LineChef/G2bittlex/bittle_pi_addon/doc/06_open.png

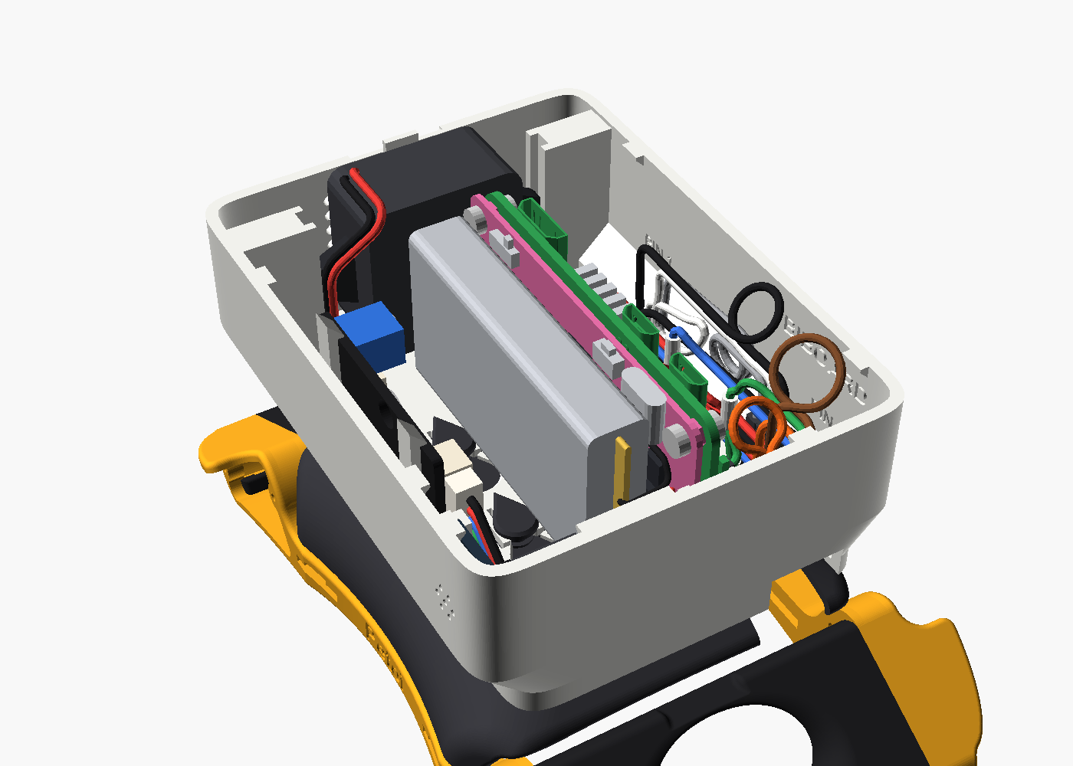
bittle_pi_addon/doc/06_open.png
