LineChef/G2bittlex/bittle_pi_addon/doc/08_section.png

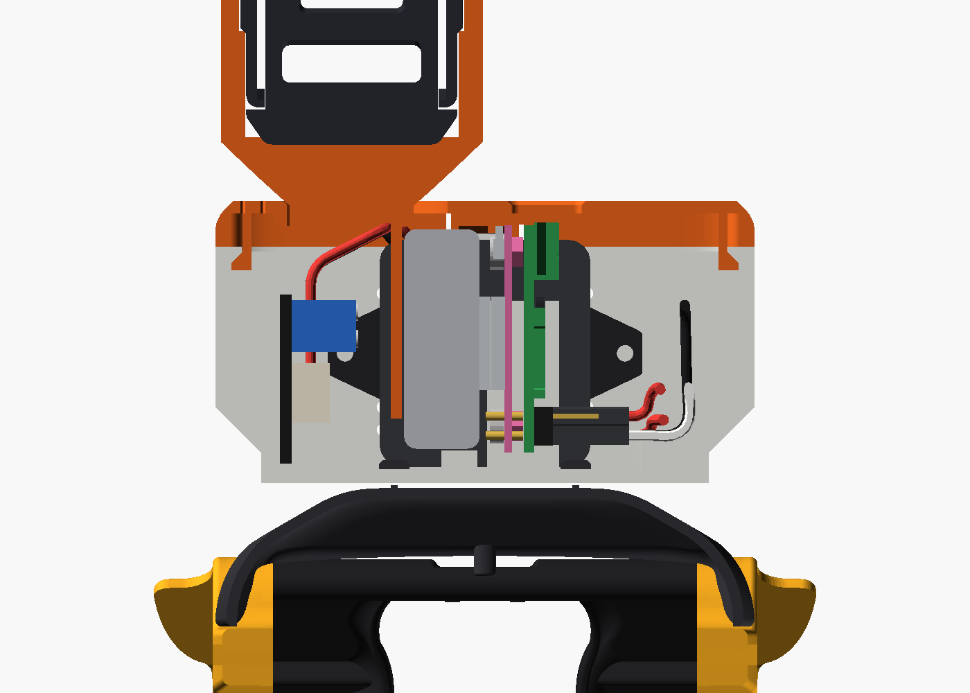
bittle_pi_addon/doc/08_section.png
