LineChef/G2bittlex/bittle_pi_addon/doc/09_wires.png

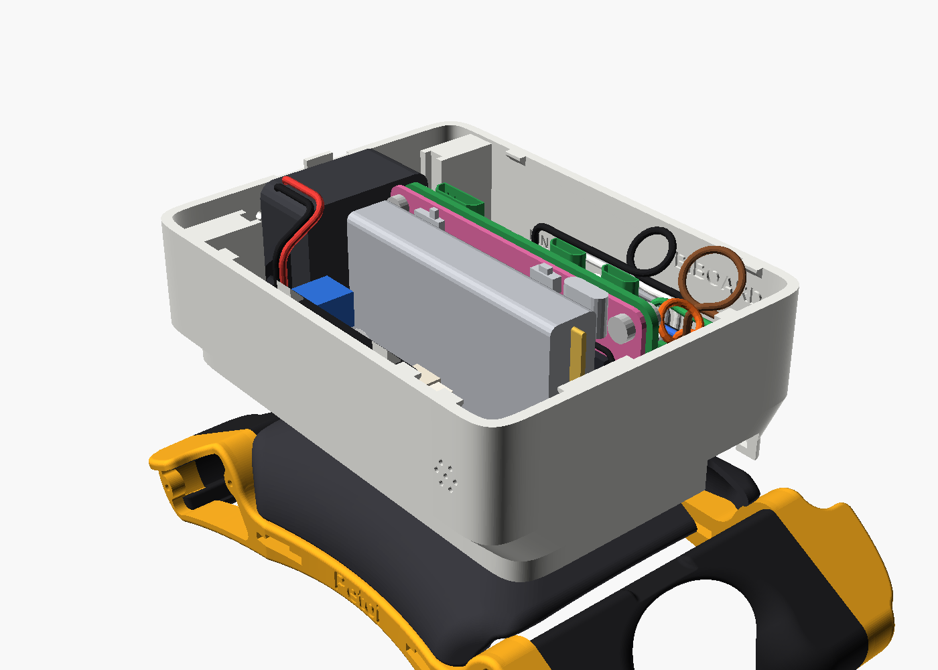
bittle_pi_addon/doc/09_wires.png
