LineChef/G2bittlex/bittle_pi_addon/doc/10_exploded.png

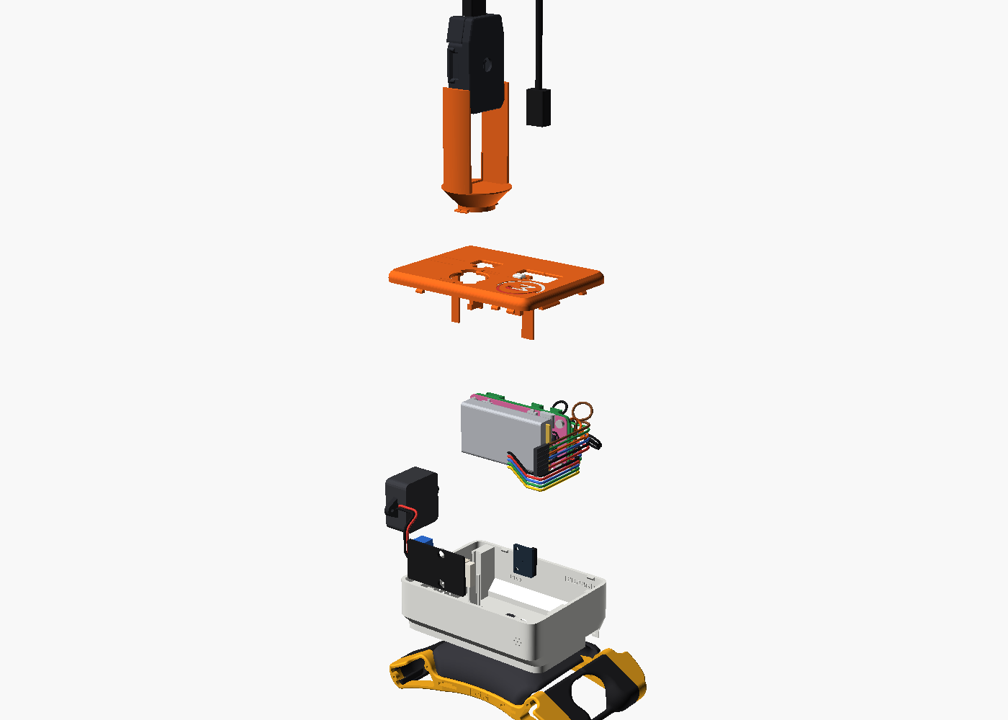
bittle_pi_addon/doc/10_exploded.png
