LineChef/G2bittlex/bittle_pi_addon/doc/11_wires_top.png

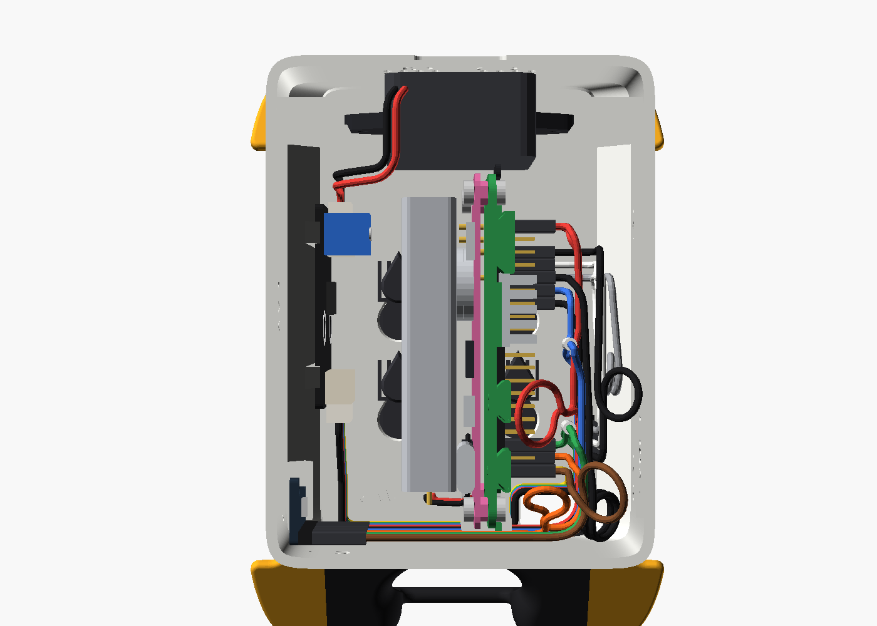
bittle_pi_addon/doc/11_wires_top.png
