LineChef/G2bittlex/bittle_pi_addon/doc/13_routing_top.png

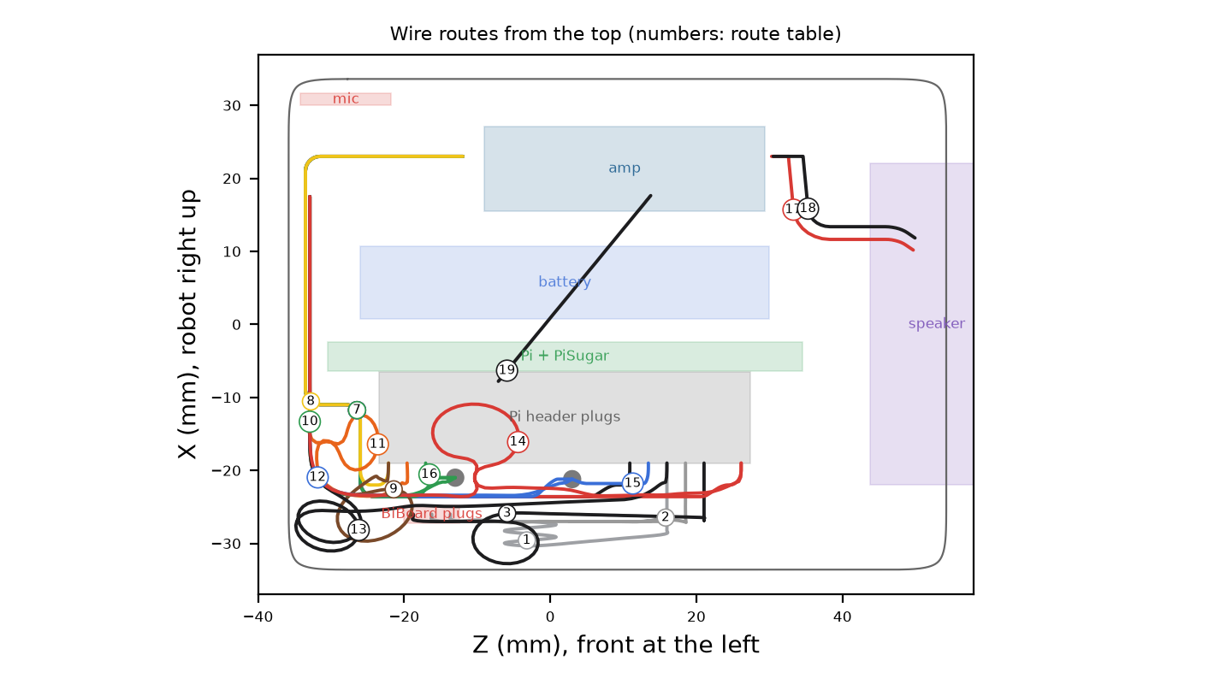
bittle_pi_addon/doc/13_routing_top.png
