LineChef/G2bittlex/bittle_pi_addon/doc/14_routing_side.png

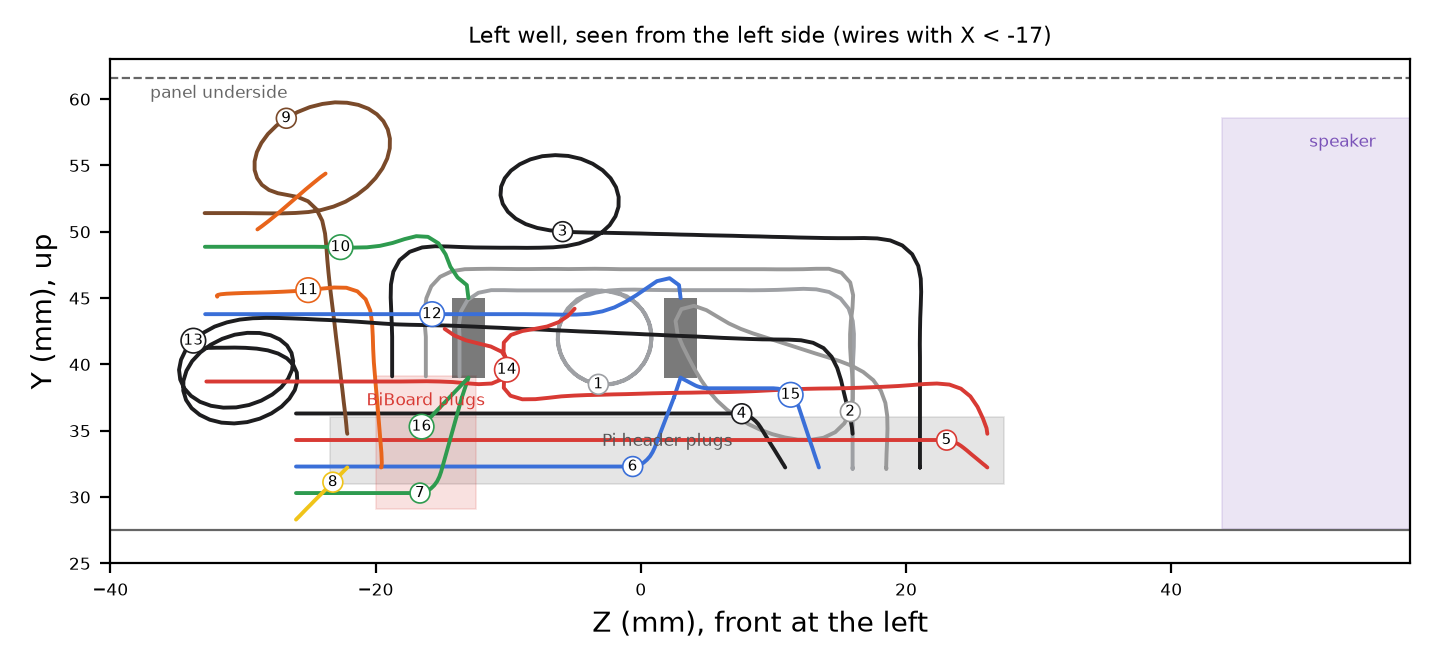
bittle_pi_addon/doc/14_routing_side.png
