LineChef/G2bittlex/bittle_pi_addon/doc/16_camera_cable.png

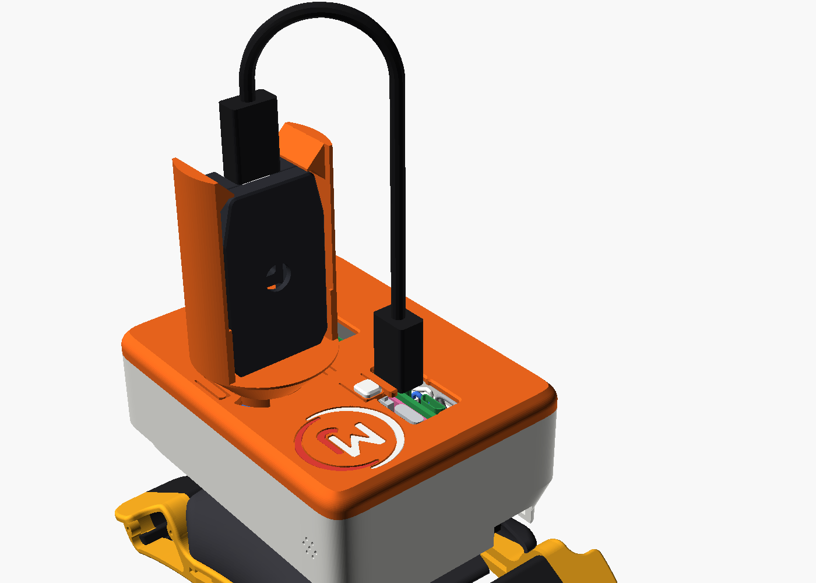
bittle_pi_addon/doc/16_camera_cable.png
