LineChef/G2bittlex/bittle_pi_addon/doc/17_camera_low.png

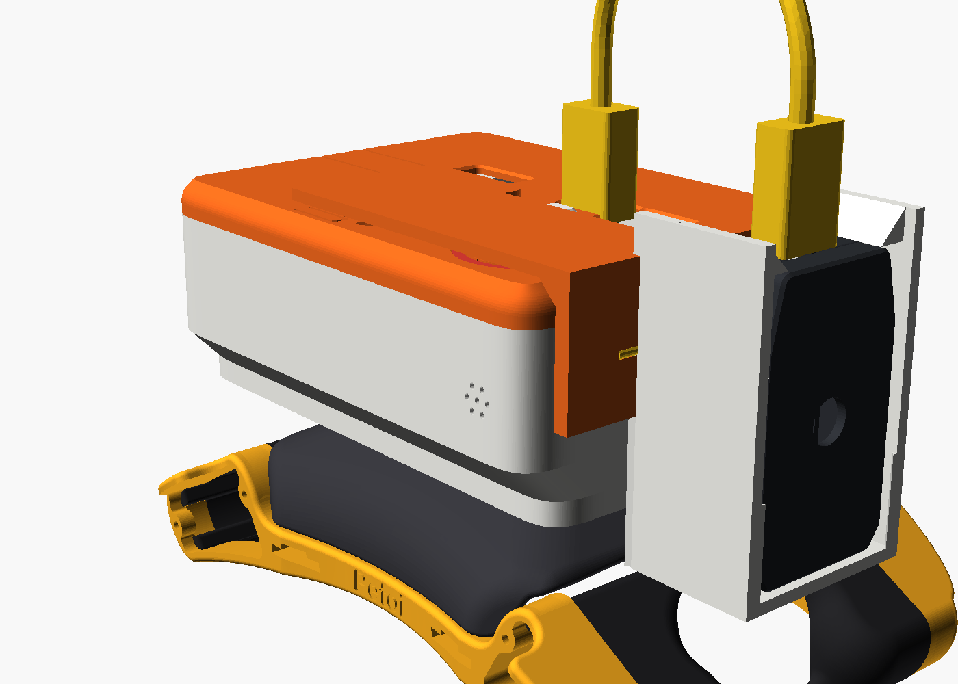
bittle_pi_addon/doc/17_camera_low.png
