LineChef/G2bittlex/bittle_pi_addon/doc/iso/camera_low-dark.png

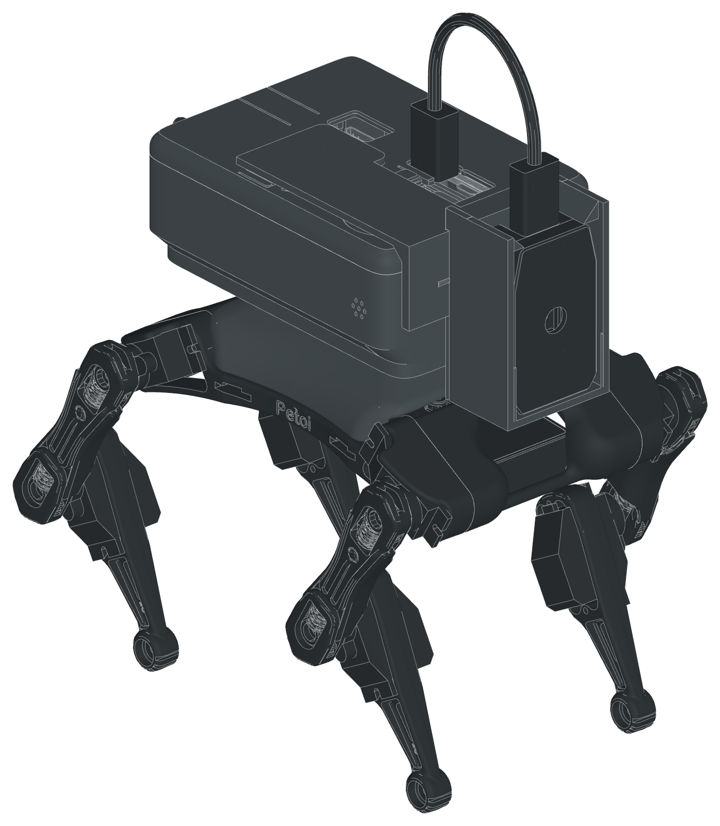
bittle_pi_addon/doc/iso/camera_low-dark.png
