LineChef/G2bittlex/bittle_pi_addon/doc/iso/hero-dark.png

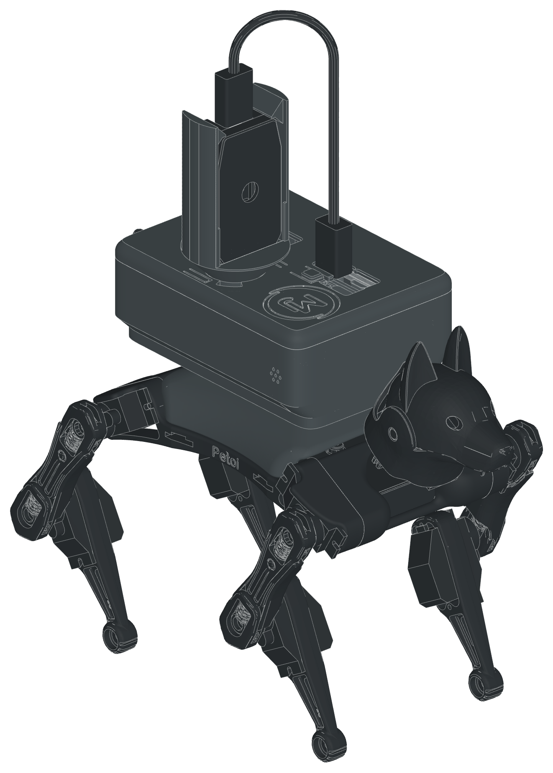
bittle_pi_addon/doc/iso/hero-dark.png
