LineChef/G2bittlex/bittle_pi_addon/doc/iso/open-dark.png

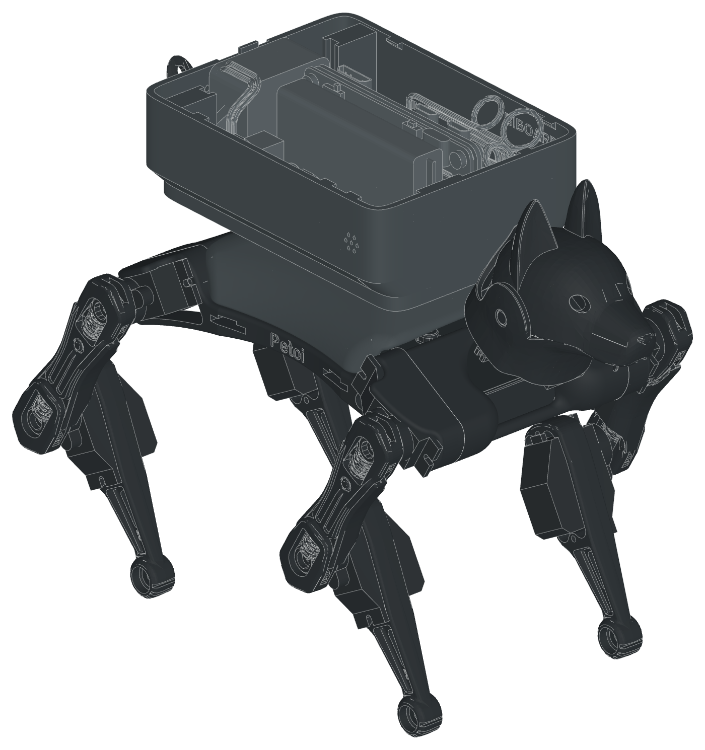
bittle_pi_addon/doc/iso/open-dark.png
