LineChef/G2bittlex/bittle_pi_addon/doc/iso/top-dark.png

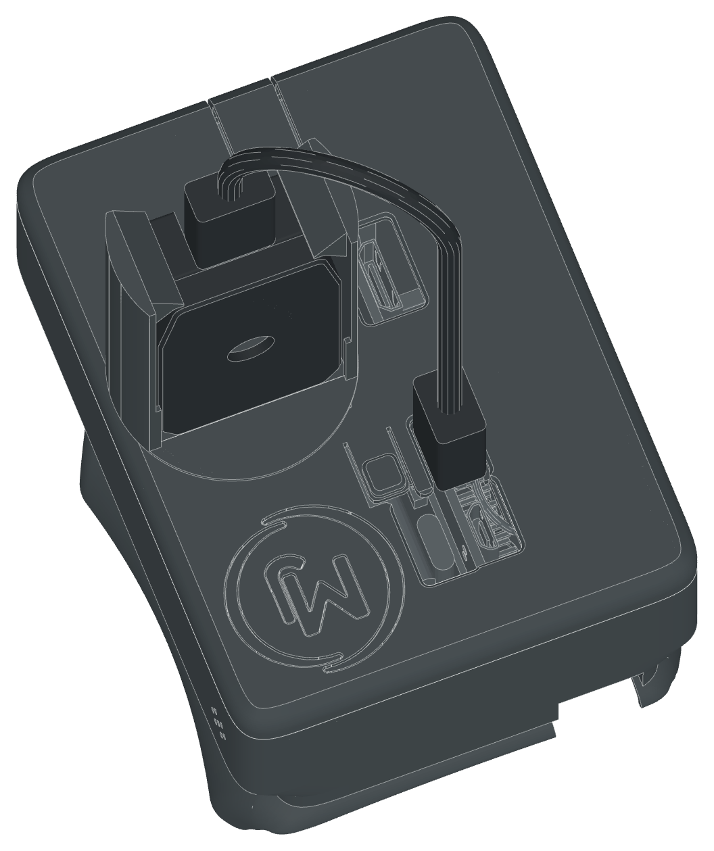
bittle_pi_addon/doc/iso/top-dark.png
