LineChef/G2bittlex/bittle_platform/doc/iso/platform-dark.png

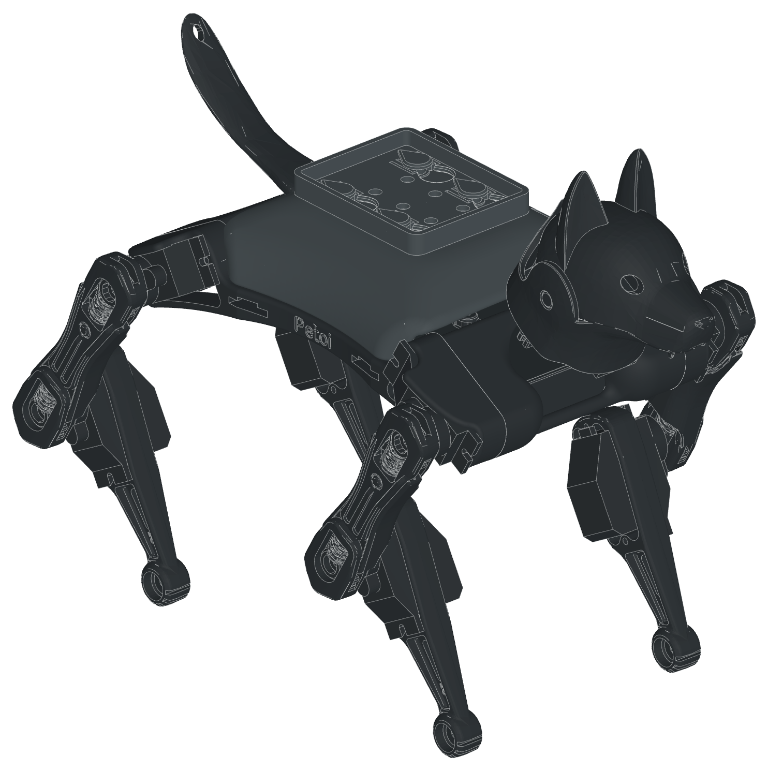
bittle_platform/doc/iso/platform-dark.png
