LineChef/G2bittlex/bittle_pi_addon/cad/pod_panel.step

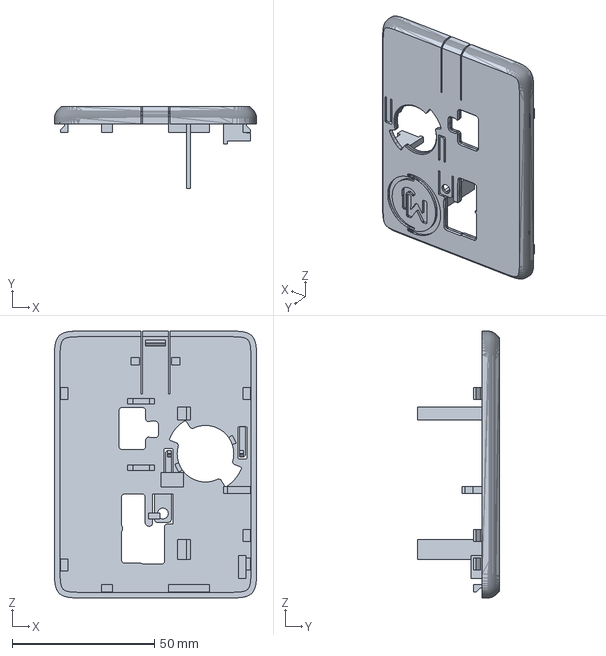
[picture p55: CAD file, 2026-10-18]
bittle_pi_addon/cad/pod_panel.step
71.2 x 28.7 x 94.0 mm
