LineChef/G2bittlex/bittle_pi_addon/reference/RaspberryPiZeroW-1.STL

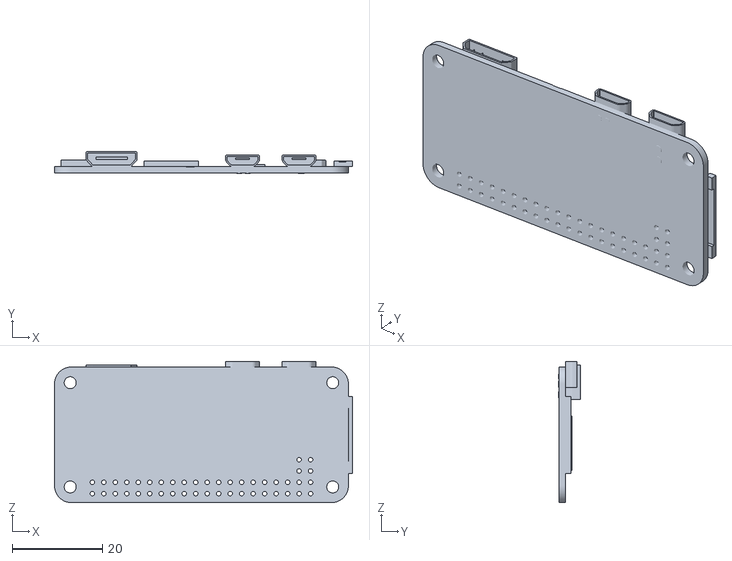
[picture p56: CAD file, 2026-10-14]
bittle_pi_addon/reference/RaspberryPiZeroW-1.STL
65.9 x 4.80 x 31.2
