LineChef/G2bittlex/bittle_pi_addon/stl/models/battery.stl

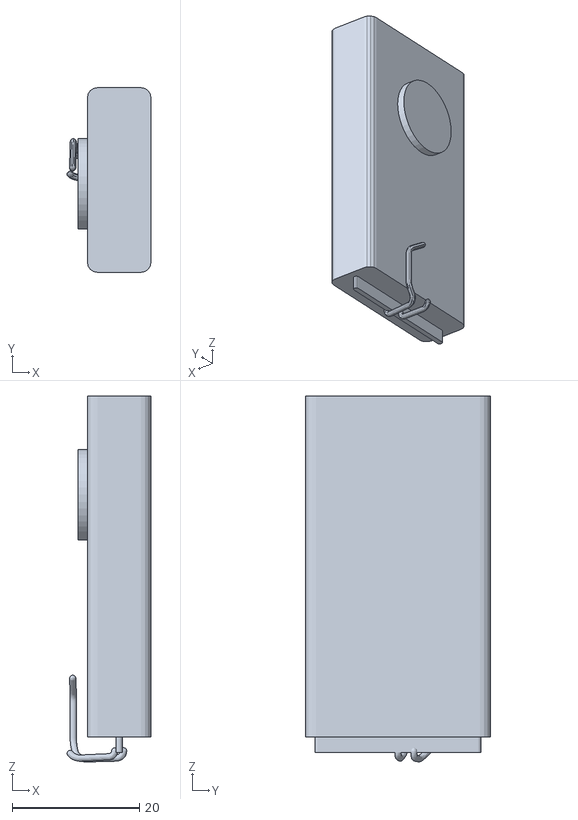
[picture p57: CAD file, 2026-10-18]
bittle_pi_addon/stl/models/battery.stl
13.2 x 29.0 x 57.5
