LineChef/G2bittlex/bittle_pi_addon/stl/models/parts/pisugar_s__button.stl

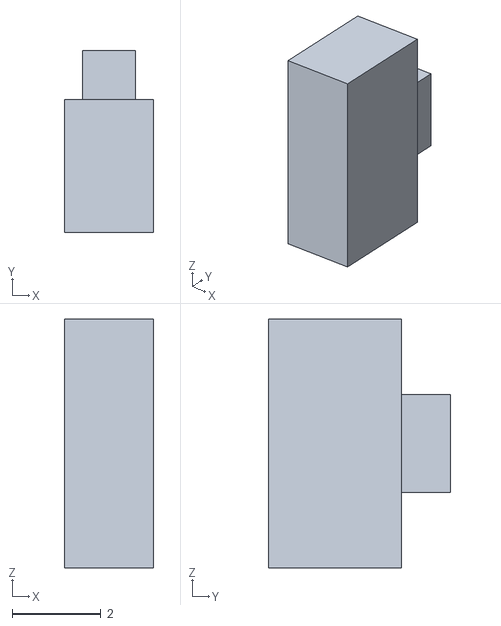
[picture p58: CAD file, 2026-10-18]
bittle_pi_addon/stl/models/parts/pisugar_s__button.stl
2.00 x 4.10 x 5.60
