LineChef/G2bittlex/bittle_pi_addon/stl/print/pod_logo_red.stl

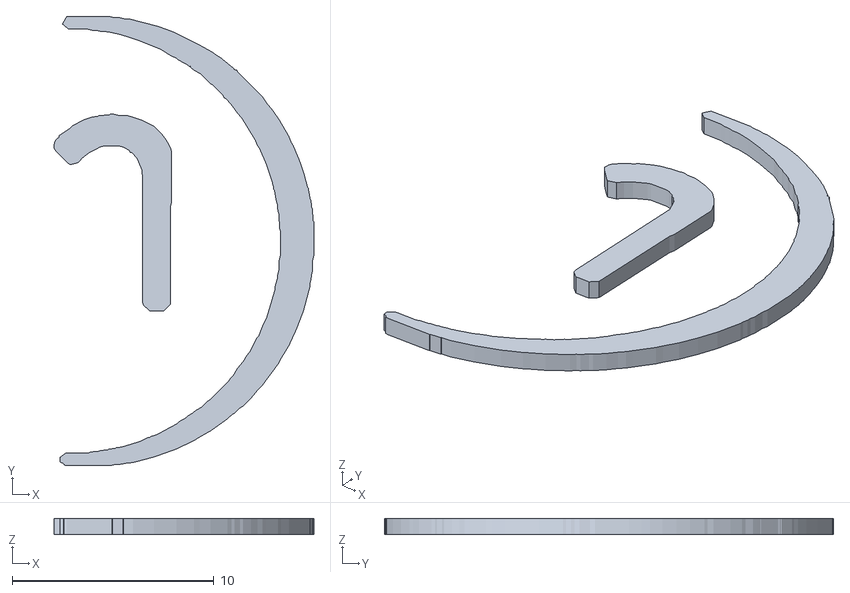
[picture p59: CAD file, 2026-10-16]
bittle_pi_addon/stl/print/pod_logo_red.stl
12.9 x 22.3 x 0.8
