LineChef/G2bittlex/bittle_platform/reference/Bittle_tail.stl

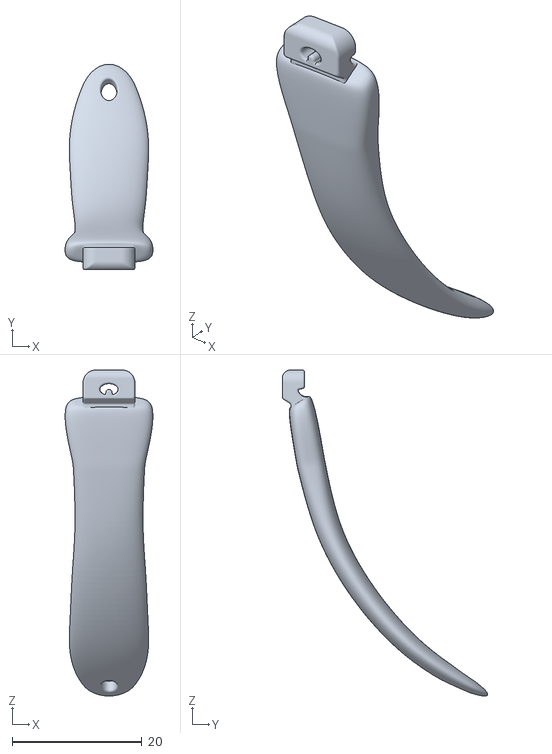
[picture p61: CAD file, 2026-10-14]
bittle_platform/reference/Bittle_tail.stl
13.5 x 31.7 x 50.2
