LineChef/G2bittlex/bittle_platform/reference/petoi_ros/tube_lf_1.stl

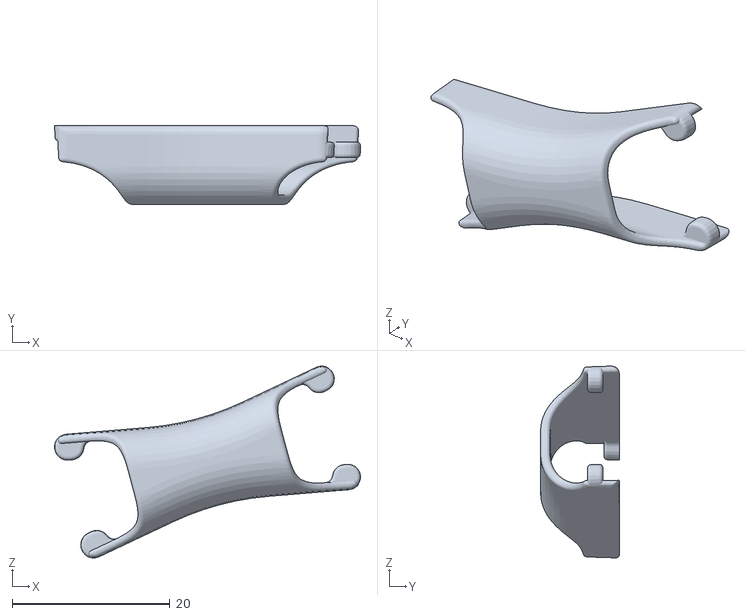
[picture p62: CAD file, 2026-10-14]
bittle_platform/reference/petoi_ros/tube_lf_1.stl
38.8 x 10.0 x 24.4
