LineChef/G2bittlex/bittle_platform/stl/installed/cover_pegs.stl

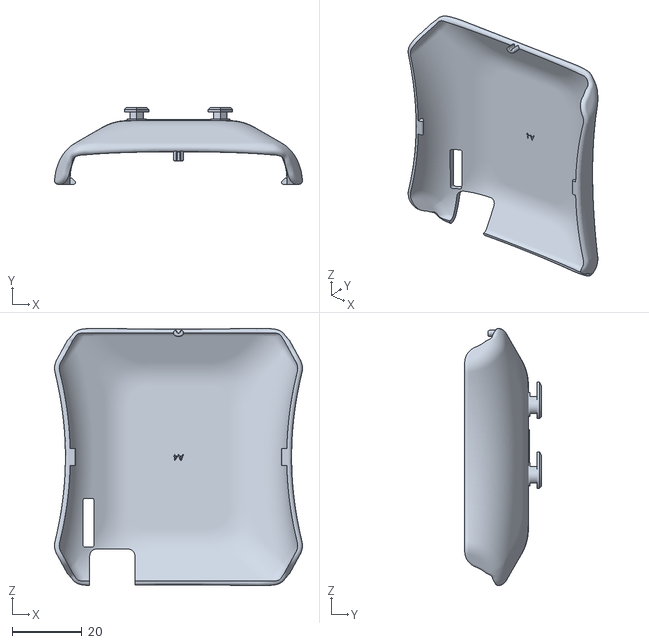
[picture p63: CAD file, 2026-10-16]
bittle_platform/stl/installed/cover_pegs.stl
71.2 x 22.0 x 73.9
