LineChef/G2bittlex/bittle_platform/stl/robot/head.stl

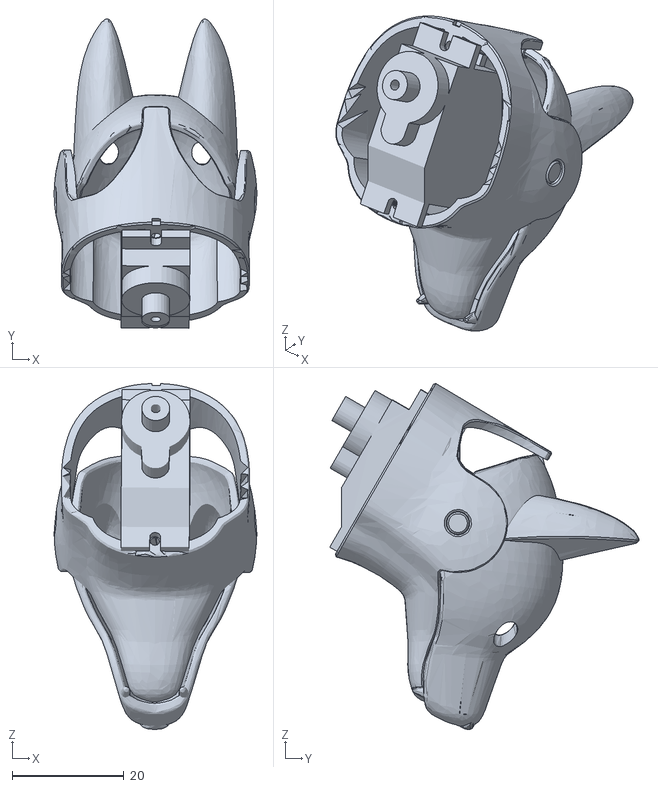
[picture p64: CAD file, 2026-10-14]
bittle_platform/stl/robot/head.stl
36.2 x 55.3 x 61.8
