LineChef/G2bittlex/bittle_pi_addon/cad/pod_camera_cradle_low.step

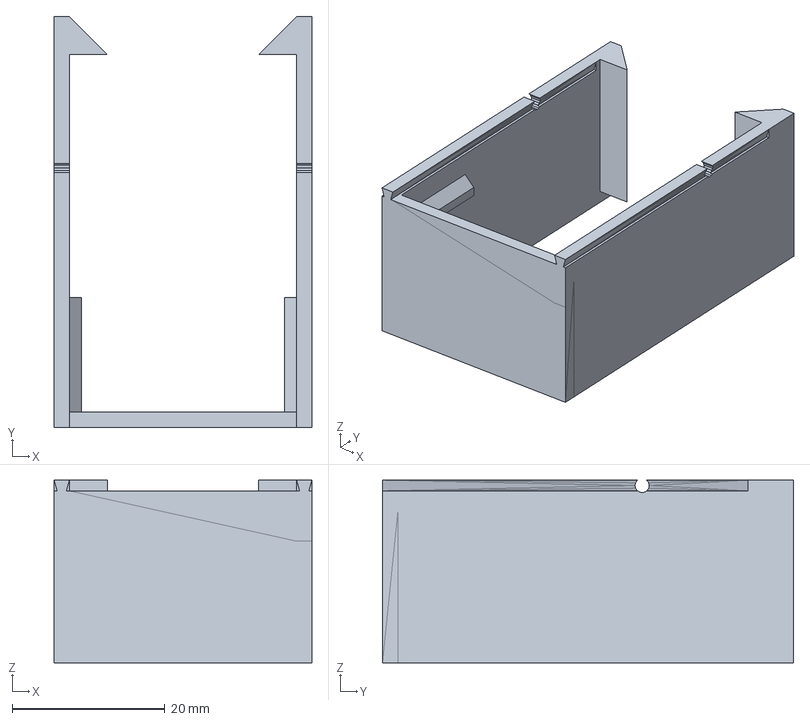
[picture p65: CAD file, 2026-10-17]
bittle_pi_addon/cad/pod_camera_cradle_low.step
33.8 x 53.9 x 24.0 mm
