LineChef/G2bittlex/bittle_pi_addon/stl/models/parts/pisugar_s__pins.stl

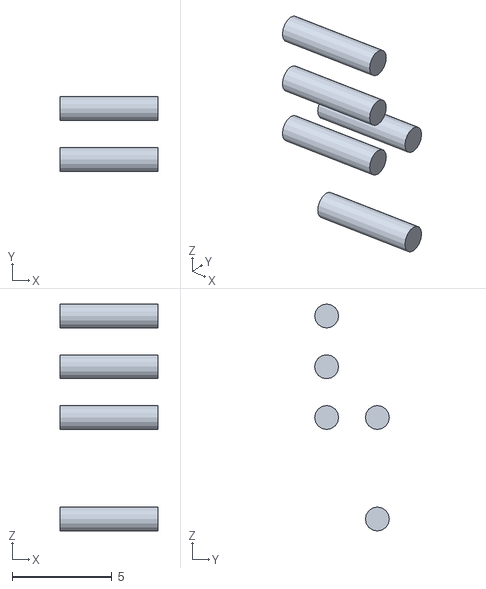
[picture p66: CAD file, 2026-10-18]
bittle_pi_addon/stl/models/parts/pisugar_s__pins.stl
4.90 x 3.74 x 11.4
