LineChef/G2bittlex/bittle_pi_addon/stl/models/pisugar_s.stl

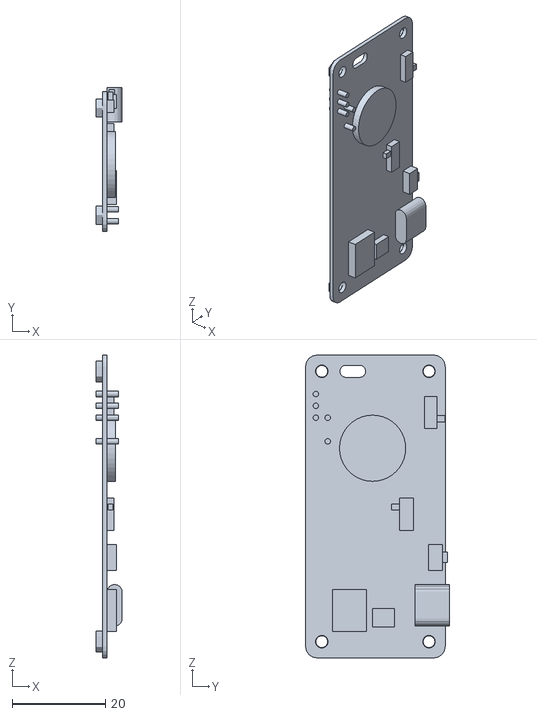
[picture p67: CAD file, 2026-10-18]
bittle_pi_addon/stl/models/pisugar_s.stl
5.66 x 30.9 x 65.0
