LineChef/G2bittlex/bittle_pi_addon/stl/print/pod_logo_white.stl

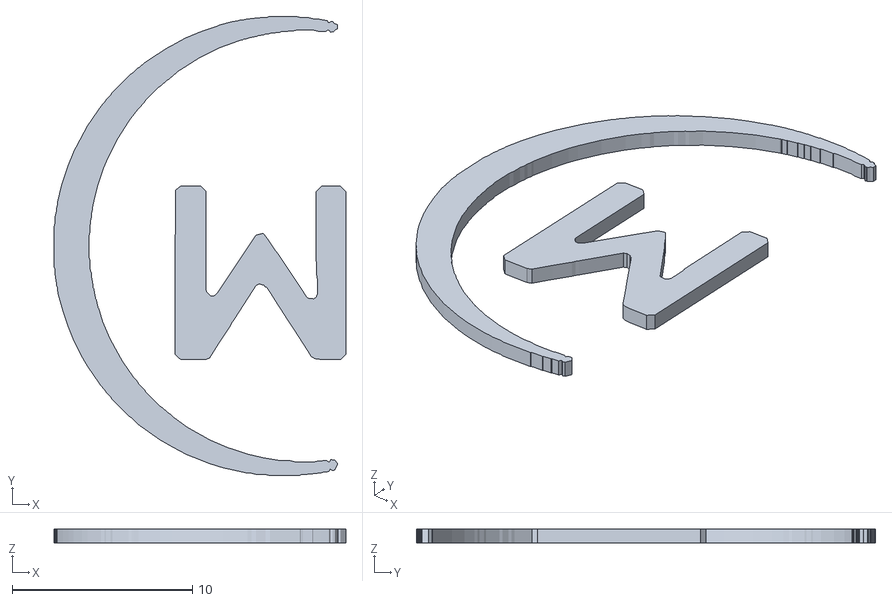
[picture p68: CAD file, 2026-10-16]
bittle_pi_addon/stl/print/pod_logo_white.stl
16.2 x 25.4 x 0.8
