LineChef/G2bittlex/bittle_platform/cad/pegs.step

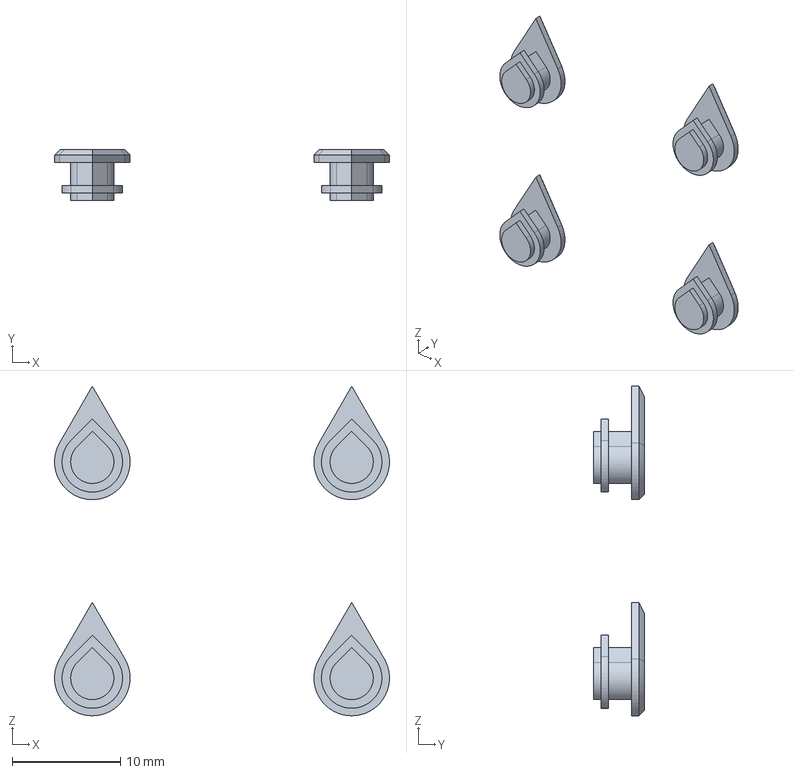
[picture p69: CAD file, 2026-10-16]
bittle_platform/cad/pegs.step
31.0 x 4.70 x 30.5 mm
