LineChef/G2bittlex/bittle_platform/reference/Bittle_Cover.stl

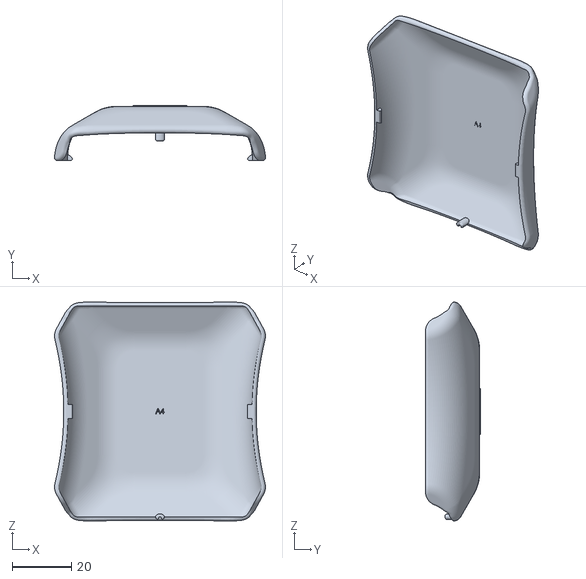
[picture p70: CAD file, 2026-10-14]
bittle_platform/reference/Bittle_Cover.stl
71.2 x 18.6 x 73.9
