LineChef/G2bittlex/bittle_platform/reference/petoi_ros/servo_lfs_1.stl

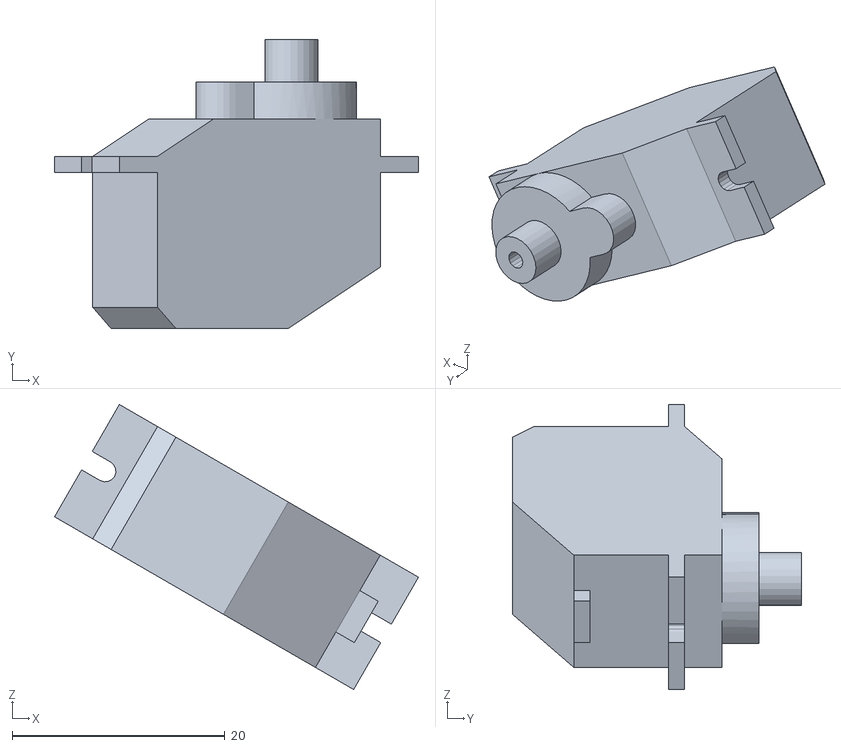
[picture p71: CAD file, 2026-10-14]
bittle_platform/reference/petoi_ros/servo_lfs_1.stl
34.2 x 27.2 x 26.8
