LineChef/G2bittlex/bittle_platform/stl/installed/keepout.stl

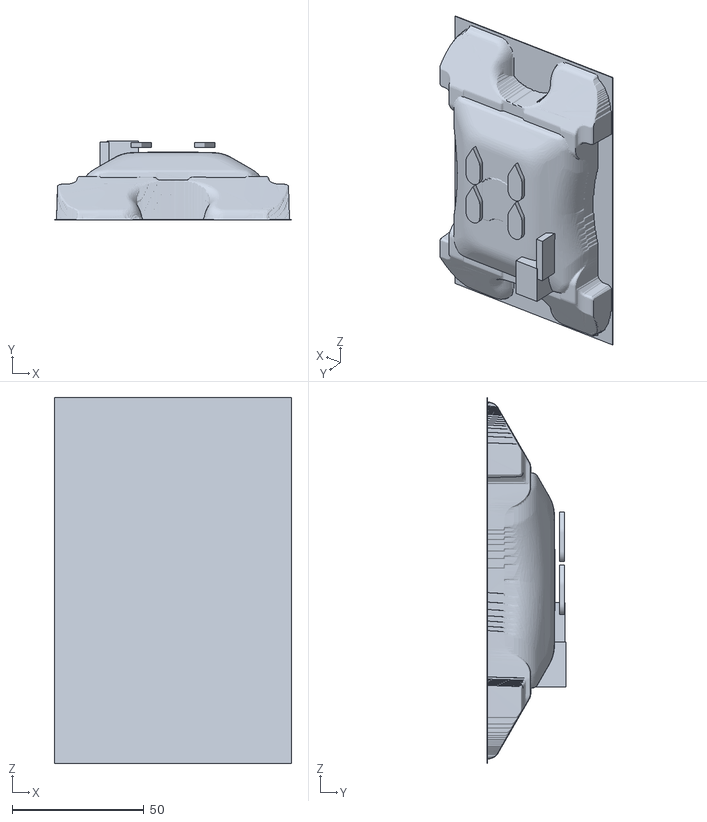
[picture p72: CAD file, 2026-10-16]
bittle_platform/stl/installed/keepout.stl
90.0 x 30.0 x 138.8
