LineChef/G2bittlex/bittle_platform/stl/robot/hip_servos.stl

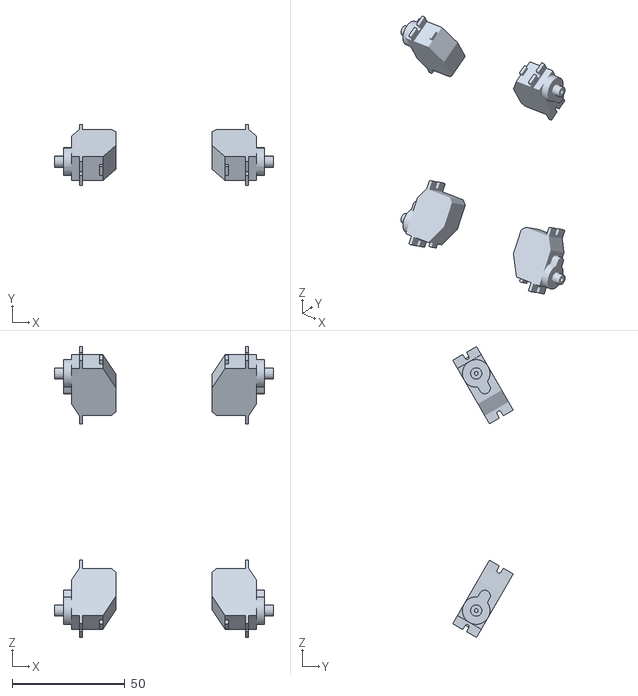
[picture p74: CAD file, 2026-10-14]
bittle_platform/stl/robot/hip_servos.stl
97.0 x 26.8 x 128.9
