LineChef/G2bittlex/bittle_pi_addon/cad/pod_button.step

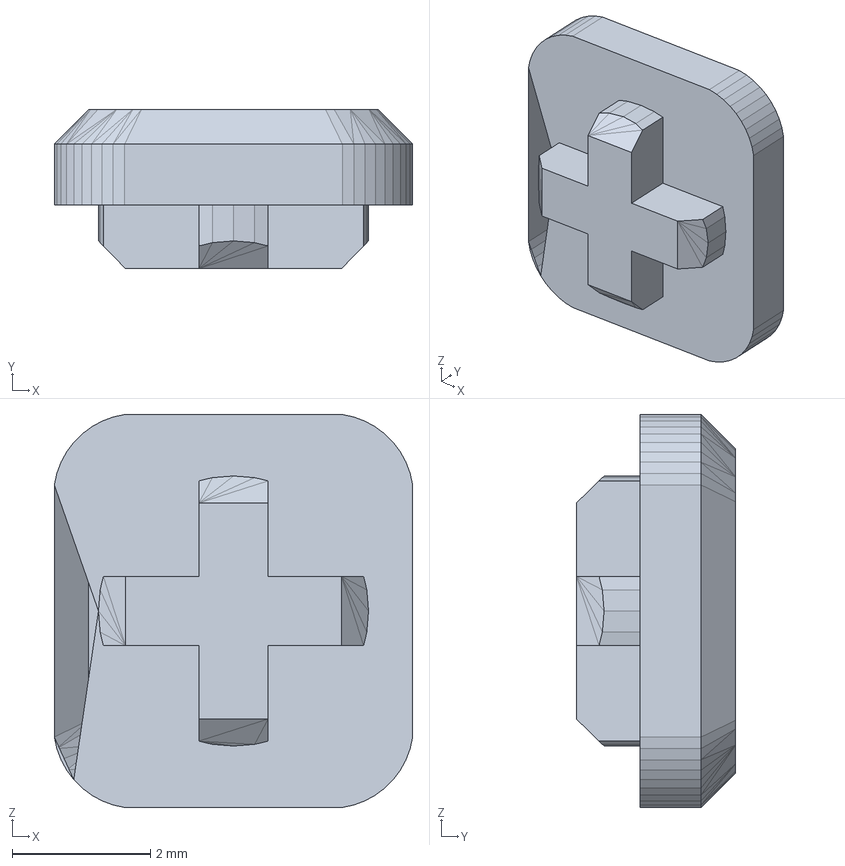
[picture p75: CAD file, 2026-10-17]
bittle_pi_addon/cad/pod_button.step
5.18 x 2.30 x 5.68 mm
