LineChef/G2bittlex/bittle_pi_addon/stl/models/camera.stl

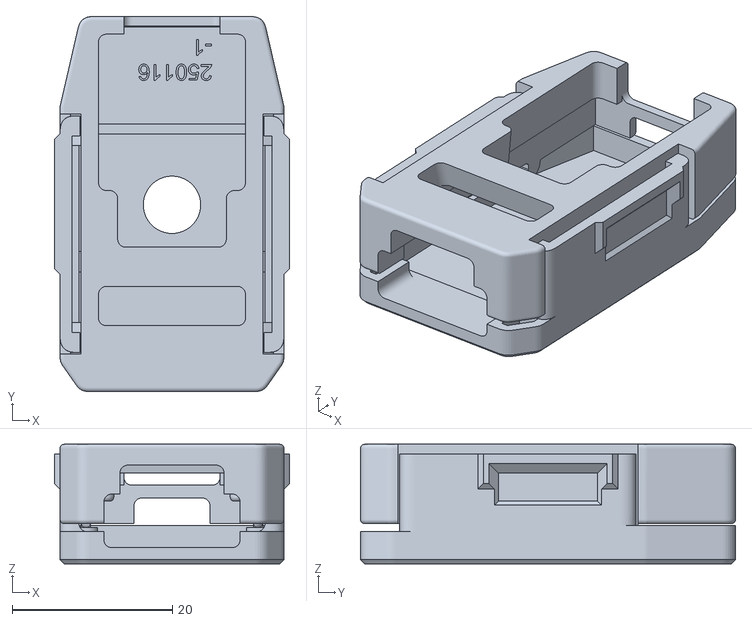
[picture p76: CAD file, 2026-10-17]
bittle_pi_addon/stl/models/camera.stl
29.3 x 46.8 x 14.9
