LineChef/G2bittlex/bittle_pi_addon/stl/models/parts/pisugar_s__usb_c.stl

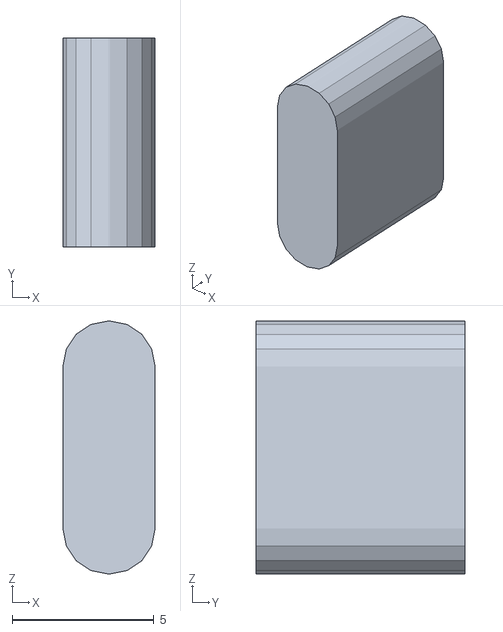
[picture p77: CAD file, 2026-10-18]
bittle_pi_addon/stl/models/parts/pisugar_s__usb_c.stl
3.26 x 7.40 x 8.94
