LineChef/G2bittlex/bittle_platform/cad/starter_plate.step

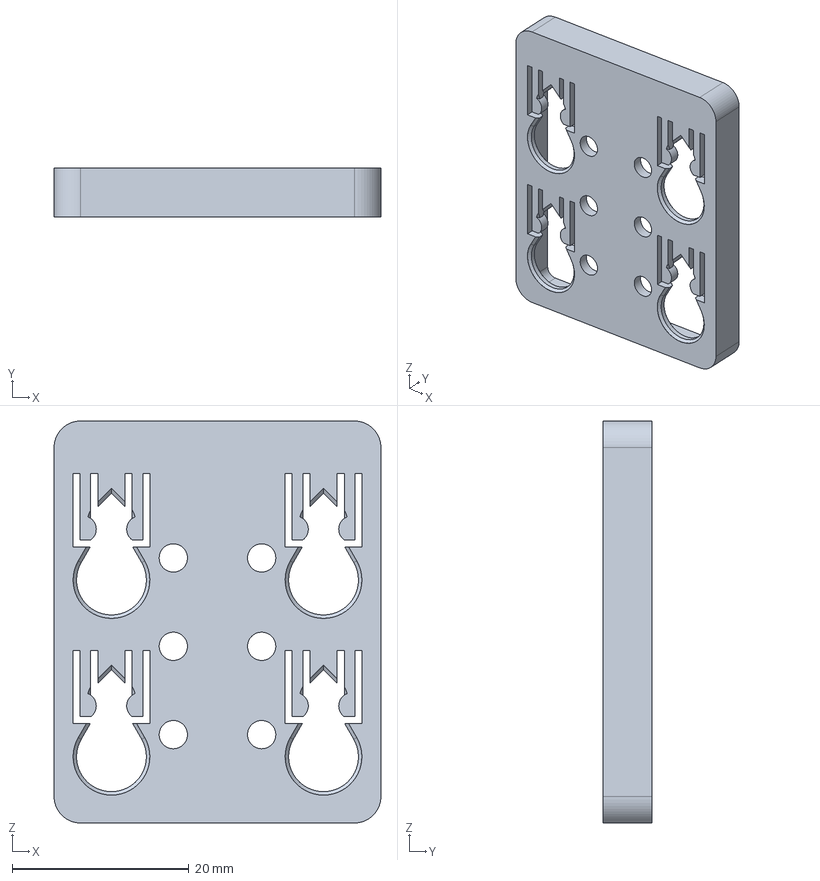
[picture p78: CAD file, 2026-10-16]
bittle_platform/cad/starter_plate.step
37.0 x 5.50 x 45.5 mm
