LineChef/G2bittlex/bittle_platform/reference/Bittle_FrontPlate.stl

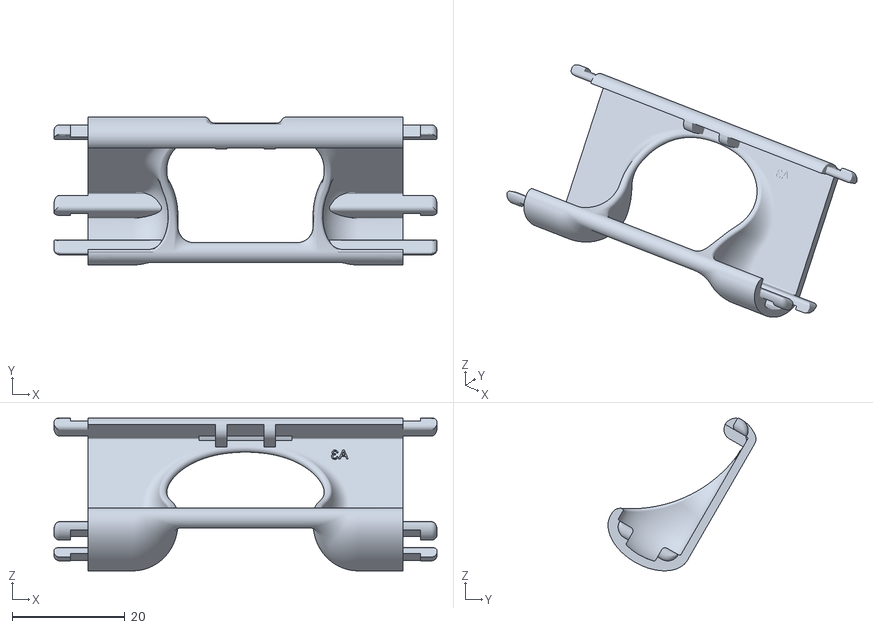
[picture p79: CAD file, 2026-10-14]
bittle_platform/reference/Bittle_FrontPlate.stl
68.0 x 26.3 x 27.1
