LineChef/G2bittlex/bittle_platform/reference/petoi_ros/c_thlf_1.stl

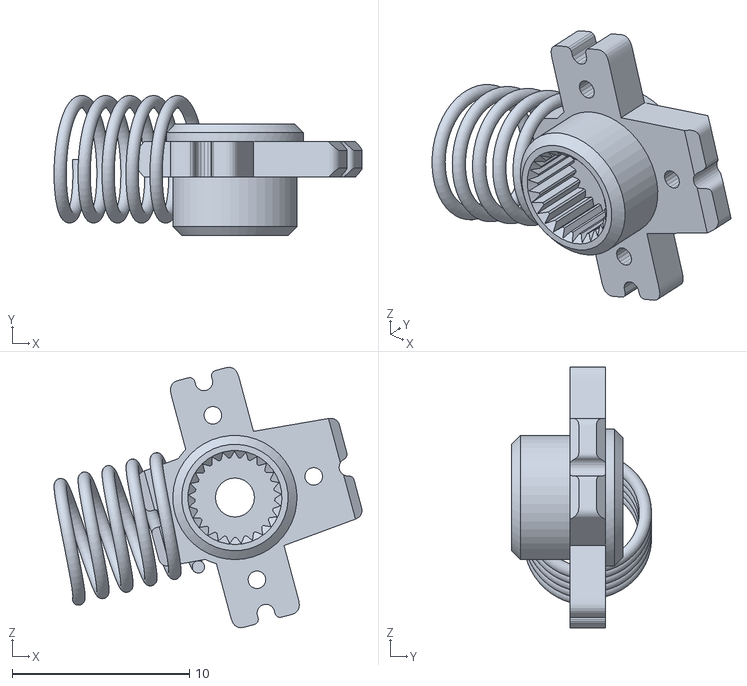
[picture p80: CAD file, 2026-10-14]
bittle_platform/reference/petoi_ros/c_thlf_1.stl
17.4 x 7.91 x 14.7
