LineChef/G2bittlex/bittle_platform/stl/robot/thigh_rf.stl

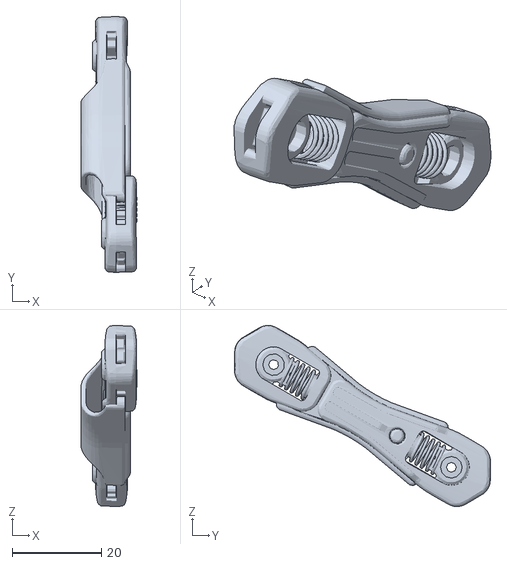
[picture p81: CAD file, 2026-10-14]
bittle_platform/stl/robot/thigh_rf.stl
12.6 x 57.4 x 40.6
