LineChef/G2bittlex/bittle_pi_addon/cad/pod_body.step

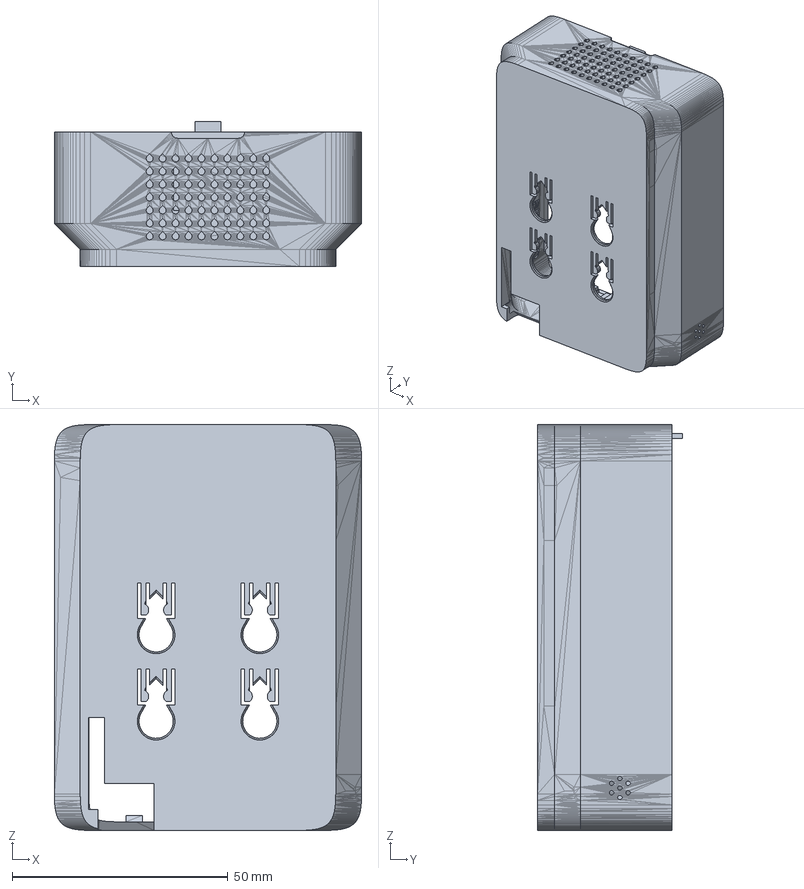
[picture p82: CAD file, 2026-10-17]
bittle_pi_addon/cad/pod_body.step
71.2 x 33.6 x 94.0 mm
