LineChef/G2bittlex/bittle_pi_addon/stl/installed/pod_camera_base_low.stl

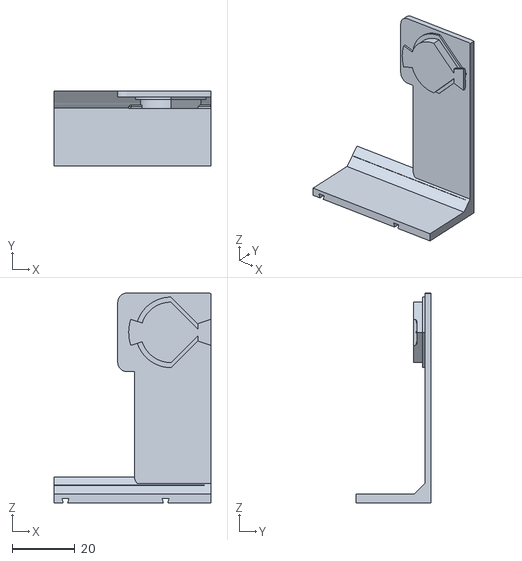
[picture p83: CAD file, 2026-10-17]
bittle_pi_addon/stl/installed/pod_camera_base_low.stl
49.8 x 23.9 x 66.7
