LineChef/G2bittlex/bittle_pi_addon/stl/models/parts/battery__disc.stl

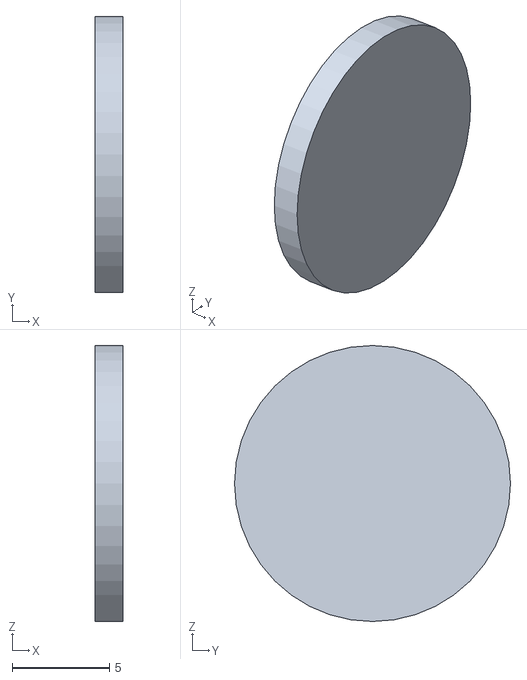
[picture p84: CAD file, 2026-10-18]
bittle_pi_addon/stl/models/parts/battery__disc.stl
1.46 x 14.2 x 14.2
