LineChef/G2bittlex/bittle_pi_addon/stl/models/wires_camera.stl

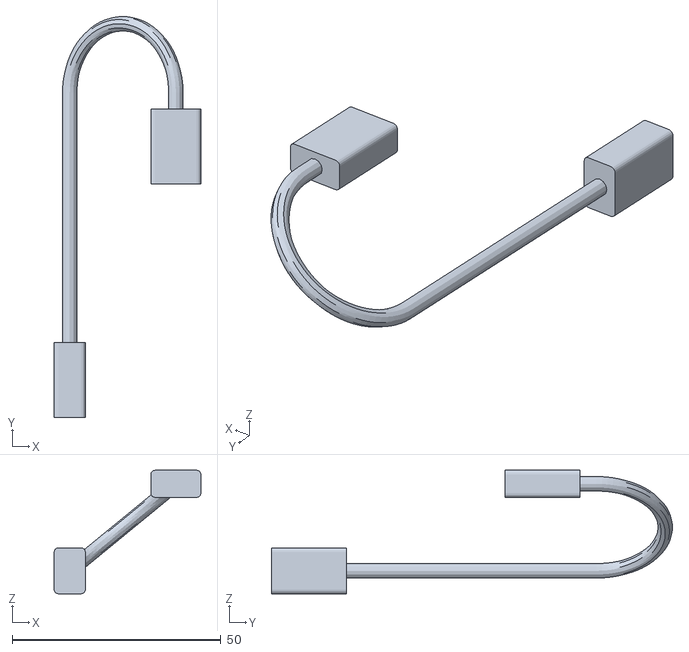
[picture p85: CAD file, 2026-10-17]
bittle_pi_addon/stl/models/wires_camera.stl
35.2 x 96.1 x 29.6
