LineChef/G2bittlex/bittle_platform/cad/keyhole_cutter.step

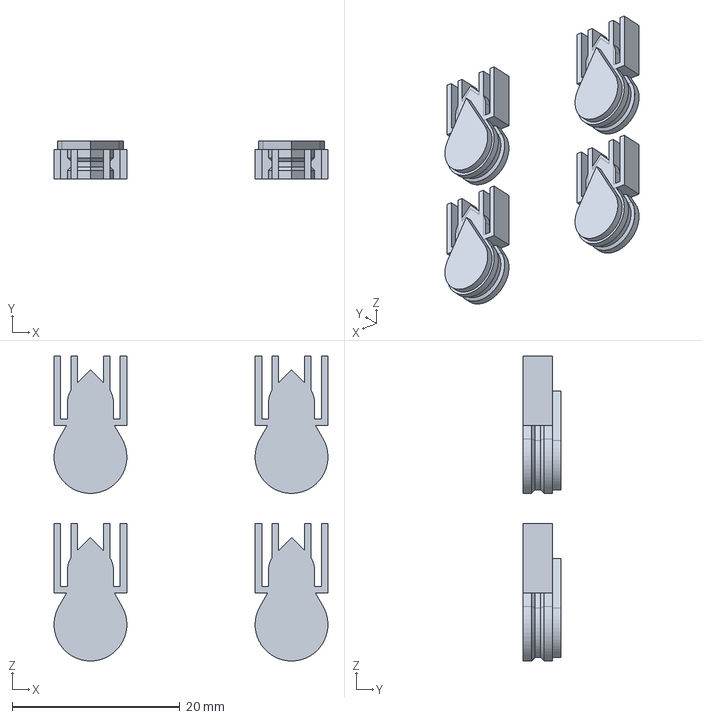
[picture p86: CAD file, 2026-10-16]
bittle_platform/cad/keyhole_cutter.step
32.7 x 4.50 x 36.4 mm
