LineChef/G2bittlex/bittle_platform/reference/Bittle_SideShoulder.stl

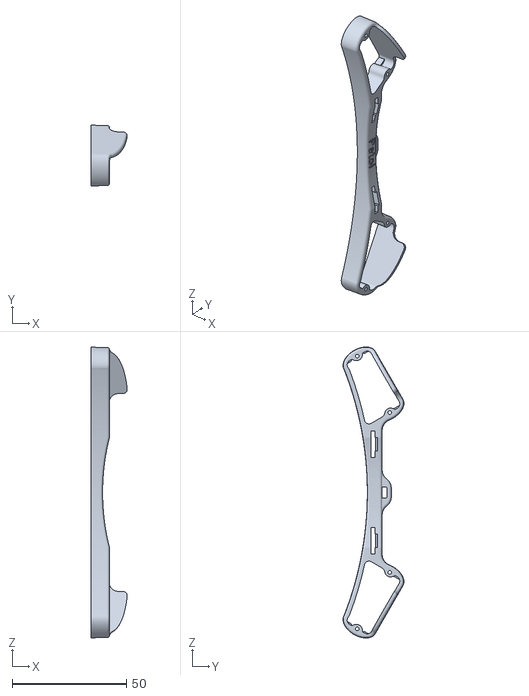
[picture p87: CAD file, 2026-10-14]
bittle_platform/reference/Bittle_SideShoulder.stl
15.9 x 26.7 x 127.3
