LineChef/G2bittlex/bittle_platform/reference/petoi_ros/servos_lf_1.stl

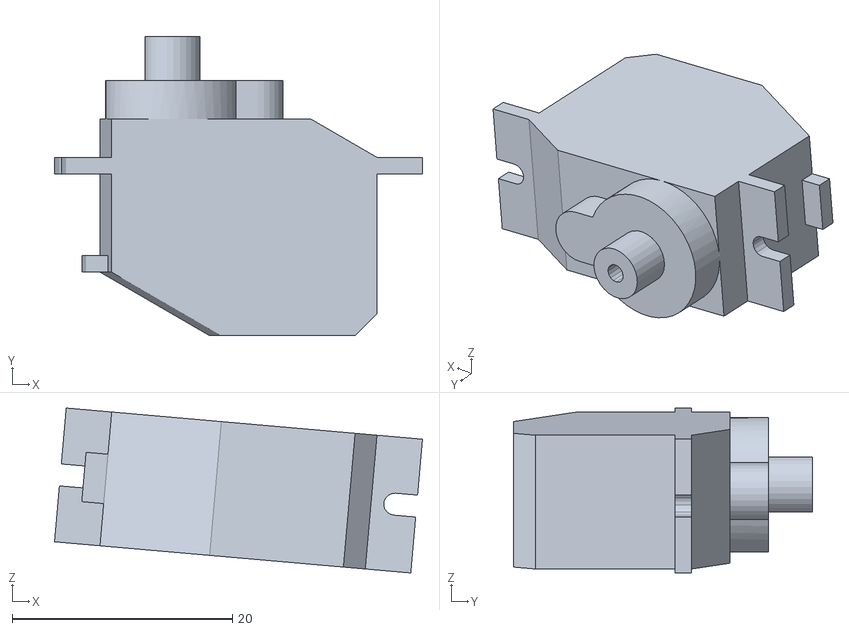
[picture p88: CAD file, 2026-10-14]
bittle_platform/reference/petoi_ros/servos_lf_1.stl
33.4 x 27.2 x 15.0
