LineChef/G2bittlex/bittle_pi_addon/cad/pod_camera_mount.step

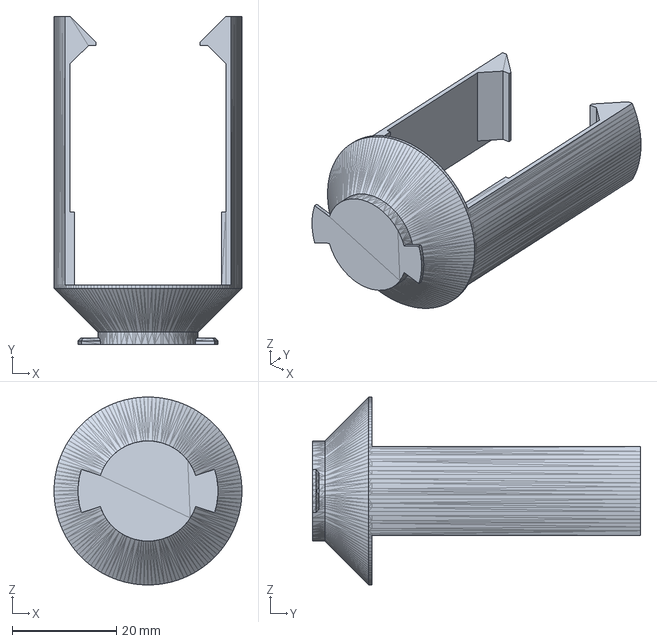
[picture p89: CAD file, 2026-10-17]
bittle_pi_addon/cad/pod_camera_mount.step
36.0 x 62.8 x 36.0 mm
