LineChef/G2bittlex/bittle_pi_addon/stl/models/parts/battery__flap.stl

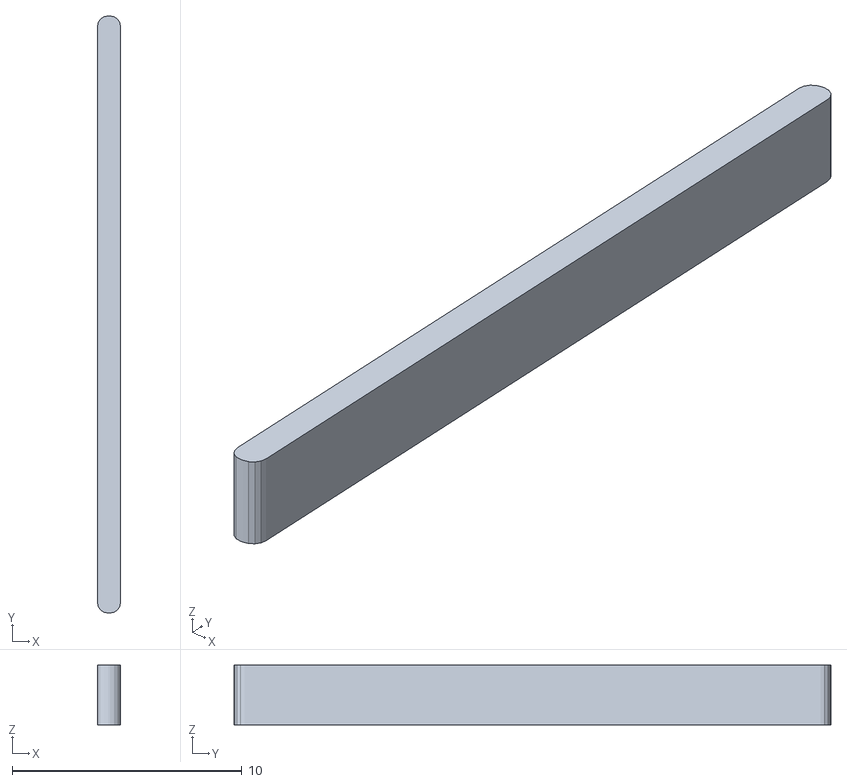
[picture p90: CAD file, 2026-10-18]
bittle_pi_addon/stl/models/parts/battery__flap.stl
1.00 x 26.0 x 2.60
