LineChef/G2bittlex/bittle_pi_addon/stl/models/wires_mic.stl

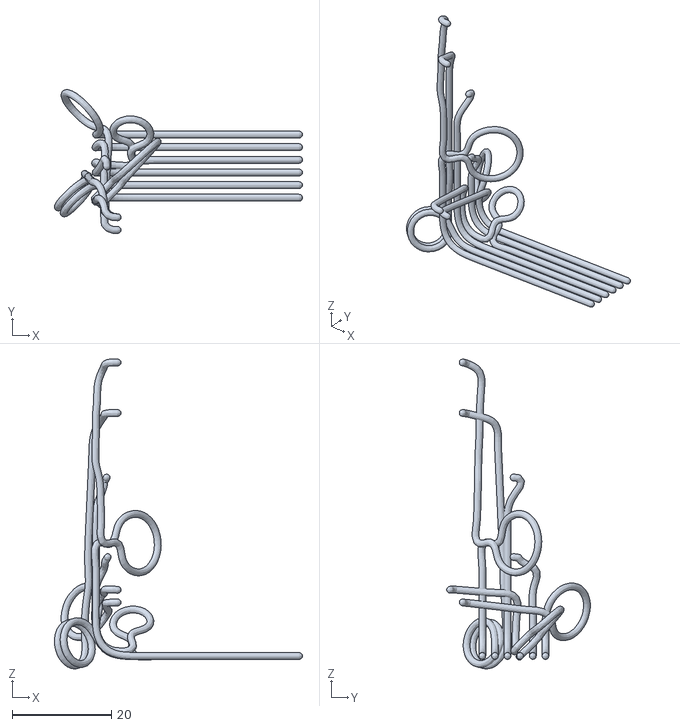
[picture p91: CAD file, 2026-10-17]
bittle_pi_addon/stl/models/wires_mic.stl
49.9 x 28.9 x 62.3
