LineChef/G2bittlex/bittle_platform/reference/petoi_ros/head__1.stl

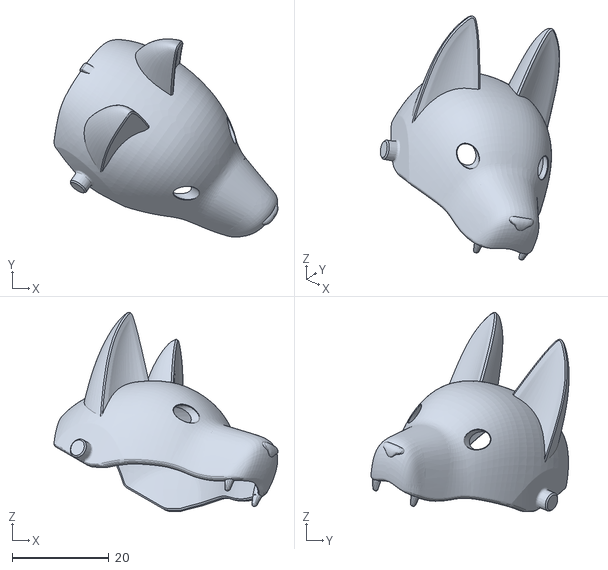
[picture p92: CAD file, 2026-10-14]
bittle_platform/reference/petoi_ros/head__1.stl
46.2 x 40.9 x 41.1
