LineChef/G2bittlex/bittle_pi_addon/stl/models/parts/battery__cell.stl

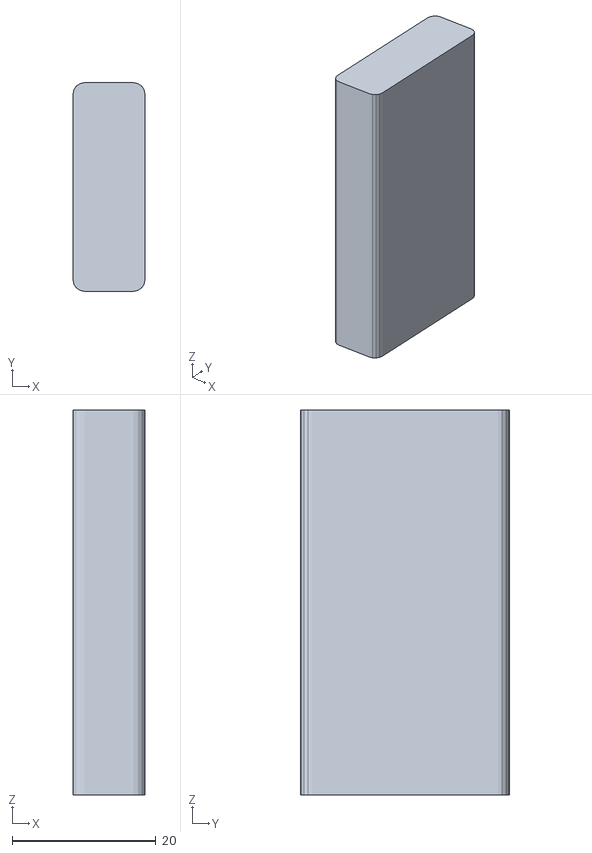
[picture p93: CAD file, 2026-10-18]
bittle_pi_addon/stl/models/parts/battery__cell.stl
10.00 x 29.0 x 53.5
