LineChef/G2bittlex/bittle_pi_addon/stl/models/wire_paths.stl

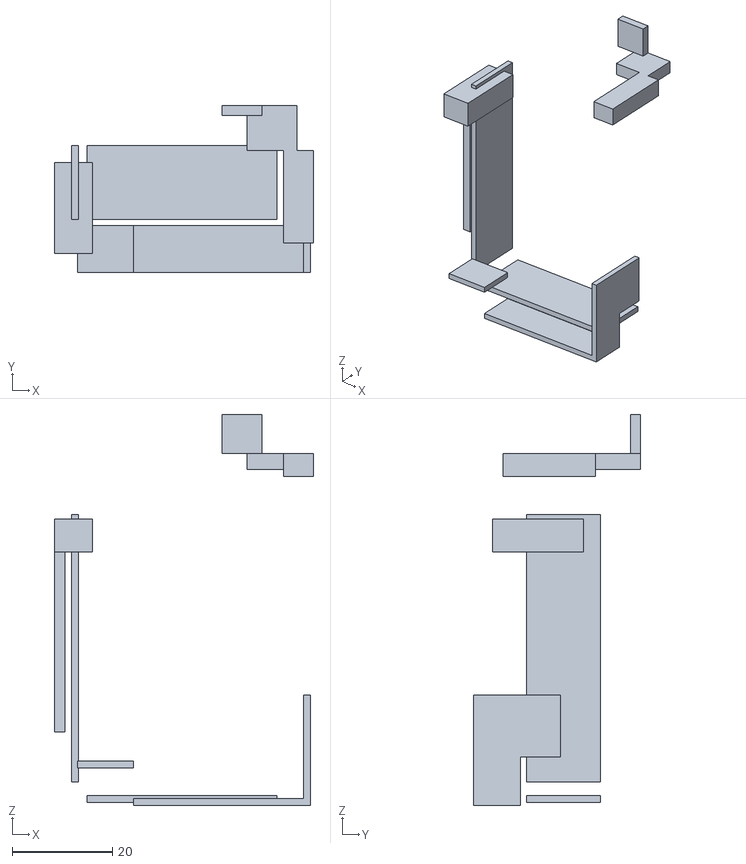
[picture p94: CAD file, 2026-10-17]
bittle_pi_addon/stl/models/wire_paths.stl
51.8 x 33.4 x 78.2
