LineChef/G2bittlex/bittle_platform/reference/petoi_ros/shank_lf_1.stl

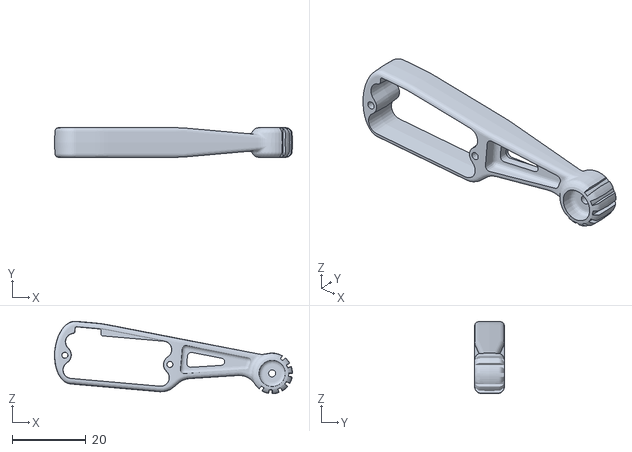
[picture p95: CAD file, 2026-10-14]
bittle_platform/reference/petoi_ros/shank_lf_1.stl
64.3 x 8.00 x 19.6
