LineChef/G2bittlex/bittle_platform/stl/robot/shank_rr.stl

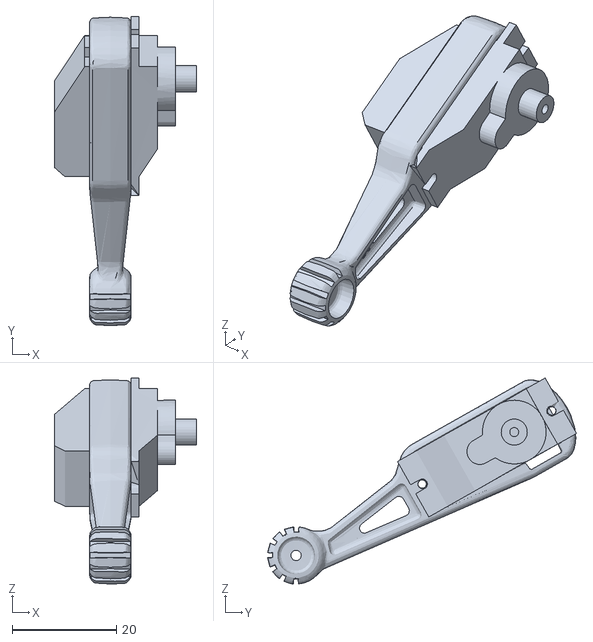
[picture p96: CAD file, 2026-10-14]
bittle_platform/stl/robot/shank_rr.stl
27.2 x 59.2 x 39.5
