LineChef/G2bittlex/bittle_pi_addon/stl/models/parts/pisugar_s__switch.stl

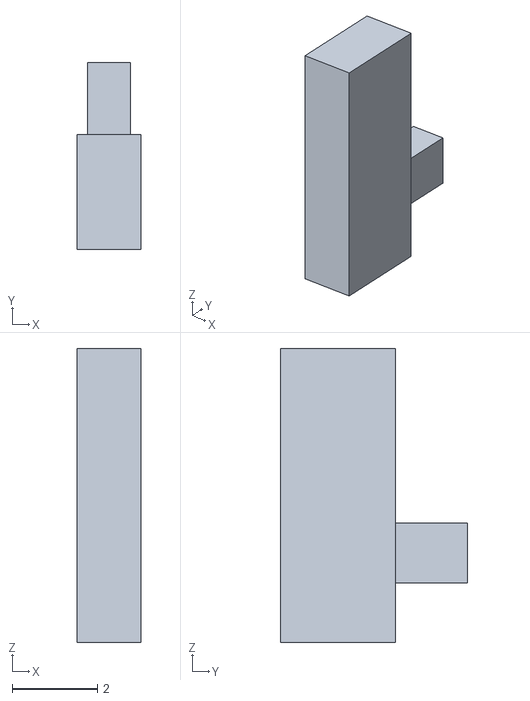
[picture p97: CAD file, 2026-10-18]
bittle_pi_addon/stl/models/parts/pisugar_s__switch.stl
1.50 x 4.40 x 6.90
