LineChef/G2bittlex/bittle_pi_addon/stl/models/wires_amp.stl

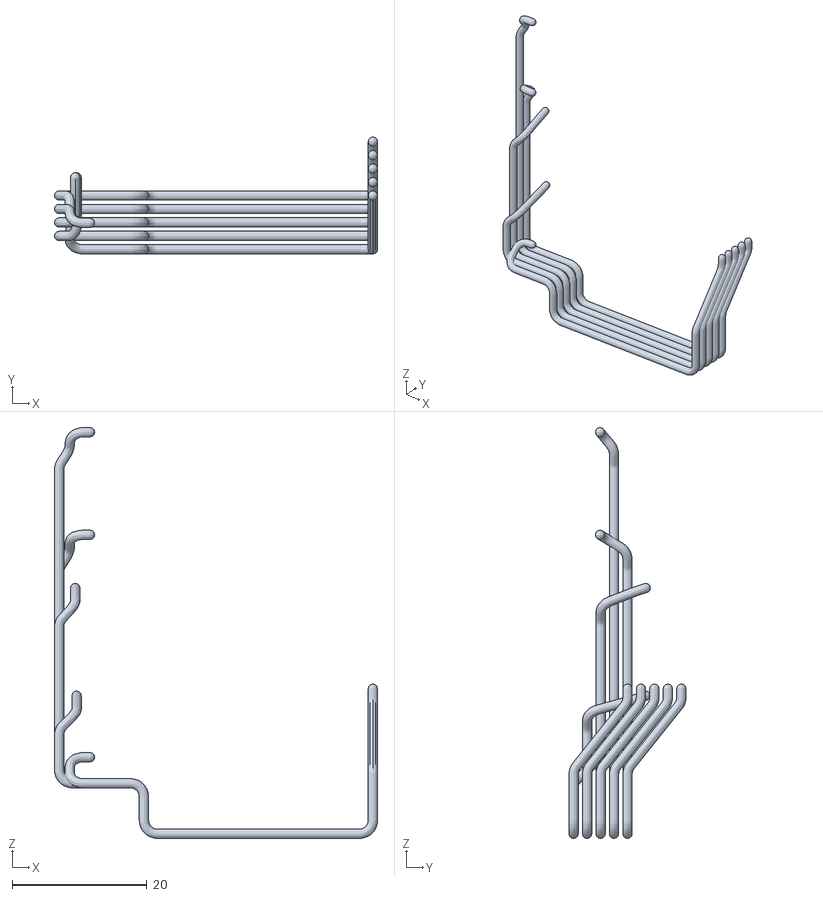
[picture p98: CAD file, 2026-10-17]
bittle_pi_addon/stl/models/wires_amp.stl
48.0 x 17.4 x 61.0
