LineChef/G2bittlex/bittle_pi_addon/stl/installed/pod_button.stl

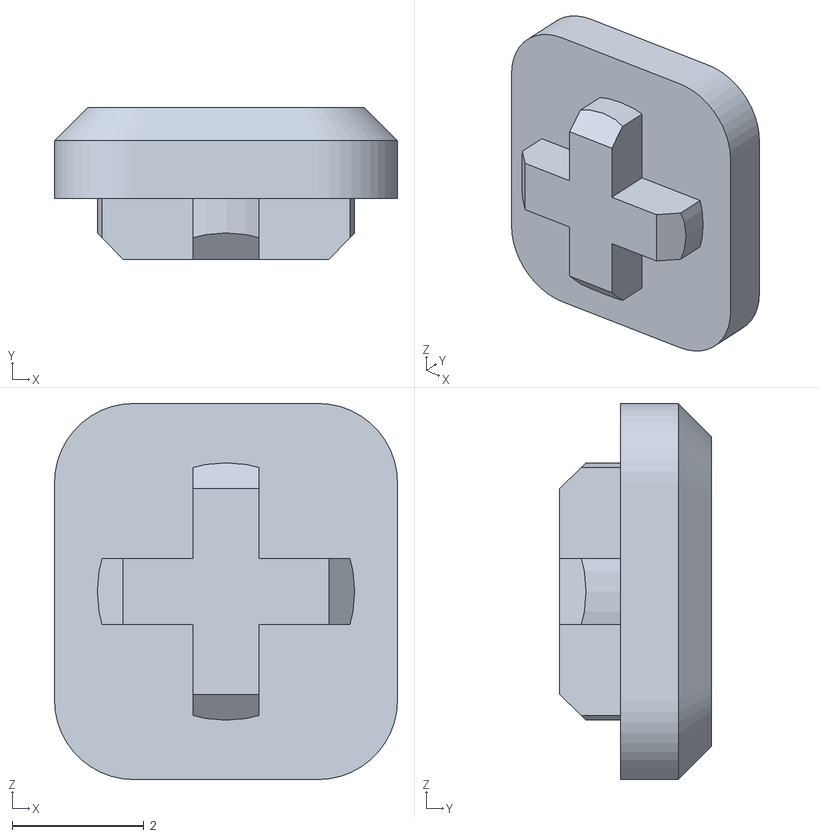
[picture p99: CAD file, 2026-10-16]
bittle_pi_addon/stl/installed/pod_button.stl
5.20 x 2.30 x 5.70
