LineChef/G2bittlex/bittle_pi_addon/stl/models/parts/pisugar_s__parts.stl

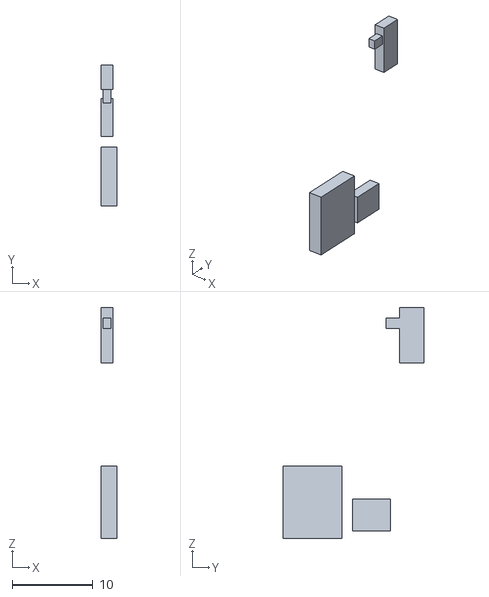
[picture p100: CAD file, 2026-10-18]
bittle_pi_addon/stl/models/parts/pisugar_s__parts.stl
2.00 x 17.4 x 28.6
