LineChef/G2bittlex/bittle_pi_addon/stl/models/wires_splice.stl

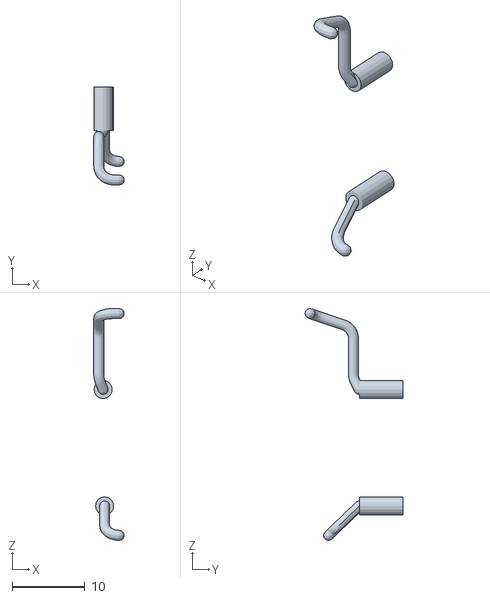
[picture p101: CAD file, 2026-10-17]
bittle_pi_addon/stl/models/wires_splice.stl
4.20 x 13.5 x 31.9
