LineChef/G2bittlex/bittle_pi_addon/stl/models/biboard_plug.stl

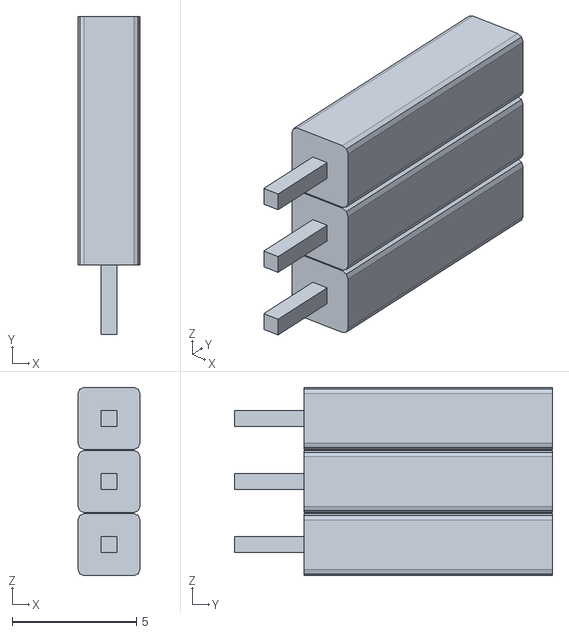
[picture p102: CAD file, 2026-10-17]
bittle_pi_addon/stl/models/biboard_plug.stl
2.50 x 12.8 x 7.58
