LineChef/G2bittlex/bittle_pi_addon/stl/models/parts/battery__lead1.stl

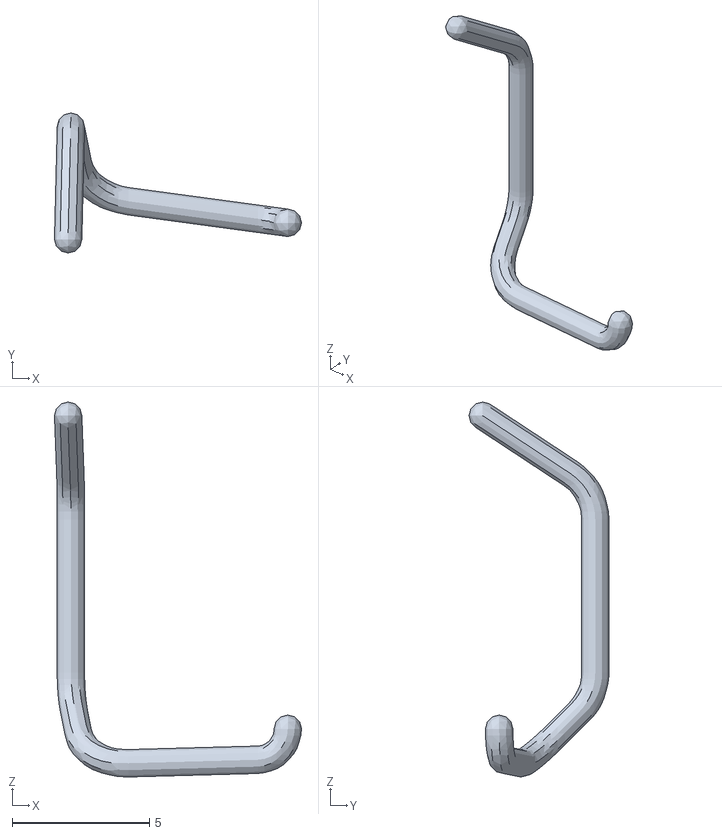
[picture p103: CAD file, 2026-10-18]
bittle_pi_addon/stl/models/parts/battery__lead1.stl
9.00 x 5.10 x 13.7
