LineChef/G2bittlex/bittle_platform/reference/petoi_ros/battery_1.stl

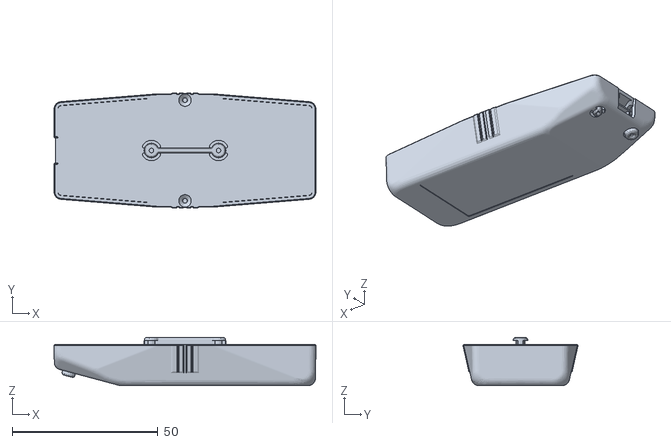
[picture p104: CAD file, 2026-10-14]
bittle_platform/reference/petoi_ros/battery_1.stl
89.8 x 39.5 x 16.5
