LineChef/G2bittlex/bittle_pi_addon/stl/models/parts/pisugar_s__disc.stl

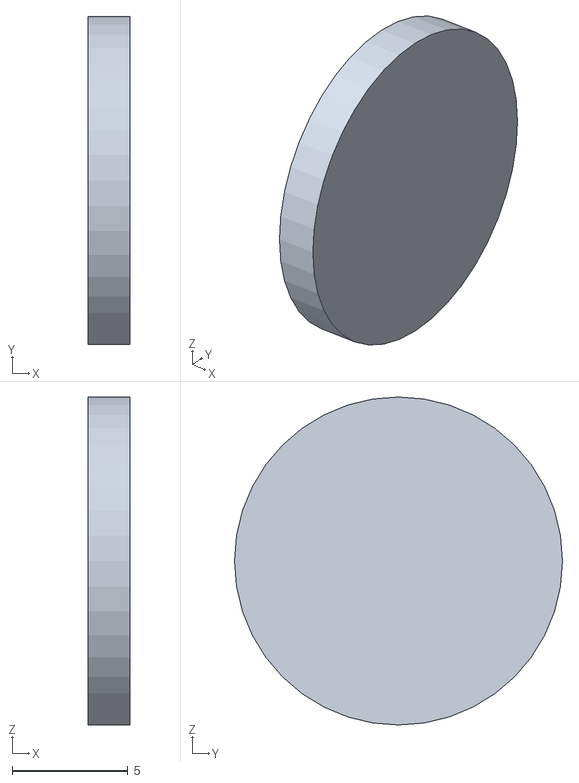
[picture p105: CAD file, 2026-10-18]
bittle_pi_addon/stl/models/parts/pisugar_s__disc.stl
1.81 x 14.2 x 14.2
