LineChef/G2bittlex/bittle_pi_addon/stl/models/wires_speaker.stl

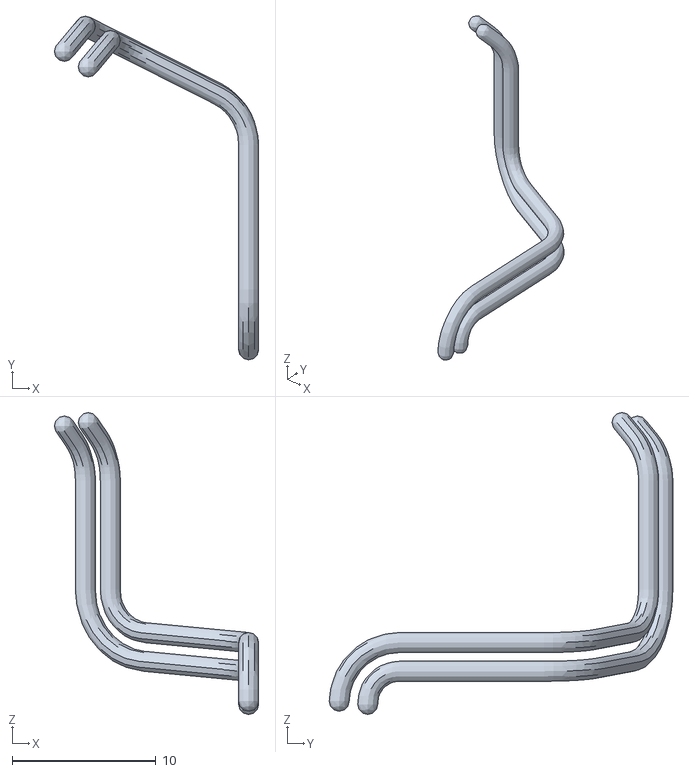
[picture p106: CAD file, 2026-10-17]
bittle_pi_addon/stl/models/wires_speaker.stl
14.2 x 23.9 x 21.0
