LineChef/G2bittlex/bittle_platform/stl/robot/neck_mount.stl

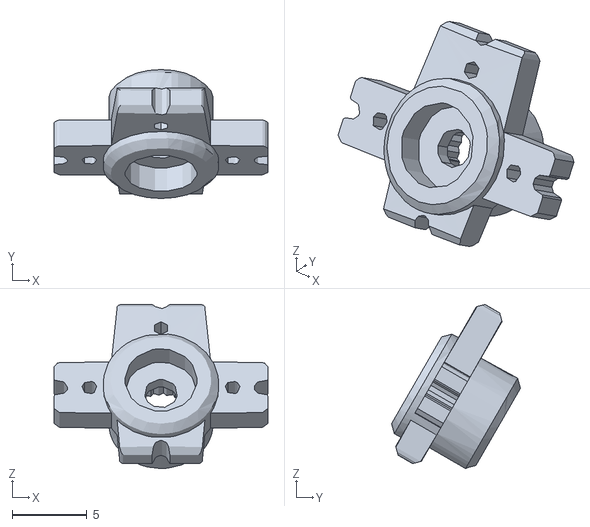
[picture p107: CAD file, 2026-10-14]
bittle_platform/stl/robot/neck_mount.stl
14.3 x 8.64 x 11.0
