LineChef/G2bittlex/bittle_pi_addon/stl/models/amp_ns4168.stl

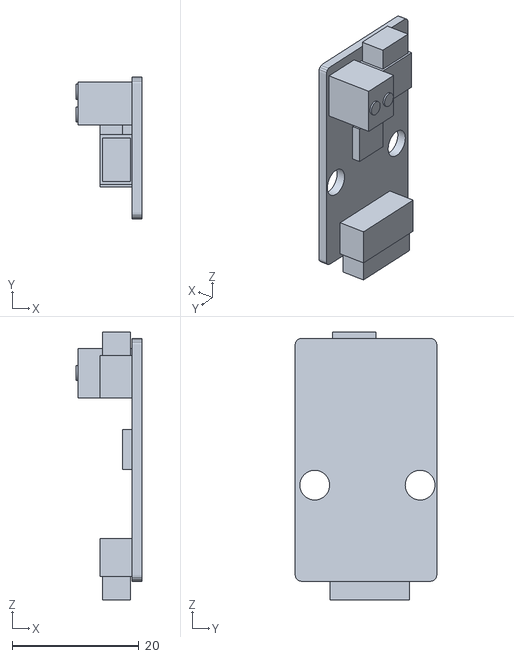
[picture p108: CAD file, 2026-10-17]
bittle_pi_addon/stl/models/amp_ns4168.stl
10.4 x 22.4 x 42.3
