LineChef/G2bittlex/bittle_pi_addon/stl/models/parts/battery__lead0.stl

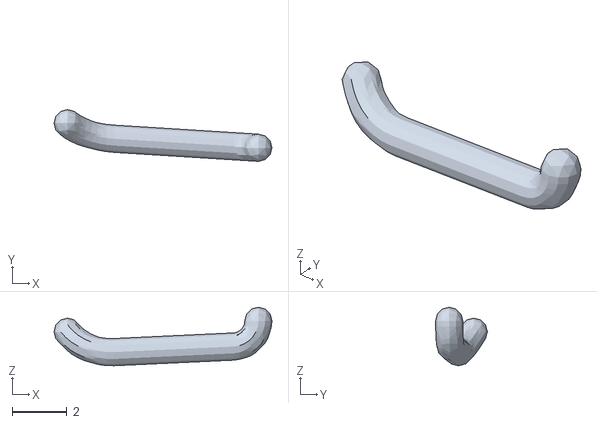
[picture p109: CAD file, 2026-10-18]
bittle_pi_addon/stl/models/parts/battery__lead0.stl
8.00 x 1.90 x 2.15
