LineChef/G2bittlex/bittle_pi_addon/stl/models/mic_sph0645.stl

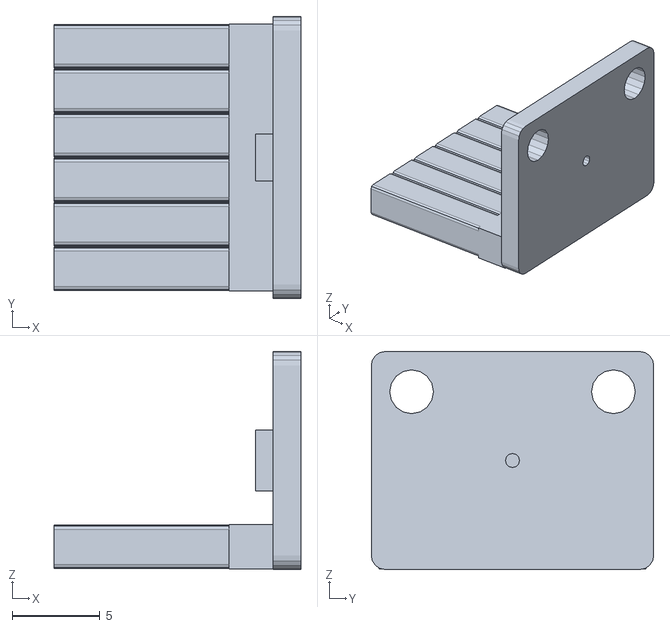
[picture p110: CAD file, 2026-10-16]
bittle_pi_addon/stl/models/mic_sph0645.stl
14.1 x 16.1 x 12.5
