LineChef/G2bittlex/bittle_pi_addon/stl/models/parts/pisugar_s__board.stl

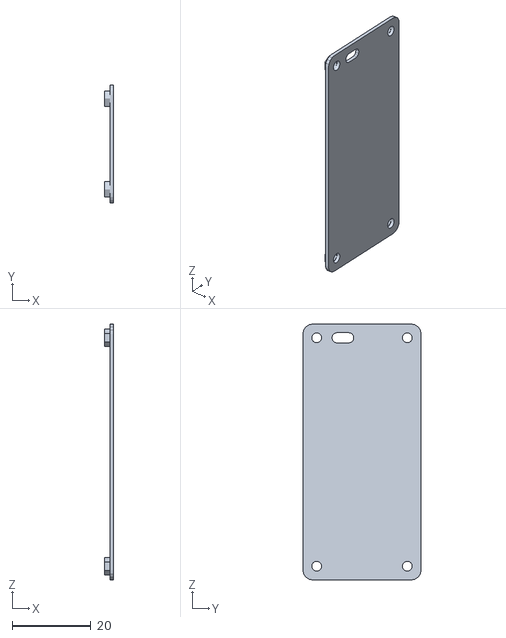
[picture p111: CAD file, 2026-10-18]
bittle_pi_addon/stl/models/parts/pisugar_s__board.stl
2.40 x 30.0 x 65.0
