LineChef/G2bittlex/bittle_pi_addon/stl/models/wires_uart.stl

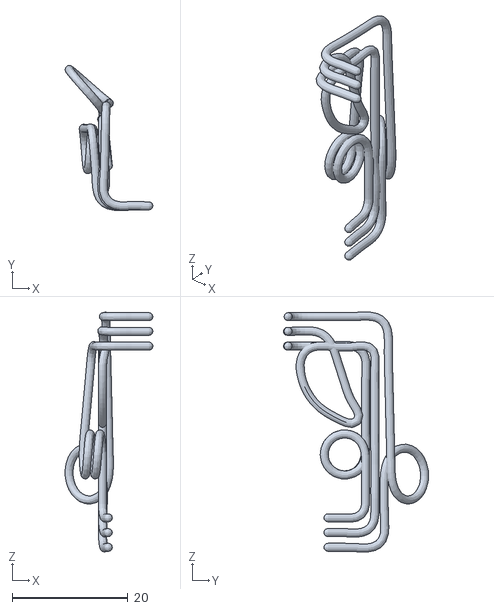
[picture p112: CAD file, 2026-10-16]
bittle_pi_addon/stl/models/wires_uart.stl
15.2 x 25.1 x 41.4
