LineChef/G2bittlex/bittle_platform/reference/petoi_ros/servo_neck__1.stl

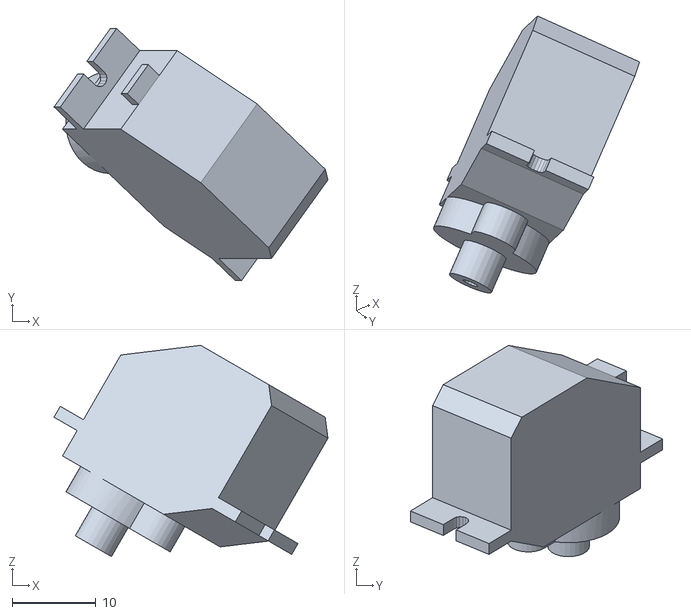
[picture p113: CAD file, 2026-10-14]
bittle_platform/reference/petoi_ros/servo_neck__1.stl
32.7 x 30.1 x 25.2
