LineChef/G2bittlex/bittle_pi_addon/stl/models/parts/wires_camera__usb.stl

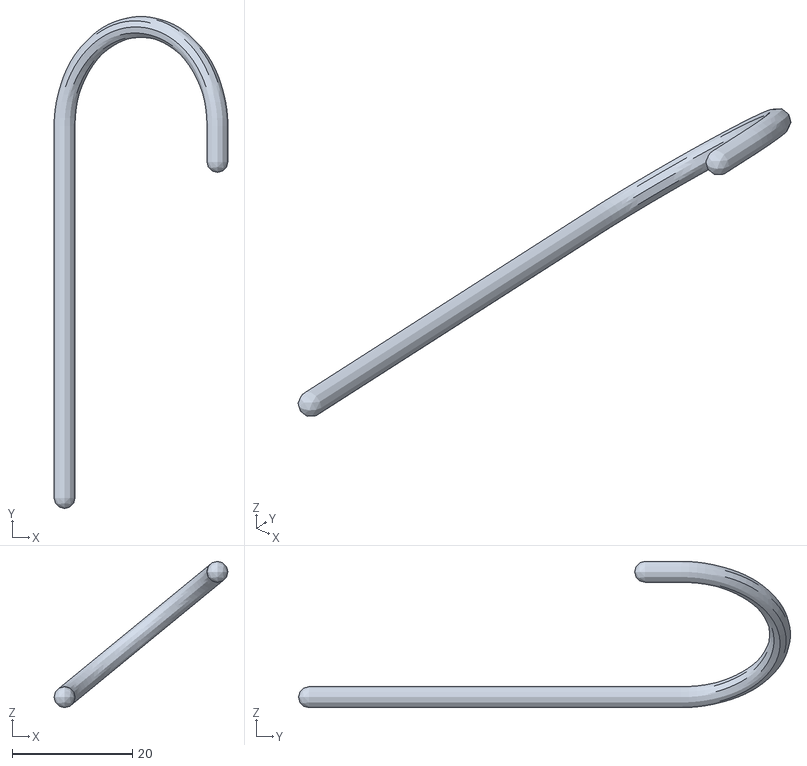
[picture p114: CAD file, 2026-10-17]
bittle_pi_addon/stl/models/parts/wires_camera__usb.stl
28.9 x 81.8 x 24.4
