LineChef/G2bittlex/bittle_pi_addon/stl/models/speaker.stl

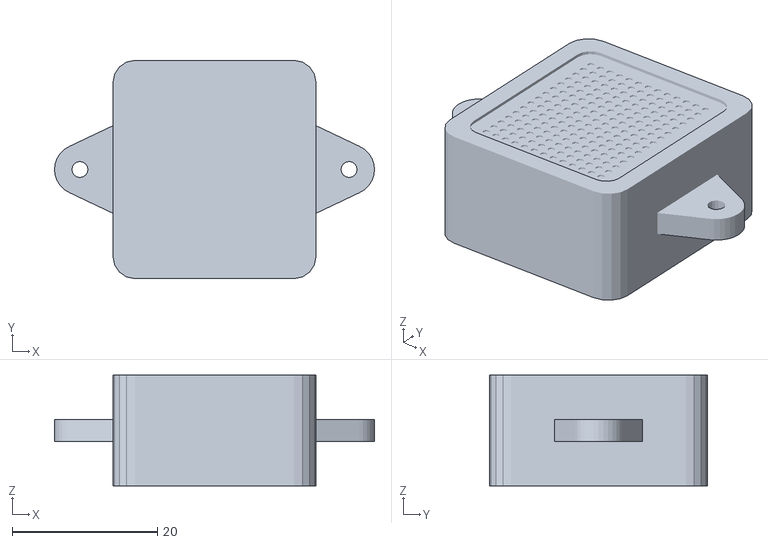
[picture p115: CAD file, 2026-10-16]
bittle_pi_addon/stl/models/speaker.stl
44.0 x 30.0 x 15.2
