LineChef/G2bittlex/bittle_platform/reference/petoi_ros/tho_lf_1.stl

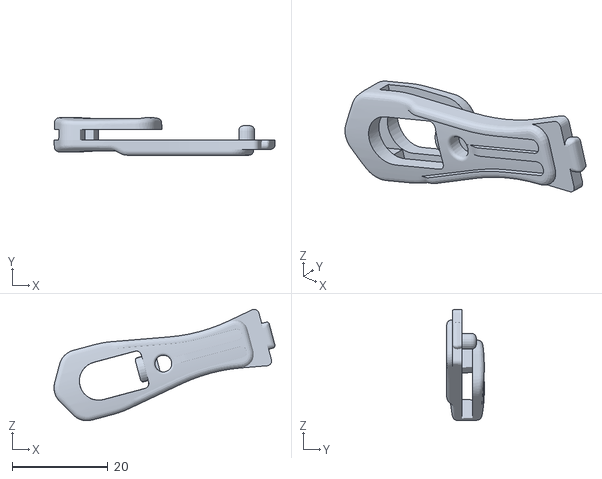
[picture p116: CAD file, 2026-10-14]
bittle_platform/reference/petoi_ros/tho_lf_1.stl
46.1 x 7.85 x 23.3
