LineChef/G2bittlex/bittle_pi_addon/stl/models/parts/wires_camera__plug_cam.stl

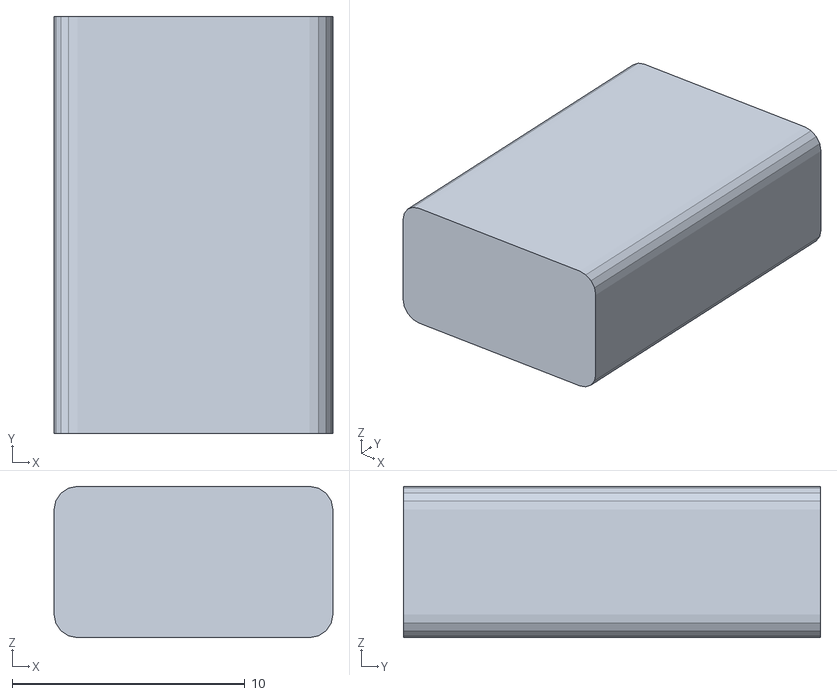
[picture p117: CAD file, 2026-10-17]
bittle_pi_addon/stl/models/parts/wires_camera__plug_cam.stl
12.0 x 17.9 x 6.50
