LineChef/G2bittlex/bittle_pi_addon/stl/models/parts/wires_amp__v.stl

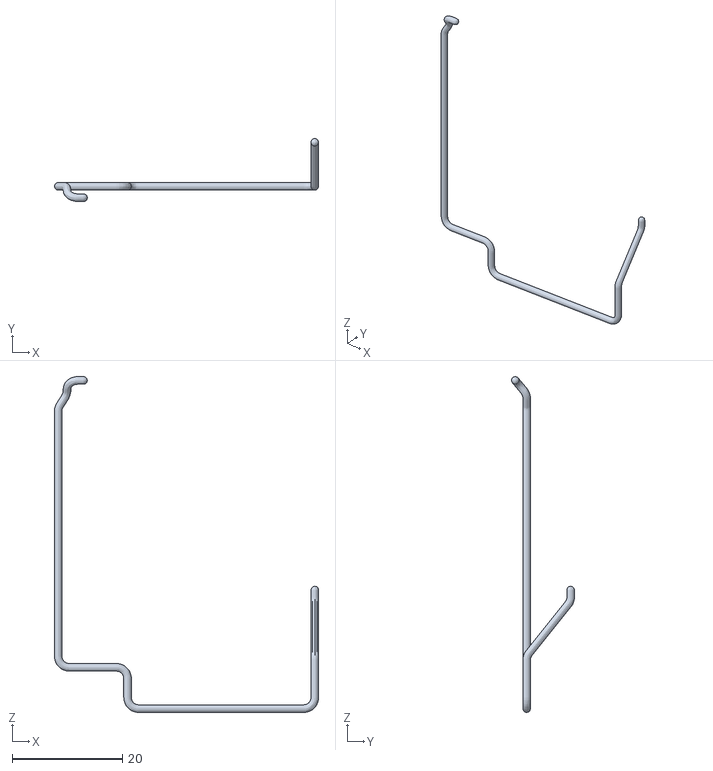
[picture p118: CAD file, 2026-10-17]
bittle_pi_addon/stl/models/parts/wires_amp__v.stl
48.0 x 11.5 x 61.0
