LineChef/G2bittlex/bittle_pi_addon/stl/models/wires_camera_low.stl

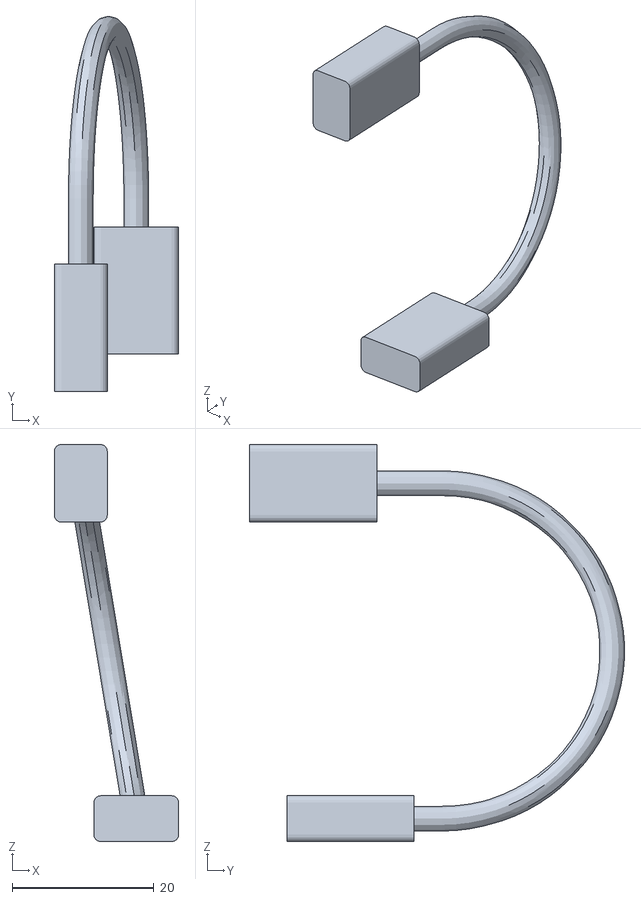
[picture p119: CAD file, 2026-10-16]
bittle_pi_addon/stl/models/wires_camera_low.stl
17.6 x 53.0 x 56.1
