LineChef/G2bittlex/bittle_pi_addon/stl/models/parts/wires_amp__din.stl

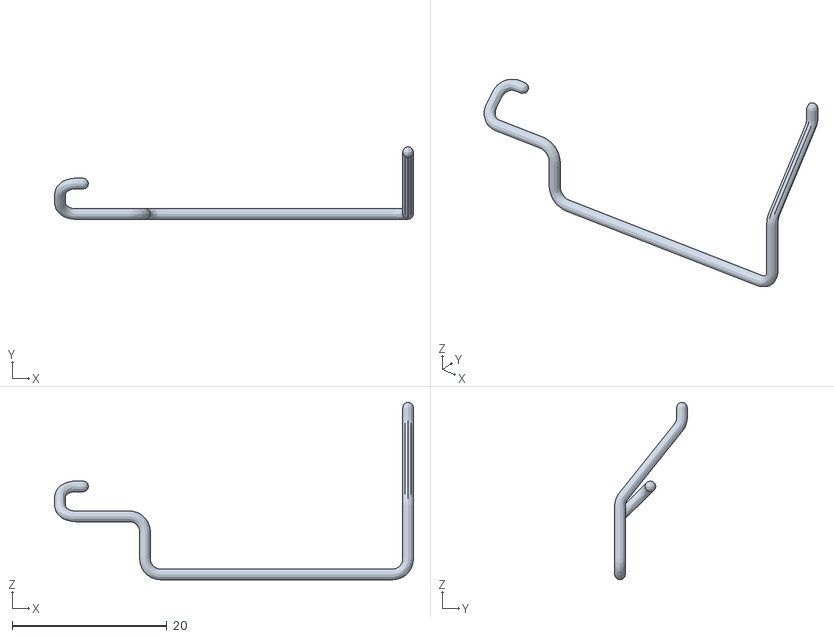
[picture p120: CAD file, 2026-10-17]
bittle_pi_addon/stl/models/parts/wires_amp__din.stl
46.4 x 9.40 x 23.0
