LineChef/G2bittlex/bittle_pi_addon/stl/models/parts/wires_amp__g.stl

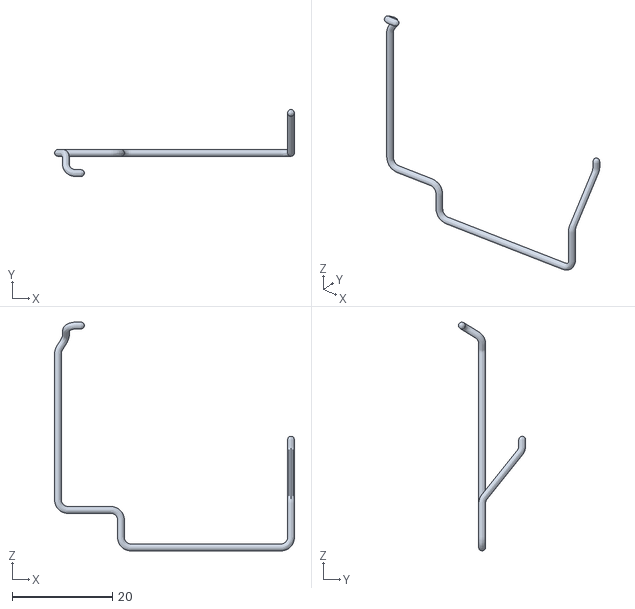
[picture p121: CAD file, 2026-10-17]
bittle_pi_addon/stl/models/parts/wires_amp__g.stl
48.0 x 13.5 x 45.8
