LineChef/G2bittlex/bittle_pi_addon/stl/models/sd_card.stl

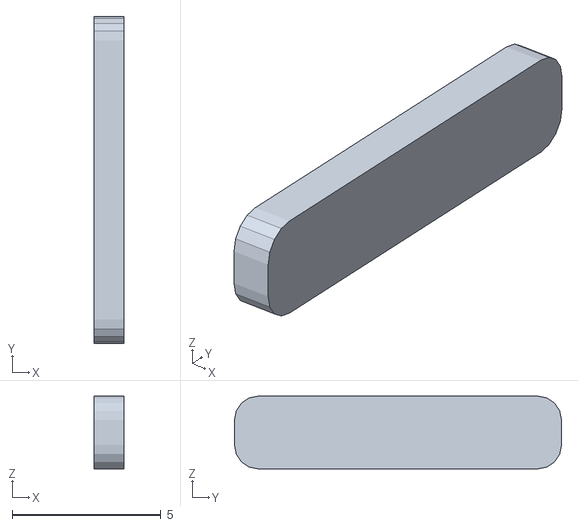
[picture p122: CAD file, 2026-10-16]
bittle_pi_addon/stl/models/sd_card.stl
1.00 x 11.0 x 2.45
