LineChef/G2bittlex/bittle_pi_addon/stl/models/camera_low_pins.stl

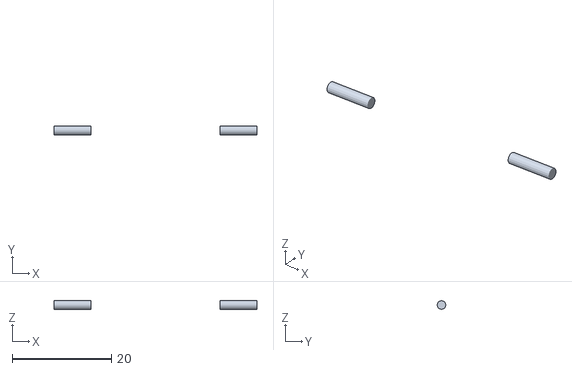
[picture p123: CAD file, 2026-10-16]
bittle_pi_addon/stl/models/camera_low_pins.stl
41.0 x 1.75 x 1.75
