LineChef/G2bittlex/bittle_pi_addon/stl/models/parts/wires_mic__gnd.stl

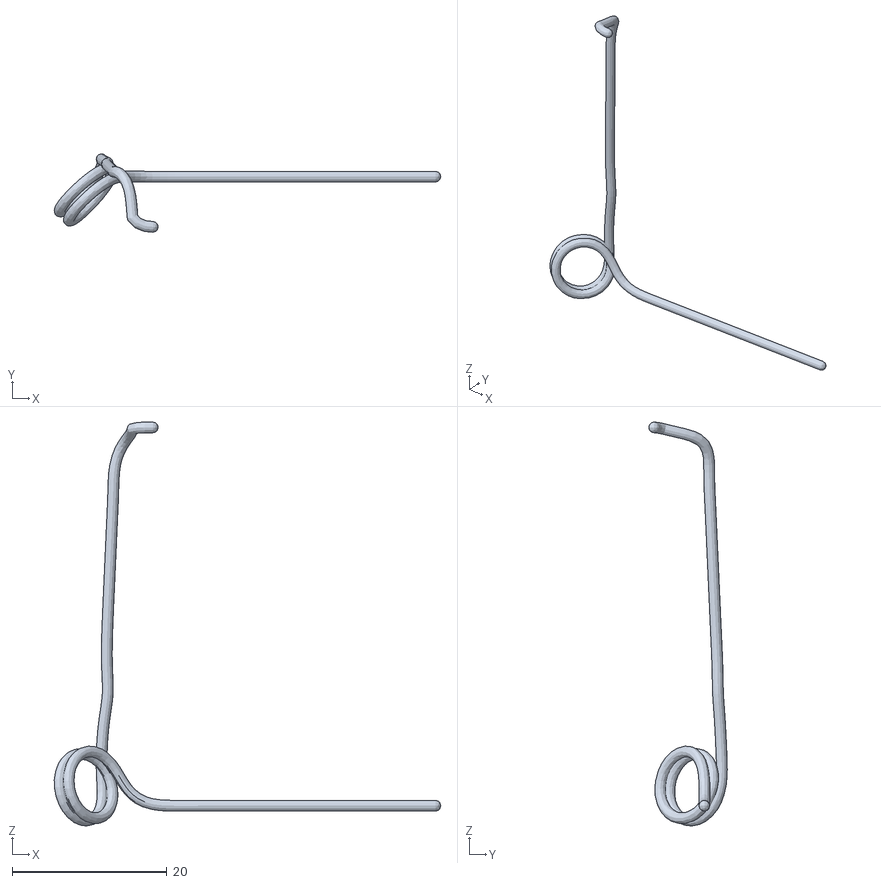
[picture p124: CAD file, 2026-10-17]
bittle_pi_addon/stl/models/parts/wires_mic__gnd.stl
49.9 x 10.1 x 52.2
