LineChef/G2bittlex/bittle_pi_addon/stl/models/biboard_header.stl

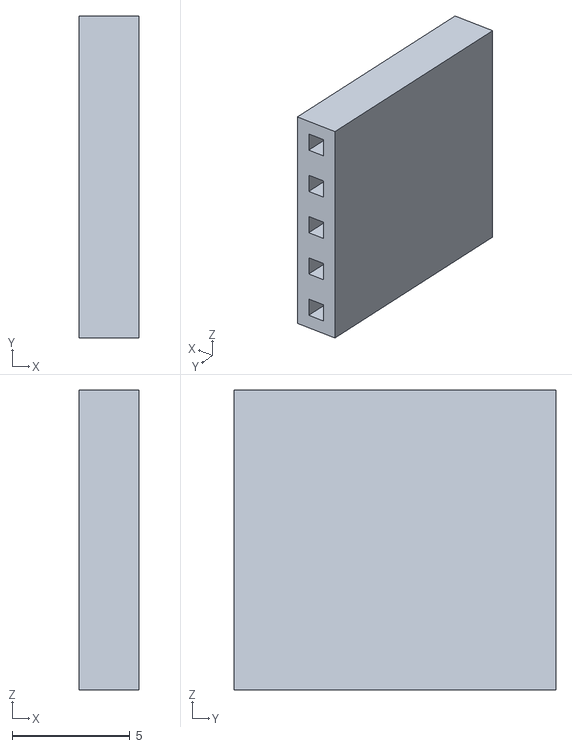
[picture p126: CAD file, 2026-10-16]
bittle_pi_addon/stl/models/biboard_header.stl
2.54 x 13.6 x 12.7
