LineChef/G2bittlex/bittle_pi_addon/stl/models/parts/wires_amp__lrc.stl

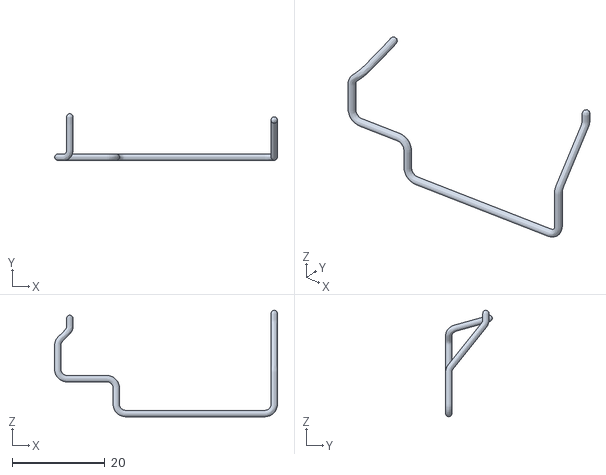
[picture p127: CAD file, 2026-10-17]
bittle_pi_addon/stl/models/parts/wires_amp__lrc.stl
48.0 x 10.1 x 23.0
