LineChef/G2bittlex/bittle_pi_addon/stl/models/parts/wires_amp__bclk.stl

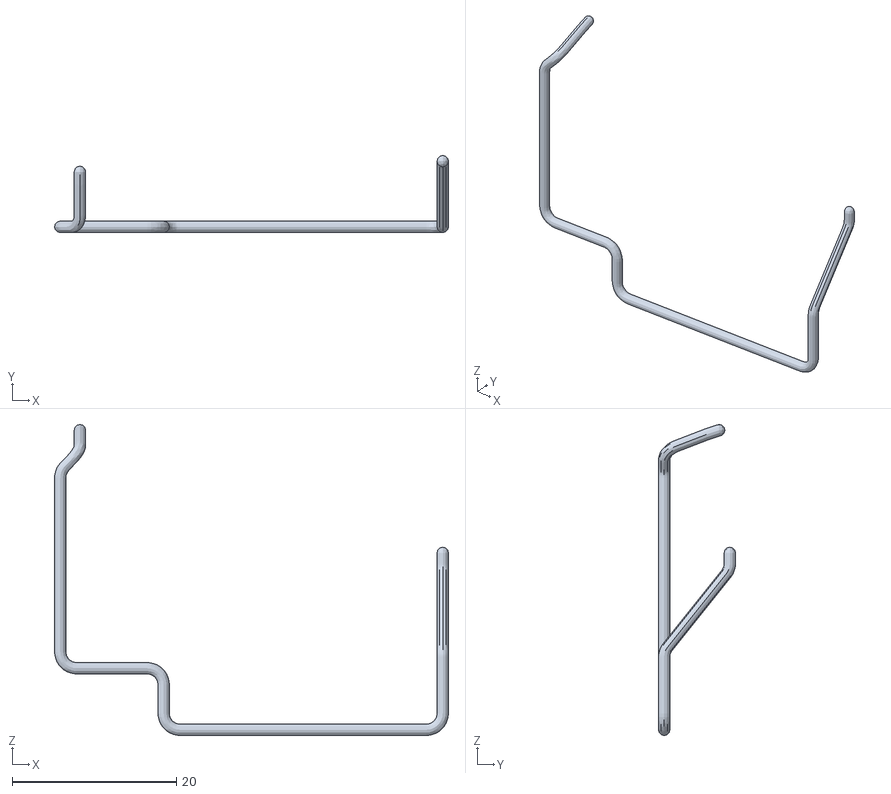
[picture p128: CAD file, 2026-10-17]
bittle_pi_addon/stl/models/parts/wires_amp__bclk.stl
48.0 x 9.40 x 37.9
