LineChef/G2bittlex/bittle_pi_addon/stl/models/pizero.stl

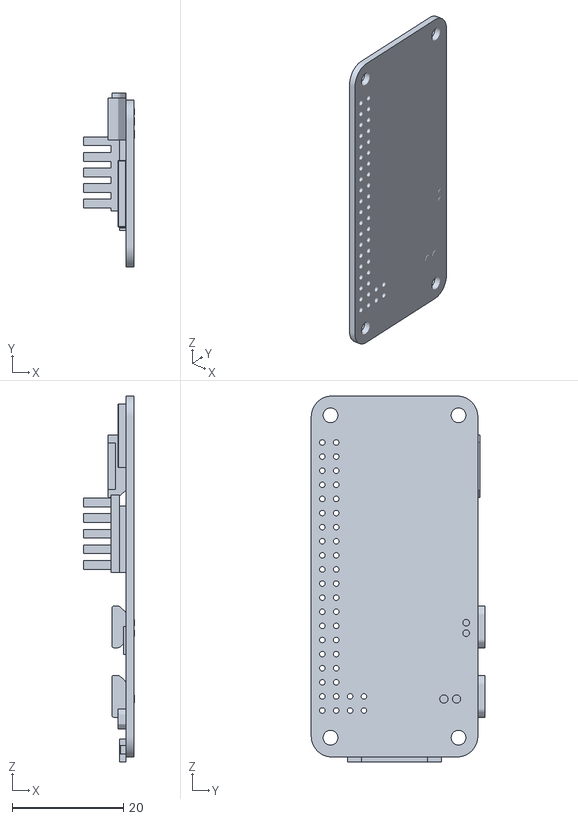
[picture p129: CAD file, 2026-10-16]
bittle_pi_addon/stl/models/pizero.stl
9.20 x 31.2 x 65.9
