LineChef/G2bittlex/bittle_pi_addon/stl/models/parts/wires_mic__3v.stl

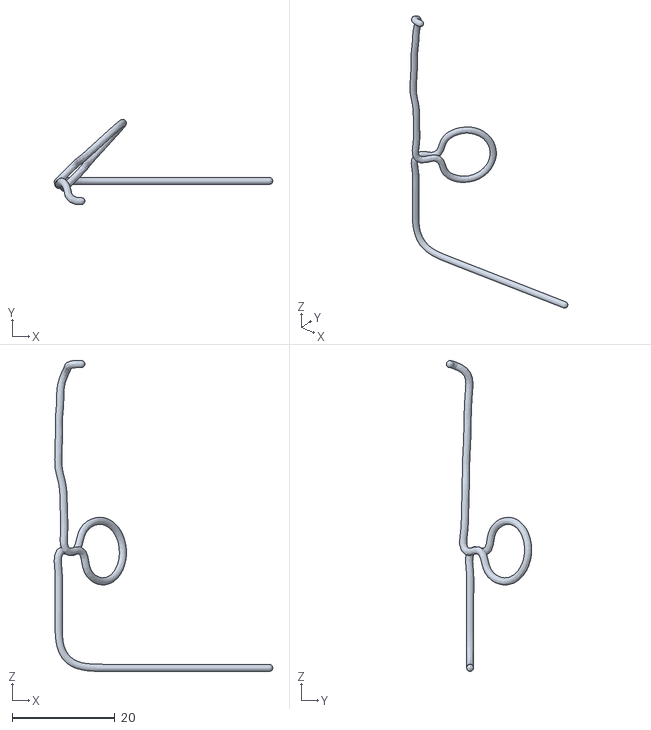
[picture p130: CAD file, 2026-10-17]
bittle_pi_addon/stl/models/parts/wires_mic__3v.stl
42.5 x 16.6 x 60.4
