LineChef/G2bittlex/bittle_pi_addon/stl/models/pi_plugs.stl

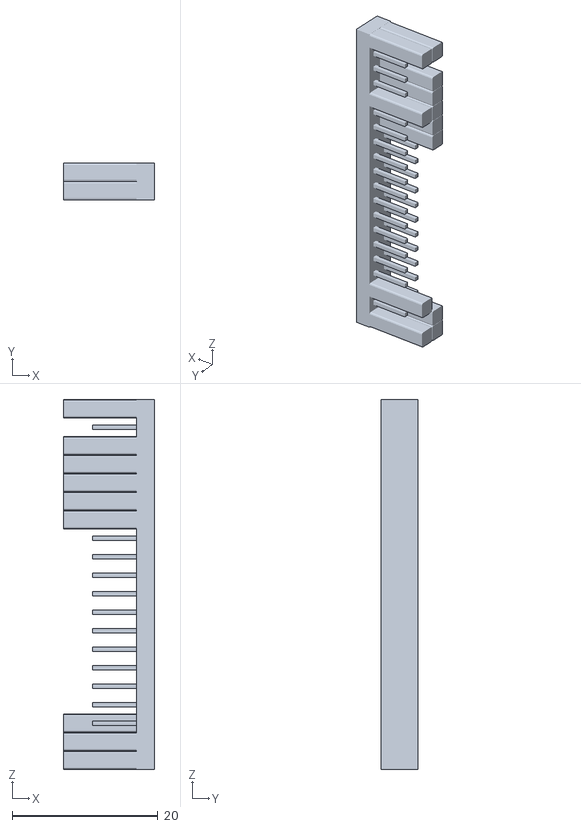
[picture p131: CAD file, 2026-10-16]
bittle_pi_addon/stl/models/pi_plugs.stl
12.5 x 5.08 x 50.8
