LineChef/G2bittlex/bittle_pi_addon/stl/models/parts/wires_uart__tx2_dev.stl

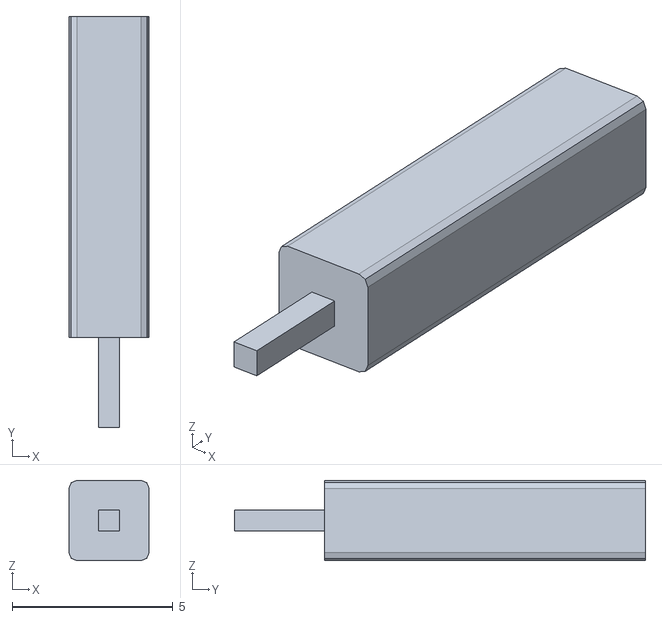
[picture p132: CAD file, 2026-10-17]
bittle_pi_addon/stl/models/parts/wires_uart__tx2_dev.stl
2.50 x 12.8 x 2.50
