LineChef/G2bittlex/bittle_pi_addon/stl/models/parts/wires_splice__bclk.stl

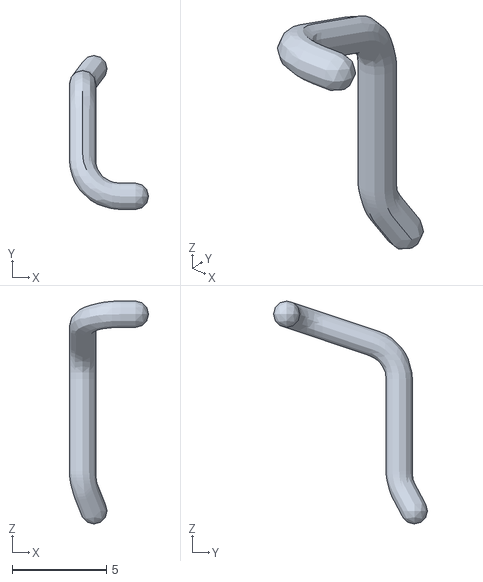
[picture p133: CAD file, 2026-10-17]
bittle_pi_addon/stl/models/parts/wires_splice__bclk.stl
4.20 x 8.17 x 11.8
