LineChef/G2bittlex/bittle_pi_addon/stl/models/parts/amp_ns4168__headers.stl

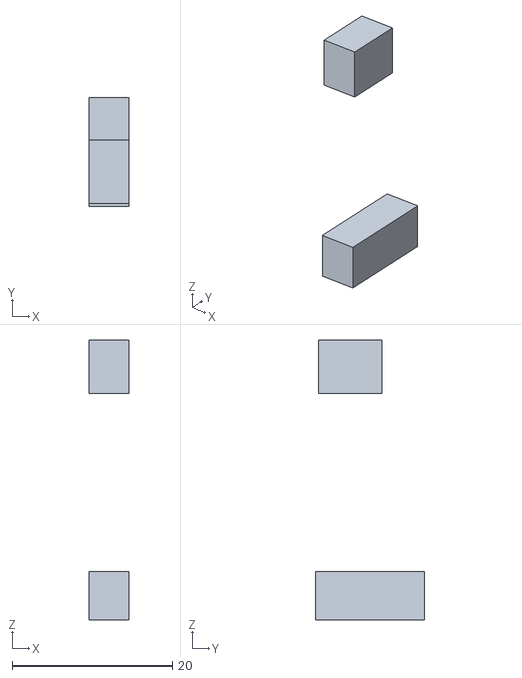
[picture p134: CAD file, 2026-10-17]
bittle_pi_addon/stl/models/parts/amp_ns4168__headers.stl
5.00 x 13.6 x 35.0
