LineChef/G2bittlex/bittle_pi_addon/stl/models/parts/wires_mic__lrcl.stl

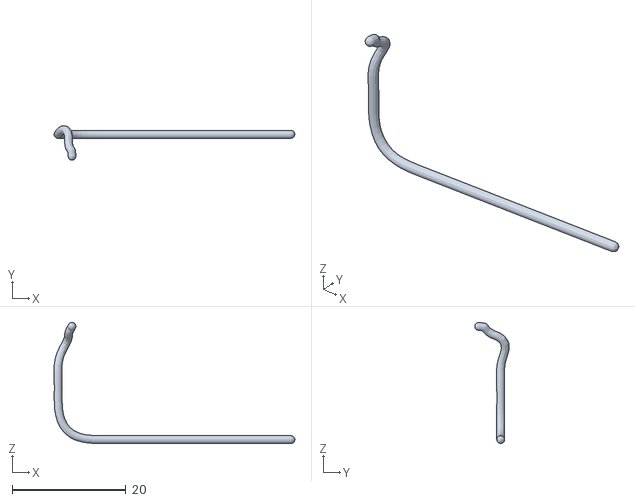
[picture p135: CAD file, 2026-10-17]
bittle_pi_addon/stl/models/parts/wires_mic__lrcl.stl
42.4 x 6.07 x 21.3
