LineChef/G2bittlex/bittle_platform/reference/petoi_ros/c_tholf_1.stl

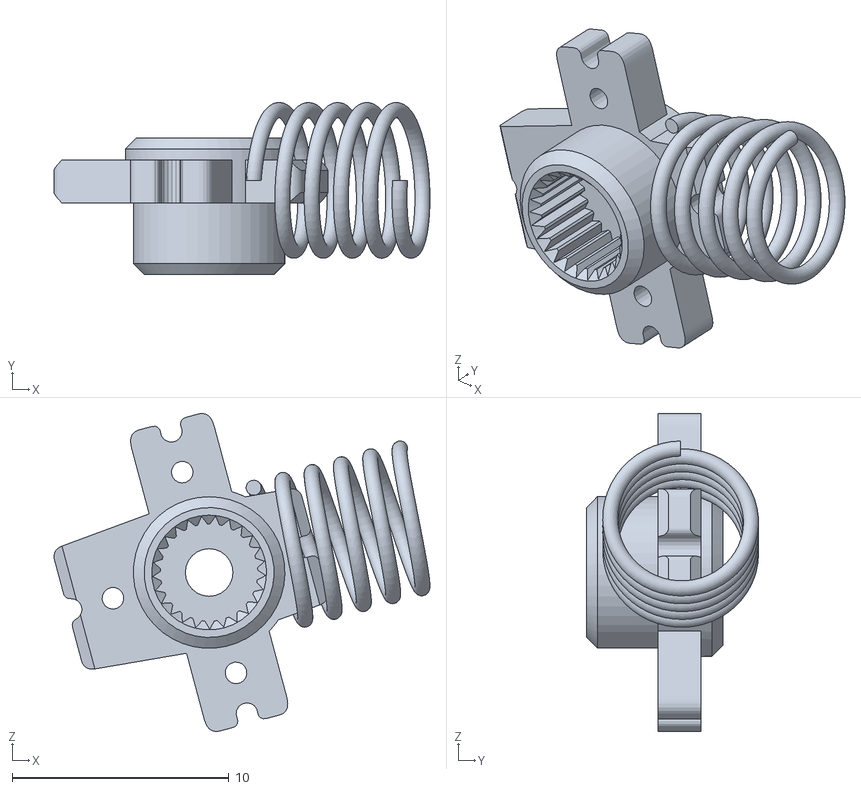
[picture p136: CAD file, 2026-10-14]
bittle_platform/reference/petoi_ros/c_tholf_1.stl
17.4 x 7.95 x 14.7
