LineChef/G2bittlex/bittle_pi_addon/stl/models/parts/amp_ns4168__terminal.stl

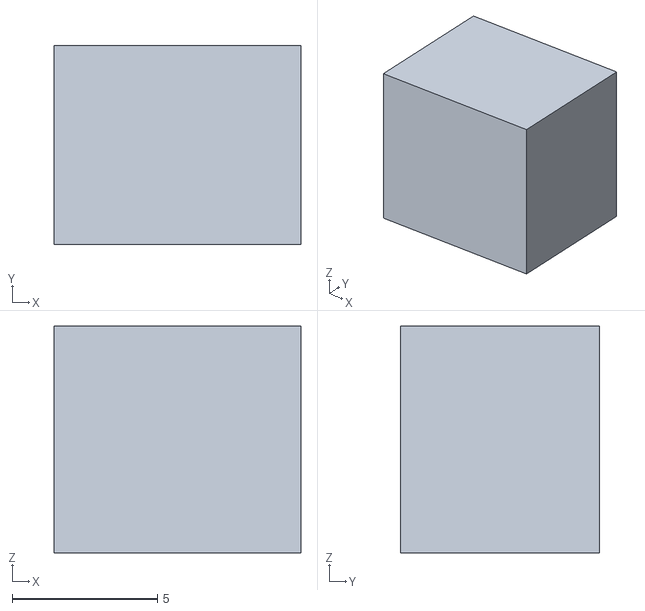
[picture p137: CAD file, 2026-10-17]
bittle_pi_addon/stl/models/parts/amp_ns4168__terminal.stl
8.50 x 6.85 x 7.80
