LineChef/G2bittlex/bittle_pi_addon/stl/models/parts/amp_ns4168__pcb.stl

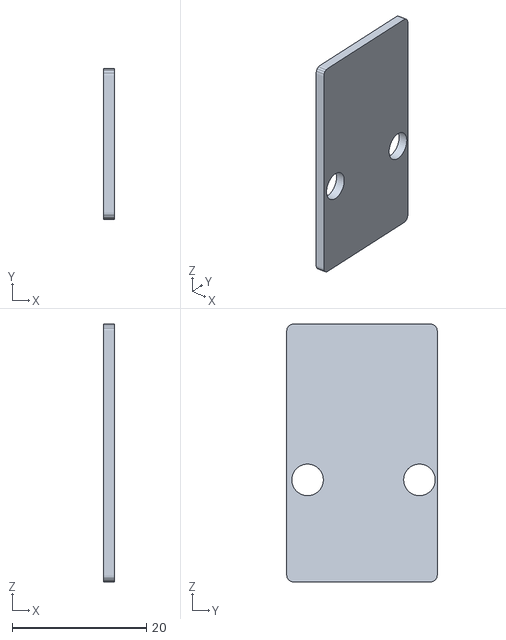
[picture p138: CAD file, 2026-10-17]
bittle_pi_addon/stl/models/parts/amp_ns4168__pcb.stl
1.60 x 22.4 x 38.4
