LineChef/G2bittlex/bittle_pi_addon/stl/models/parts/wires_speaker__neg.stl

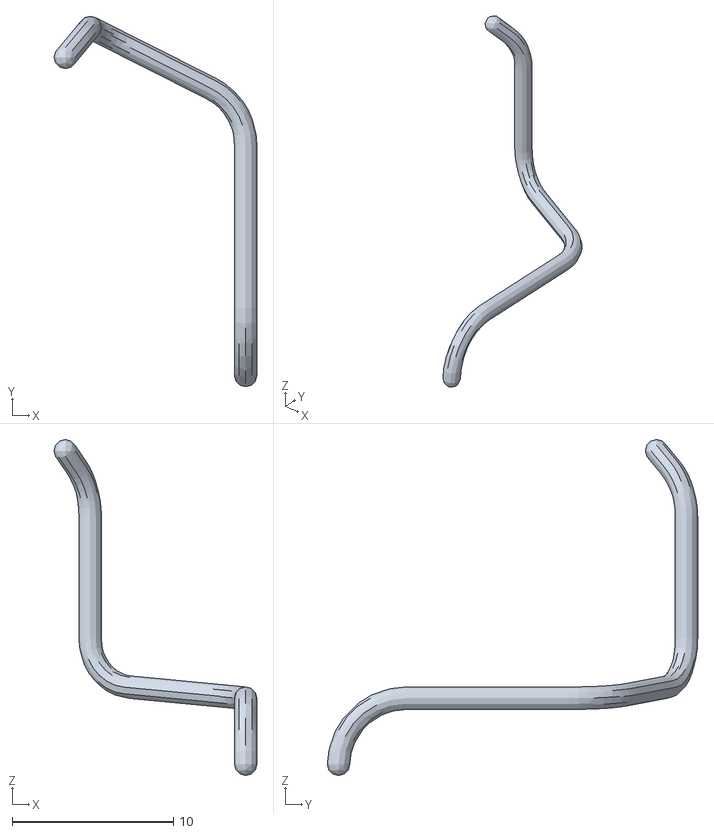
[picture p139: CAD file, 2026-10-17]
bittle_pi_addon/stl/models/parts/wires_speaker__neg.stl
12.6 x 22.9 x 20.8
