LineChef/G2bittlex/bittle_pi_addon/stl/models/parts/wires_speaker__pos.stl

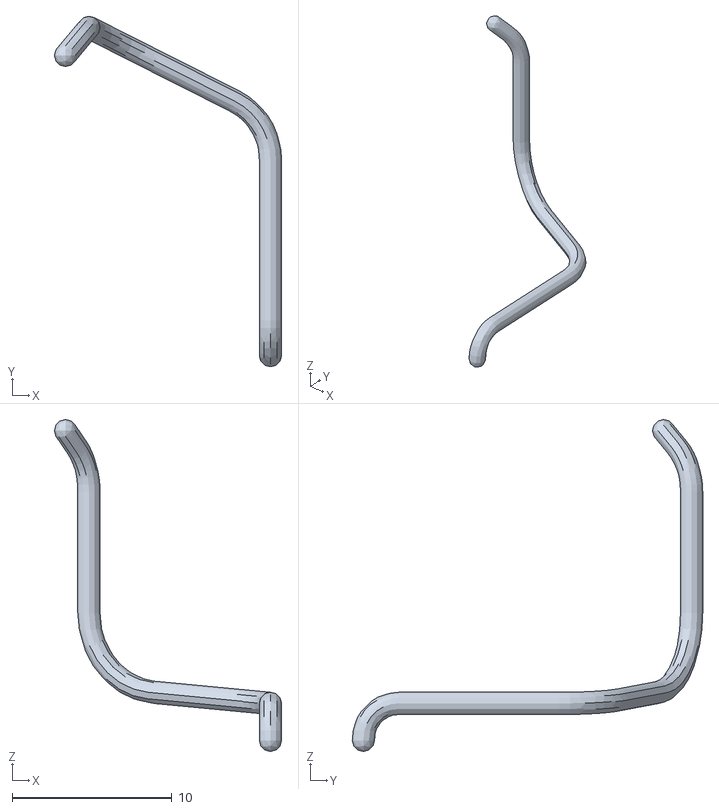
[picture p140: CAD file, 2026-10-17]
bittle_pi_addon/stl/models/parts/wires_speaker__pos.stl
14.2 x 22.0 x 20.8
