LineChef/G2bittlex/bittle_pi_addon/stl/models/parts/amp_ns4168__plugs.stl

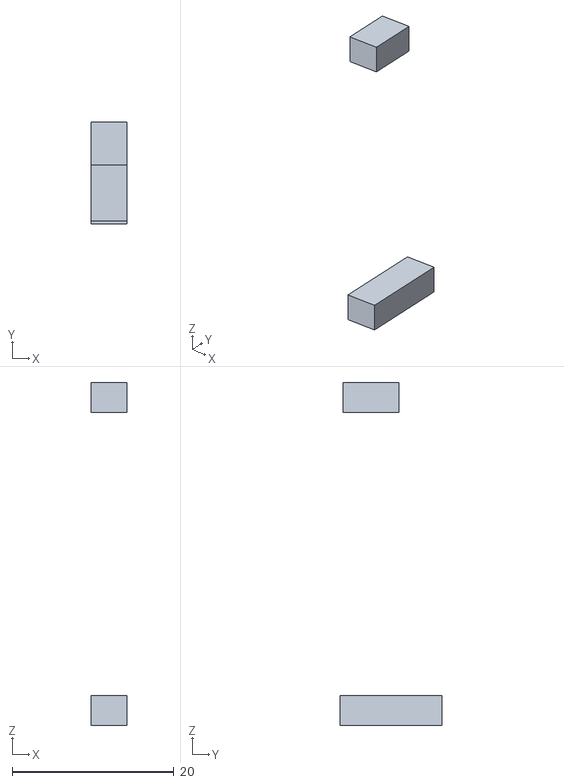
[picture p141: CAD file, 2026-10-17]
bittle_pi_addon/stl/models/parts/amp_ns4168__plugs.stl
4.40 x 12.6 x 42.3
