LineChef/G2bittlex/bittle_platform/reference/petoi_ros/jaw_1.stl

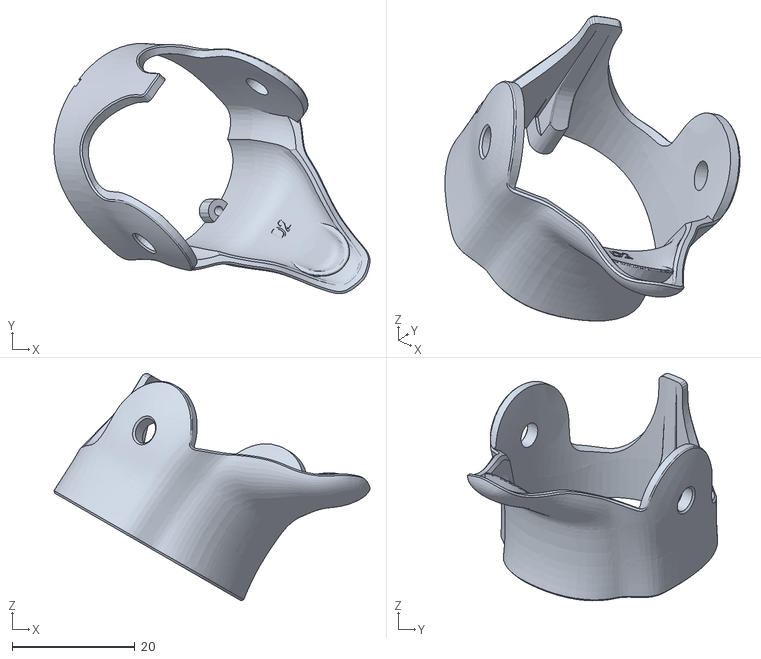
[picture p142: CAD file, 2026-10-14]
bittle_platform/reference/petoi_ros/jaw_1.stl
51.5 x 40.8 x 37.1
