LineChef/G2bittlex/bittle_pi_addon/stl/models/parts/wires_mic__dout.stl

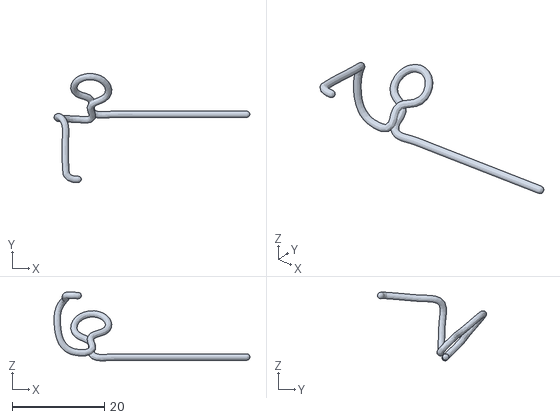
[picture p143: CAD file, 2026-10-17]
bittle_pi_addon/stl/models/parts/wires_mic__dout.stl
42.4 x 23.6 x 14.9
