LineChef/G2bittlex/bittle_pi_addon/stl/models/parts/amp_ns4168__ic.stl

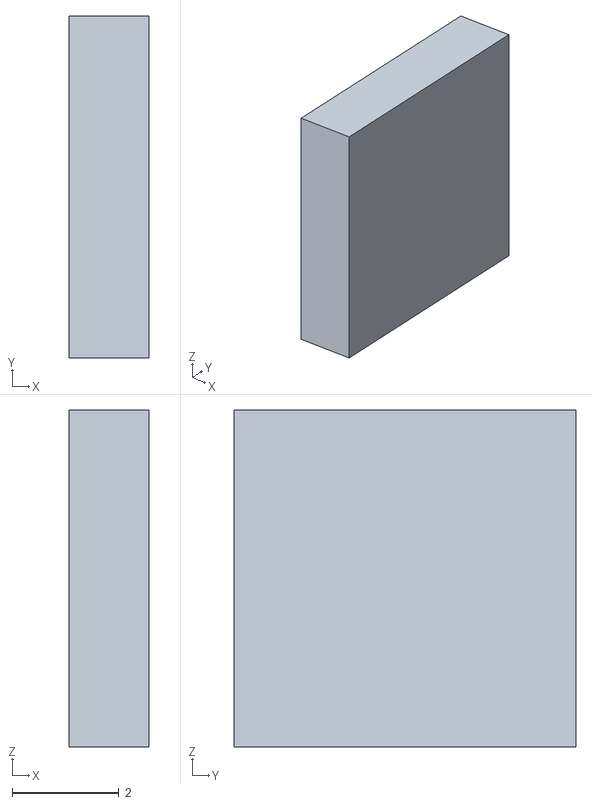
[picture p144: CAD file, 2026-10-17]
bittle_pi_addon/stl/models/parts/amp_ns4168__ic.stl
1.50 x 6.40 x 6.30
