LineChef/G2bittlex/bittle_pi_addon/stl/models/parts/amp_ns4168__rings.stl

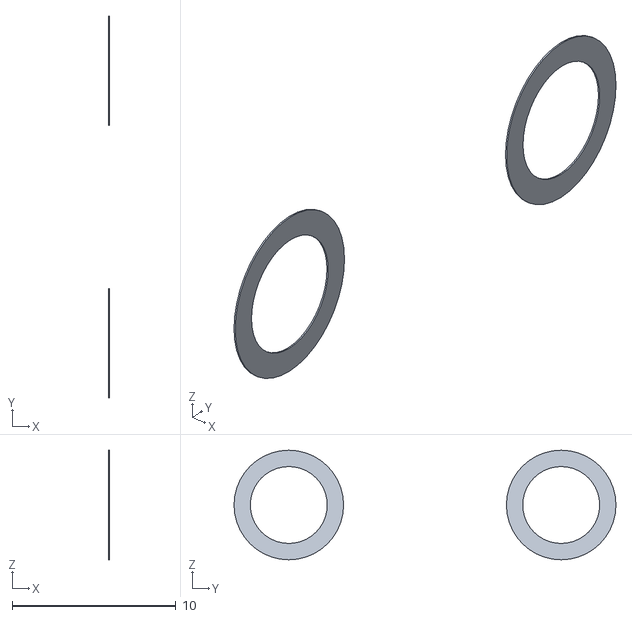
[picture p145: CAD file, 2026-10-17]
bittle_pi_addon/stl/models/parts/amp_ns4168__rings.stl
0.06 x 23.3 x 6.70
