LineChef/G2bittlex/bittle_pi_addon/stl/models/parts/wires_mic__bclk.stl

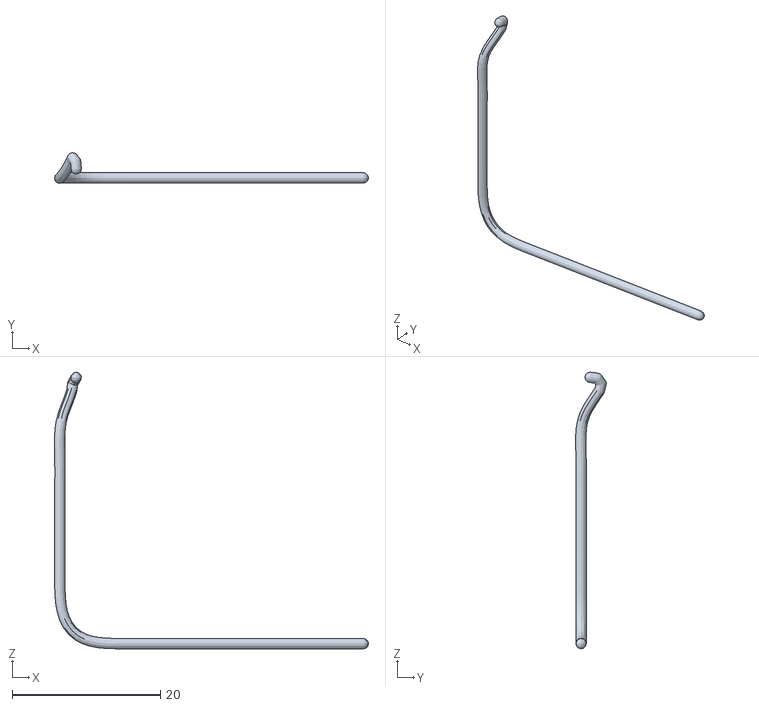
[picture p146: CAD file, 2026-10-17]
bittle_pi_addon/stl/models/parts/wires_mic__bclk.stl
42.3 x 4.15 x 37.3
