LineChef/G2bittlex/bittle_platform/reference/petoi_ros/c_neck__1.stl

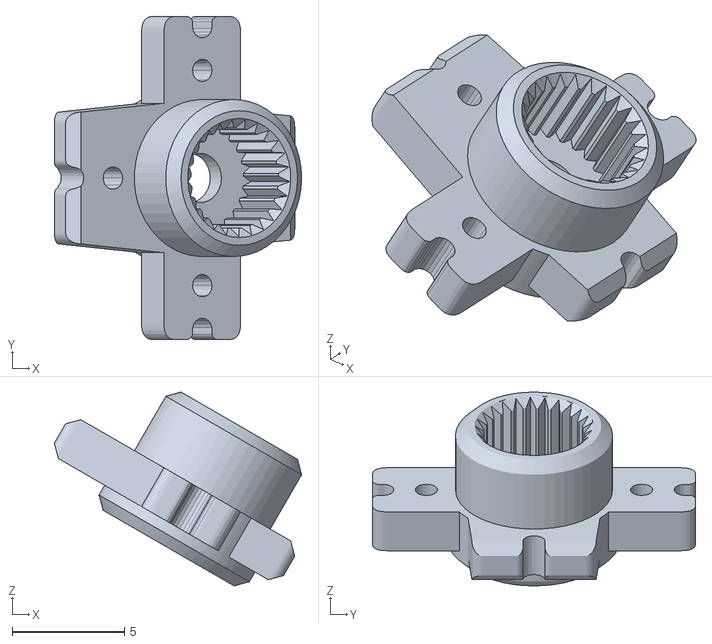
[picture p147: CAD file, 2026-10-14]
bittle_platform/reference/petoi_ros/c_neck__1.stl
11.0 x 14.4 x 8.64
