LineChef/G2bittlex/bittle_pi_addon/stl/models/parts/wires_mic__sel.stl

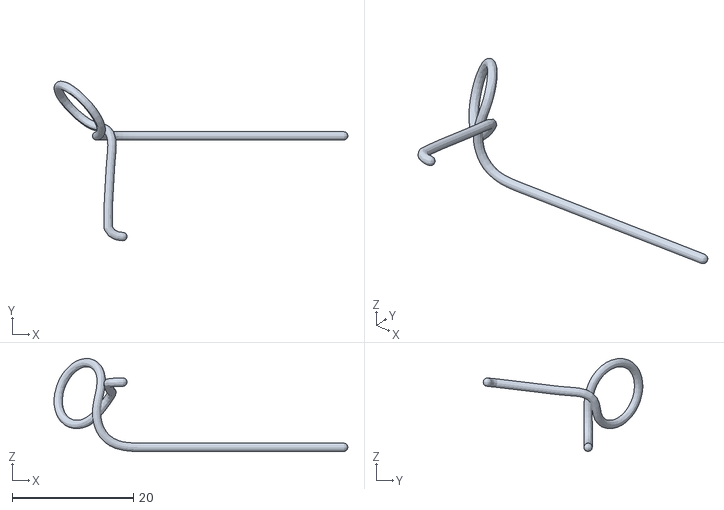
[picture p148: CAD file, 2026-10-17]
bittle_pi_addon/stl/models/parts/wires_mic__sel.stl
48.6 x 26.4 x 15.4
