LineChef/G2bittlex/bittle_pi_addon/stl/models/parts/wires_mic__3v_dev.stl

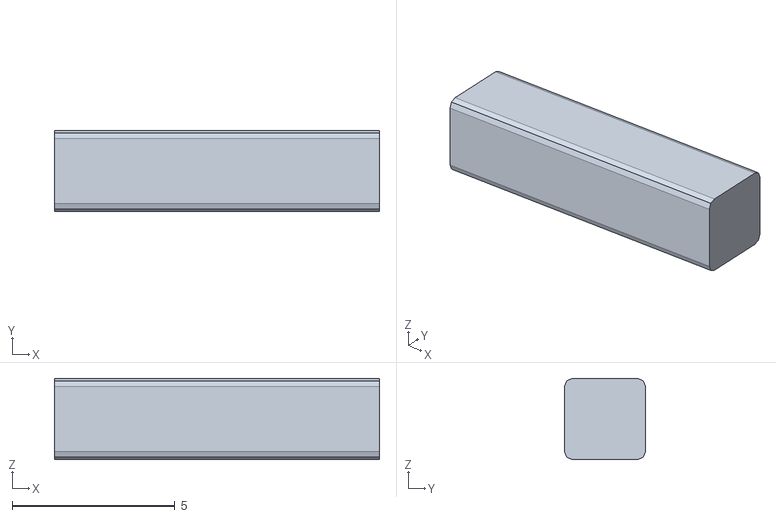
[picture p149: CAD file, 2026-10-16]
bittle_pi_addon/stl/models/parts/wires_mic__3v_dev.stl
10.0 x 2.50 x 2.50
