LineChef/G2bittlex/bittle_pi_addon/stl/models/parts/mic_sph0645__mic.stl

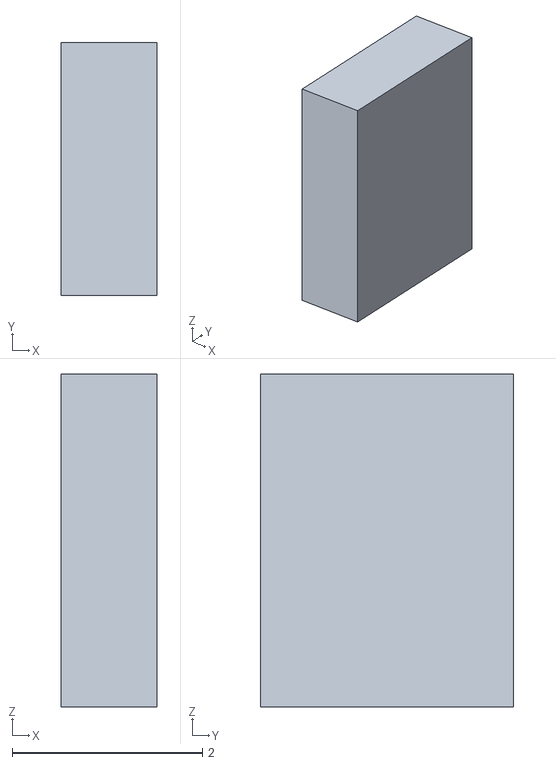
[picture p150: CAD file, 2026-10-16]
bittle_pi_addon/stl/models/parts/mic_sph0645__mic.stl
1.01 x 2.66 x 3.50
