LineChef/G2bittlex/bittle_pi_addon/stl/models/parts/mic_sph0645__pcb.stl

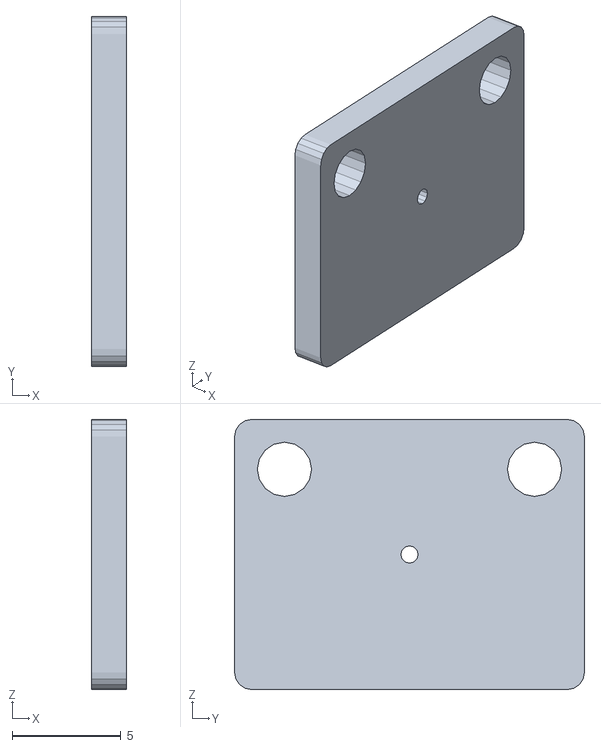
[picture p151: CAD file, 2026-10-16]
bittle_pi_addon/stl/models/parts/mic_sph0645__pcb.stl
1.60 x 16.1 x 12.5
