LineChef/G2bittlex/(list of files, cad)

Other CAD files:
bittle_pi_addon/stl/installed/pod_panel.stl
bittle_platform/stl/print/cover_pegs.stl
bittle_pi_addon/stl/installed/pod_logo_red.stl
bittle_pi_addon/stl/installed/pod_logo_white.stl
bittle_platform/stl/installed/starter_plate.stl
bittle_platform/stl/robot/tail.stl
bittle_pi_addon/stl/installed/pod_camera_mount.stl
bittle_platform/reference/Bittle_Cover_with_hole_for_Pi.stl
bittle_platform/stl/robot/rear_plate.stl
bittle_pi_addon/cad/pod_camera_base_low.step
bittle_pi_addon/stl/installed/pod_camera_cradle_low.stl
bittle_pi_addon/stl/installed/pod_body.stl
bittle_platform/reference/petoi_ros/rear__1.stl
bittle_platform/stl/robot/shank_rf.stl
bittle_platform/reference/petoi_ros/servo_lrs__1.stl
bittle_platform/stl/robot/shank_lr.stl
bittle_pi_addon/stl/installed/cover_pegs.stl
bittle_platform/stl/robot/shank_lf.stl
bittle_platform/reference/petoi_ros/servo_rfs_1.stl
bittle_platform/reference/petoi_ros/servos_rf_1.stl
bittle_platform/stl/robot/thigh_lf.stl
bittle_platform/reference/petoi_ros/c_thrf__1.stl
bittle_platform/stl/robot/thigh_lr.stl
bittle_platform/stl/robot/thigh_rr.stl
bittle_platform/stl/robot/battery.stl
bittle_platform/reference/petoi_ros/servo_rrs__1.stl
bittle_platform/reference/petoi_ros/servos_rr_1.stl
bittle_pi_addon/stl/models/camera_low.stl
bittle_platform/reference/petoi_ros/servos_lr_1.stl
bittle_platform/reference/petoi_ros/tube_lr_1.stl
bittle_platform/reference/petoi_ros/shank_rf_1.stl
bittle_platform/reference/petoi_ros/th_rf_1.stl
bittle_platform/reference/petoi_ros/tube__1.stl
bittle_platform/reference/petoi_ros/shank_rr_1.stl
bittle_pi_addon/stl/models/parts/wires_uart__gnd_dev.stl
bittle_platform/reference/petoi_ros/tho_lr_1.stl
bittle_platform/reference/petoi_ros/shank_lr_1.stl
bittle_pi_addon/stl/models/parts/wires_uart__rx2_dev.stl
bittle_platform/reference/petoi_ros/tho_rr_1.stl
bittle_platform/reference/petoi_ros/c_thlr_1.stl
bittle_platform/reference/petoi_ros/th_rr_1.stl
bittle_platform/reference/petoi_ros/c_thorf_1.stl
bittle_platform/reference/petoi_ros/c_thorr_1.stl
bittle_platform/reference/petoi_ros/c_thrr_1.stl
bittle_platform/reference/petoi_ros/tube_rr_1.stl
bittle_platform/reference/petoi_ros/th_lr__1.stl
bittle_platform/reference/petoi_ros/c_tholr__1.stl
bittle_platform/reference/petoi_ros/tho_rf__1.stl
bittle_pi_addon/stl/models/parts/wires_mic__lrcl_dev.stl
bittle_pi_addon/stl/models/parts/wires_mic__bclk_dev.stl
bittle_pi_addon/stl/models/parts/wires_mic__gnd_dev.stl
bittle_pi_addon/stl/models/parts/wires_mic__sel_dev.stl
servo_standoff/servo_spacers_frame_shape.scad
servo_standoff/shoulders_original.scad
hip_spacer/hip_spacers.scad
bittle_pi_addon/stl/models/parts/amp_ns4168__screws.stl
bittle_pi_addon/stl/models/parts/mic_sph0645__header.stl
bittle_pi_addon/stl/models/parts/pi_plugs__header.stl
bittle_pi_addon/stl/models/parts/pi_plugs__pins.stl
bittle_pi_addon/stl/models/parts/pizero__board.stl
bittle_pi_addon/stl/models/parts/pizero__heatsink.stl
bittle_pi_addon/stl/models/parts/speaker__body.stl
bittle_pi_addon/stl/models/parts/speaker__grille.stl
bittle_pi_addon/stl/models/parts/speaker__plate.stl
bittle_pi_addon/stl/models/parts/stack_screws__heads.stl
bittle_pi_addon/stl/models/parts/wires_amp__din_pi.stl
bittle_pi_addon/stl/models/parts/wires_amp__g_pi.stl
bittle_pi_addon/stl/models/parts/wires_amp__v_pi.stl
bittle_pi_addon/stl/models/parts/wires_camera__plug_pi.stl
bittle_pi_addon/stl/models/parts/wires_mic__3v_pi.stl
bittle_pi_addon/stl/models/parts/wires_mic__dout_dev.stl
bittle_pi_addon/stl/models/parts/wires_mic__dout_pi.stl
bittle_pi_addon/stl/models/parts/wires_mic__gnd_pi.stl
bittle_pi_addon/stl/models/parts/wires_mic__sel_pi.stl
bittle_pi_addon/stl/models/parts/wires_splice__bclk_pi.stl
bittle_pi_addon/stl/models/parts/wires_splice__lrclk.stl
bittle_pi_addon/stl/models/parts/wires_splice__lrclk_pi.stl
bittle_pi_addon/stl/models/parts/wires_splice__sleeves.stl
bittle_pi_addon/stl/models/parts/wires_uart__gnd.stl
bittle_pi_addon/stl/models/parts/wires_uart__gnd_pi.stl
bittle_pi_addon/stl/models/parts/wires_uart__rx2.stl
bittle_pi_addon/stl/models/parts/wires_uart__rx2_pi.stl
bittle_pi_addon/stl/models/parts/wires_uart__tx2.stl
bittle_pi_addon/stl/models/parts/wires_uart__tx2_pi.stl
bittle_pi_addon/stl/models/stack_screws.stl
bittle_pi_addon/stl/print/pod_body.stl
bittle_pi_addon/stl/print/pod_button.stl
bittle_pi_addon/stl/print/pod_camera_base_low.stl
bittle_pi_addon/stl/print/pod_camera_cradle_low.stl
bittle_pi_addon/stl/print/pod_camera_mount.stl
bittle_pi_addon/stl/print/pod_panel.3mf
bittle_pi_addon/stl/print/pod_panel.stl
bittle_platform/stl/print/starter_plate.stl
