LineChef/G2bittlex/bittle_pi_addon/doc/iso/step14-dark.png

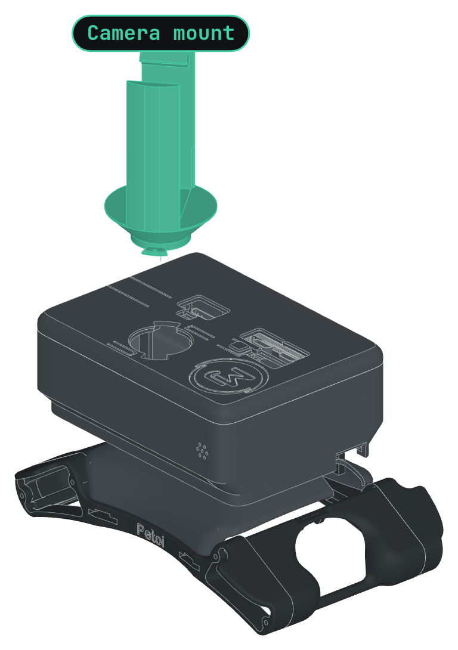
bittle_pi_addon/doc/iso/step14-dark.png
