LineChef/G2bittlex/bittle_platform/reference/petoi_ros/bittle.xacro

<?xml version="1.0" ?>
<robot name="bittle" xmlns:xacro="http://www.ros.org/wiki/xacro">

<xacro:include filename="$(find bittle_description)/urdf/materials.xacro" />
<xacro:include filename="$(find bittle_description)/urdf/bittle.trans" />
<xacro:include filename="$(find bittle_description)/urdf/bittle.gazebo" />
<link name="base_link">
  <inertial>
    <origin xyz="0.002168345924058267 4.1430032450566535e-08 0.02555254458454454" rpy="0 0 0"/>
    <mass value="0.01989030949409733"/>
    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
  </inertial>
  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
</link>

<link name="front__1">
  <inertial>
    <origin xyz="-0.00995696017036956 0.02800119957987551 -0.0005395302490400072" rpy="0 0 0"/>
    <mass value="0.0039123866206911126"/>
    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
  </inertial>
  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
</link>

<link name="rear__1">
  <inertial>
    <origin xyz="0.009956960170745259 -0.027998805995973614 -0.0005395302462037725" rpy="0 0 0"/>
    <mass value="0.003912386618757239"/>
    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
  </inertial>
  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
</link>

<link name="servo_rfs_1">
  <inertial>
    <origin xyz="-0.012134511463850035 0.0033276213458265785 0.007005695786782645" rpy="0 0 0"/>
    <mass value="0.016198785326804743"/>
    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
  </inertial>
  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
</link>

<link name="servo_rrs__1">
  <inertial>
    <origin xyz="0.012134511463850035 0.0033276213458265508 0.007005695786782652" rpy="0 0 0"/>
    <mass value="0.016198785326804747"/>
    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
  </inertial>
  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
</link>

<link name="c_neck__1">
  <inertial>
    <origin xyz="0.0003476160573467474 8.689791074277334e-16 0.0015392691836189978" rpy="0 0 0"/>
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
    <mass value="0.00015536650913631548"/>
    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
  </inertial>
  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
</link>

<link name="screw_18_1">
  <inertial>
    <origin xyz="0.00157978694253251 -5.17652568463034e-06 0.0027100960665014454" rpy="0 0 0"/>
    <mass value="0.00021546873291128856"/>
    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
  </inertial>
  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
</link>

<link name="screw_4_1">
  <inertial>
    <origin xyz="0.0008430432513749156 1.7441204459966303e-06 0.0014502220032721475" rpy="0 0 0"/>
    <mass value="0.00021546873291130613"/>
    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
  </inertial>
  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
</link>

<link name="screw_17_1">
  <inertial>
    <origin xyz="-0.001174799810430359 -0.0008553337714827221 -0.002067204247370044" rpy="0 0 0"/>
    <mass value="0.0002152287663382586"/>
    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
  </inertial>
  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
</link>

<link name="screw_21_1">
  <inertial>
    <origin xyz="-0.0011746645308375395 0.0008541636216472994 -0.0020669699362363993" rpy="0 0 0"/>
    <mass value="0.00021522876633827887"/>
    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
  </inertial>
  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
</link>

<link name="screw_6_1">
  <inertial>
    <origin xyz="0.0007669480407760387 -6.399272109451423e-07 0.001332486596943759" rpy="0 0 0"/>
    <mass value="0.00015537436580217523"/>
    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
  </inertial>
  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
</link>
<link name="screw_8_1">
  <inertial>
    <origin xyz="1.6435420446735127e-05 0.0023850033433144846 5.183193380785961e-06" rpy="0 0 0"/>
    <mass value="0.00021522876485298548"/>
    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
  </inertial>
  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
</link>

<joint name="Rigid 1" type="fixed">
  <origin xyz="0.061733 -0.028 0.025792" rpy="0 0 0"/>
  <parent link="base_link"/>
  <child link="front__1"/>
</joint>

<joint name="Rigid 2" type="fixed">
  <origin xyz="-0.061733 0.028 0.025792" rpy="0 0 0"/>
  <parent link="base_link"/>
  <child link="rear__1"/>
</joint>

<joint name="Rigid 3" type="fixed">
  <origin xyz="0.059645 -0.036 0.017875" rpy="0 0 0"/>
  <parent link="base_link"/>
  <child link="servo_rfs_1"/>
</joint>

<joint name="Rigid 5" type="fixed">
  <origin xyz="-0.059645 -0.036 0.017875" rpy="0 0 0"/>
  <parent link="base_link"/>
  <child link="servo_rrs__1"/>
</joint>

<joint name="Rigid 7" type="fixed">
  <origin xyz="0.044904 0.0 0.031351" rpy="0 0 0"/>
  <parent link="base_link"/>
  <child link="c_neck__1"/>
</joint>

<joint name="Rigid 8" type="fixed">
  <origin xyz="-0.008739 -0.00423 0.0263" rpy="0 0 0"/>
  <parent link="jaw_1"/>
  <child link="head__1"/>
</joint>

<joint name="Rigid 9" type="fixed">
  <origin xyz="0.016896 -0.012925 -0.001914" rpy="0 0 0"/>
  <parent link="servo_neck__1"/>
  <child link="jaw_1"/>
</joint>

<joint name="Rigid 10" type="fixed">
  <origin xyz="-0.013523 0.000445 -0.003623" rpy="0 0 0"/>
  <parent link="th_rf_1"/>
  <child link="tho_rf__1"/>
</joint>

<joint name="neck_joint" type="continuous">
  <origin xyz="0.00265 0.0 0.00459" rpy="0 0 0"/>
  <parent link="c_neck__1"/>
  <child link="servo_neck__1"/>
  <axis xyz="-0.5 -0.0 -0.866025"/>
</joint>

<joint name="Rigid 12" type="fixed">
  <origin xyz="-0.02335 -0.001807 -0.00172" rpy="0 0 0"/>
  <parent link="th_rf_1"/>
  <child link="tube__1"/>
</joint>

<joint name="Rigid 13" type="fixed">
  <origin xyz="0.0 -0.0023 0.0" rpy="0 0 0"/>
  <parent link="c_thrf__1"/>
  <child link="th_rf_1"/>
</joint>

<joint name="Rigid 14" type="fixed">
  <origin xyz="-0.03091 -0.004582 -0.008283" rpy="0 0 0"/>
  <parent link="tho_rf__1"/>
  <child link="c_thorf_1"/>
</joint>

<joint name="Rigid 4" type="fixed">
  <origin xyz="0.059645 0.036 0.017875" rpy="0 0 0"/>
  <parent link="base_link"/>
  <child link="servo_lfs_1"/>
</joint>

<joint name="Rigid 6" type="fixed">
  <origin xyz="-0.059645 0.036 0.017875" rpy="0 0 0"/>
  <parent link="base_link"/>
  <child link="servo_lrs__1"/>
</joint>

<joint name="Rigid 17" type="fixed">
  <origin xyz="-0.006412 -0.032855 0.027034" rpy="0 0 0"/>
  <parent link="base_link"/>
  <child link="a_1"/>
</joint>

<joint name="Rigid 18" type="fixed">
  <origin xyz="-0.002835 -0.03277 0.025616" rpy="0 0 0"/>
  <parent link="base_link"/>
  <child link="b__1"/>
</joint>

<joint name="Rigid 19" type="fixed">
  <origin xyz="0.000594 -0.032751 0.026875" rpy="0 0 0"/>
  <parent link="base_link"/>
  <child link="c_1"/>
</joint>

<joint name="Rigid 20" type="fixed">
  <origin xyz="0.002348 -0.032764 0.025618" rpy="0 0 0"/>
  <parent link="base_link"/>
  <child link="d_1"/>
</joint>

<joint name="Rigid 21" type="fixed">
  <origin xyz="0.005742 -0.032834 0.026061" rpy="0 0 0"/>
  <parent link="base_link"/>
  <child link="e_1"/>
</joint>

<joint name="Rigid 22" type="fixed">
  <origin xyz="0.00585 -0.032837 0.026934" rpy="0 0 0"/>
  <parent link="base_link"/>
  <child link="f_1"/>
</joint>

<joint name="shrfs_joint" type="continuous">
  <origin xyz="-0.007145 -0.0125 0.004125" rpy="0 0 0"/>
  <parent link="servo_rfs_1"/>
  <child link="c_thrf__1"/>
  <axis xyz="0.0 1.0 -0.0"/>
</joint>

<joint name="Rigid 24" type="fixed">
  <origin xyz="0.006412 0.032855 0.027034" rpy="0 0 0"/>
  <parent link="base_link"/>
  <child link="g_1"/>
</joint>

<joint name="Rigid 25" type="fixed">
  <origin xyz="0.002835 0.03277 0.025616" rpy="0 0 0"/>
  <parent link="base_link"/>
  <child link="h__1"/>
</joint>

<joint name="Rigid 26" type="fixed">
  <origin xyz="-0.000594 0.032751 0.026875" rpy="0 0 0"/>
  <parent link="base_link"/>
  <child link="i_1"/>
</joint>

<joint name="Rigid 27" type="fixed">
  <origin xyz="-0.002348 0.032764 0.025618" rpy="0 0 0"/>
  <parent link="base_link"/>
  <child link="j__1"/>
</joint>

<joint name="Rigid 28" type="fixed">
  <origin xyz="-0.005742 0.032834 0.026061" rpy="0 0 0"/>
  <parent link="base_link"/>
  <child link="k_1"/>
</joint>

<joint name="Rigid 29" type="fixed">
  <origin xyz="-0.005742 0.032834 0.0272" rpy="0 0 0"/>
  <parent link="base_link"/>
  <child link="l_1"/>
</joint>

<joint name="Rigid 30" type="fixed">
  <origin xyz="-0.008218 0.0075 0.000719" rpy="0 0 0"/>
  <parent link="servos_rf_1"/>
  <child link="shank_rf_1"/>
</joint>

<joint name="shrft_joint" type="continuous">
  <origin xyz="0.0 0.007857 0.0" rpy="0 0 0"/>
  <parent link="c_thorf_1"/>
  <child link="servos_rf_1"/>
  <axis xyz="0.0 1.0 -0.0"/>
</joint>

<joint name="Rigid 32" type="fixed">
  <origin xyz="-0.013523 0.000445 -0.003623" rpy="0 0 0"/>
  <parent link="th_rr_1"/>
  <child link="tho_rr_1"/>
</joint>

<joint name="Rigid 33" type="fixed">
  <origin xyz="-0.02335 -0.001807 -0.00172" rpy="0 0 0"/>
  <parent link="th_rr_1"/>
  <child link="tube_rr_1"/>
</joint>

<joint name="Rigid 34" type="fixed">
  <origin xyz="0.0 -0.0023 0.0" rpy="0 0 0"/>
  <parent link="c_thrr_1"/>
  <child link="th_rr_1"/>
</joint>

<joint name="Rigid 35" type="fixed">
  <origin xyz="-0.03091 -0.004582 -0.008283" rpy="0 0 0"/>
  <parent link="tho_rr_1"/>
  <child link="c_thorr_1"/>
</joint>

<joint name="Rigid 36" type="fixed">
  <origin xyz="-0.008218 0.0075 0.000719" rpy="0 0 0"/>
  <parent link="servos_rr_1"/>
  <child link="shank_rr_1"/>
</joint>

<joint name="shrrs_joint" type="continuous">
  <origin xyz="0.007145 -0.0125 0.004125" rpy="0 0 0"/>
  <parent link="servo_rrs__1"/>
  <child link="c_thrr_1"/>
  <axis xyz="0.0 -1.0 -0.0"/>
</joint>

<joint name="shrrt_joint" type="continuous">
  <origin xyz="0.0 0.007857 0.0" rpy="0 0 0"/>
  <parent link="c_thorr_1"/>
  <child link="servos_rr_1"/>
  <axis xyz="0.0 1.0 -0.0"/>
</joint>

<joint name="Rigid 39" type="fixed">
  <origin xyz="-0.013523 -0.000445 -0.003623" rpy="0 0 0"/>
  <parent link="th_lf_1"/>
  <child link="tho_lf_1"/>
</joint>

<joint name="Rigid 40" type="fixed">
  <origin xyz="-0.02335 0.001807 -0.00172" rpy="0 0 0"/>
  <parent link="th_lf_1"/>
  <child link="tube_lf_1"/>
</joint>

<joint name="Rigid 41" type="fixed">
  <origin xyz="0.0 0.0023 0.0" rpy="0 0 0"/>
  <parent link="c_thlf_1"/>
  <child link="th_lf_1"/>
</joint>

<joint name="Rigid 42" type="fixed">
  <origin xyz="-0.03091 0.004582 -0.008283" rpy="0 0 0"/>
  <parent link="tho_lf_1"/>
  <child link="c_tholf_1"/>
</joint>

<joint name="Rigid 43" type="fixed">
  <origin xyz="-0.008218 -0.007498 0.000719" rpy="0 0 0"/>
  <parent link="servos_lf_1"/>
  <child link="shank_lf_1"/>
</joint>

<joint name="shlfs_joint" type="continuous">
  <origin xyz="-0.007145 0.0125 0.004125" rpy="0 0 0"/>
  <parent link="servo_lfs_1"/>
  <child link="c_thlf_1"/>
  <axis xyz="-0.0 1.0 0.0"/>
</joint>

<joint name="shlft_joint" type="continuous">
  <origin xyz="0.0 -0.007857 0.0" rpy="0 0 0"/>
  <parent link="c_tholf_1"/>
  <child link="servos_lf_1"/>
  <axis xyz="-0.0 1.0 0.0"/>
</joint>

<joint name="Rigid 46" type="fixed">
  <origin xyz="-0.013523 -0.000445 -0.003623" rpy="0 0 0"/>
  <parent link="th_lr__1"/>
  <child link="tho_lr_1"/>
</joint>

<joint name="Rigid 47" type="fixed">
  <origin xyz="-0.02335 0.001807 -0.00172" rpy="0 0 0"/>
  <parent link="th_lr__1"/>
  <child link="tube_lr_1"/>
</joint>

<joint name="Rigid 48" type="fixed">
  <origin xyz="0.0 0.002302 0.0" rpy="0 0 0"/>
  <parent link="c_thlr_1"/>
  <child link="th_lr__1"/>
</joint>

<joint name="Rigid 49" type="fixed">
  <origin xyz="-0.03091 0.004582 -0.008283" rpy="0 0 0"/>
  <parent link="tho_lr_1"/>
  <child link="c_tholr__1"/>
</joint>

<joint name="Rigid 50" type="fixed">
  <origin xyz="-0.008218 -0.0075 0.000719" rpy="0 0 0"/>
  <parent link="servos_lr_1"/>
  <child link="shank_lr_1"/>
</joint>

<joint name="shlrs_joint" type="continuous">
  <origin xyz="0.007145 0.0125 0.004125" rpy="0 0 0"/>
  <parent link="servo_lrs__1"/>
  <child link="c_thlr_1"/>
  <axis xyz="-0.0 -1.0 0.0"/>
</joint>

<joint name="shlrt_joint" type="continuous">
  <origin xyz="0.0 -0.007857 0.0" rpy="0 0 0"/>
  <parent link="c_tholr__1"/>
  <child link="servos_lr_1"/>
  <axis xyz="0.0 1.0 -0.0"/>
</joint>

<joint name="Rigid 53" type="fixed">
  <origin xyz="0.000391 0.021805 0.016353" rpy="0 0 0"/>
  <parent link="cover_1"/>
  <child link="logo_5_1"/>
</joint>

<joint name="Rigid 54" type="fixed">
  <origin xyz="-0.001444 0.027596 0.016353" rpy="0 0 0"/>
  <parent link="cover_1"/>
  <child link="logo_1_1"/>
</joint>

<joint name="Rigid 55" type="fixed">
  <origin xyz="-0.001444 0.029425 0.016353" rpy="0 0 0"/>
  <parent link="cover_1"/>
  <child link="logo_2_1"/>
</joint>

<joint name="Rigid 56" type="fixed">
  <origin xyz="-0.001453 0.03613 0.016353" rpy="0 0 0"/>
  <parent link="cover_1"/>
  <child link="logo_3_1"/>
</joint>

<joint name="Rigid 57" type="fixed">
  <origin xyz="0.005058 0.021805 0.016353" rpy="0 0 0"/>
  <parent link="cover_1"/>
  <child link="logo_4_1"/>
</joint>

<joint name="Rigid 58" type="fixed">
  <origin xyz="0.0 -0.031 0.030939" rpy="0 0 0"/>
  <parent link="base_link"/>
  <child link="cover_1"/>
</joint>

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
  <origin xyz="-0.001375 0.005264 0.01032" rpy="0 0 0"/>
  <parent link="servo_neck__1"/>
  <child link="screw_4_1"/>
</joint>

<joint name="Rigid 85" type="fixed">
  <origin xyz="0.001 -0.00675 0.001732" rpy="0 0 0"/>
  <parent link="c_neck__1"/>
  <child link="screw_17_1"/>
</joint>

<joint name="Rigid 86" type="fixed">
  <origin xyz="0.001 0.00675 0.001732" rpy="0 0 0"/>
  <parent link="c_neck__1"/>
  <child link="screw_21_1"/>
</joint>

<joint name="Rigid 87" type="fixed">
  <origin xyz="0.0004 0.0 0.000693" rpy="0 0 0"/>
  <parent link="c_neck__1"/>
  <child link="screw_6_1"/>
</joint>
<joint name="Rigid 88" type="fixed">
  <origin xyz="0.020173 0.0075 -0.001765" rpy="0 0 0"/>
  <parent link="servos_rf_1"/>
  <child link="screw_8_1"/>
</joint>

</robot>
