LineChef/G2bittlex/(commit log)

2026-10-14 Add the Bittle X platform and the Pi add-on
    bittle_platform is the stock Petoi back cover with 4 pegs, the keyhole
    interface for add-ons, and a starter plate. bittle_pi_addon is a tray,
    a lid and a plug for a Pi Zero 2 W, a PiSugar 2, an I2S amp with a
    speaker, and an I2S mic. Each package has its build script, print STLs,
    STEP files and a short PDF.
    Code is MIT and the designs are CC BY 4.0. ATTRIBUTION.md lists the
    Petoi and PiSugar files and their sources.
    [Bittle_Cover.stl, Bittle_Cover_with_hole_for_Pi.stl, Bittle_FrontPlate.stl, Bittle_SideShoulder.stl, RaspberryPiZeroW-1.STL, amp_ns4168.stl, battery.stl, biboard_header.stl]
2026-10-14 Add a break-off foot for the standing cover print
    The cover stands on a 56 x 1.6 mm strip, and its center of mass is
    2 mm past that strip. cover_pegs_foot.stl adds a 3-layer plate and 7
    fins under the leaning face. The fins touch the cover only at small
    teeth. The first layer grows from 53 to about 1000 mm2.
    [cover_pegs_foot.stl]
2026-10-14 Add the Bittle X V2 touch sensor notes to the platform spec
    The V2 has a touch sensor circuit glued inside the cover top. The spec
    now says to move it to cover_pegs, to disable back touch mode when an
    add-on covers it, and why the platform has no parts under the top.
2026-10-14 Add part cards, a move tool and build steps to the viewer
    Click a part to see what it is, how it attaches, its size and its
    files. The card can isolate, hide, ghost the other parts, zoom to the
    part, and drag it out of the assembly. "Start the build" animates the
    11 steps of the build guide. #part=<id> and #step=<n> open a part or a
    step from a link. The part texts and the steps are in build_site.py.
2026-10-14 Link the viewer build steps from the Pi add-on guide
    The assembly section has a link to the viewer and a link to the
    matching viewer step on each line. The PDF writer now turns
    markdown links into PDF links.
2026-10-14 Balance the Pi add-on and add an assembly STEP
    Move the speaker from the rear to the front of the tray and the mic
    to the rear. The center of mass of the add-on moves from 28.6 mm to
    7.4 mm behind the robot center. The lid is 4.8 mm taller and 19 mm
    shorter. pod.py now prints the balance and writes it to checks.json.
    The speaker pins are 9.7 mm long, so they also hold a speaker whose
    ear tabs are half way up the side of the body.
    pod.py also writes cad/assembly.step: the robot, the platform and the
    add-on in place, with named and colored parts. The repository and the
    site have it zipped (10 MB).
    The platform spec has a balance rule, and the envelope is updated.
    [cover_slot.stl, mic_sph0645.stl, pod_lid.stl, pod_tray.step, pod_tray.stl, speaker.stl, usb_plug.step]
2026-10-14 Fix weak features from the print review and add a camera slot
    Fixes from a review of the printed parts:
    - Speaker pins: the wall stopped below the pins, so each pin joined
    it over 0.6 mm2. The wall now goes 2 mm over the pins. The pins are
    point-down teardrops, with no flat underside to hang in the print.
    - Lid snaps: the outline clip cut the tray bumps flush, so the lid had
    no hold. The bumps now stand on rim tabs above the lid flare, with a
    45 deg underside, and the lid grooves are at the same height.
    - Detent beams (platform v1.1): the drop-in hole of the front keyhole
    cut the rear beam root to a 0.45 mm neck. The beam now starts 1 mm
    clear of the hole: arm 7.6, width 1.2, tra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
    [camera_cable.stl, detent_bumps.step, keyhole_cutter.step, pegs.step, pod_lid.stl, pod_tray.step, pod_tray.stl, starter_plate.step]
2026-10-14 Center the Pi stack on the add-on
    The Pi + PiSugar 2 stack (about 42 g) was 8 mm right of the center
    line. It is now near the center line, and the add-on center of mass
    is 0.2 mm left of it (was 3.4 mm right). It is 9.3 mm behind the
    robot center, inside the 10 mm rule.
    There is no room left of a centered stack for the amp, so:
    - The amp stands crosswise behind the stack, components to the rear.
    The lid is 7 mm longer. The tray has no rim behind the amp.
    - The mic stands on the left side, beside the GPIO edge, port to the
    left wall.
    - The battery rails are at X +-6, clear of the peg heads.
    - The PCB locators have all 4 corners, cut clear of the peg heads.
    The PiSugar ports are now 12 m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
    [amp_ns4168.stl, battery.stl, cover_slot.stl, mic_sph0645.stl, pisugar2.stl, pizero.stl, pod_lid.stl, pod_tray.step]
2026-10-14 Bring the button pusher to 0.3 mm from the PiSugar button
    The stack moved, and the pusher tip stopped 1.0 mm short of the
    button. The checks show no contact with the PiSugar board.
    [pod_lid.stl, pod_tray.step, usb_plug.step]
2026-10-14 Add a large switch knob and widen the charge opening
    A review of port access in the centered layout found that the PiSugar
    switch lever is 12 mm inside the wall and needs a tool. Add two printed
    parts: sw_knob outside the right wall and sw_slider inside. The slider
    fork holds 1.2 mm of the lever and is open at the bottom, so it drops
    over the lever with the lid. The checks show no contact at +-2.6 mm
    of travel.
    Widen the charge opening to 12.4 x 8.5 mm for larger cable plugs. Tell
    the user in the guide how to remove the SD card and which ports need
    the lid off. Version 0.10.
    [pod_lid.stl, pod_tray.step, sw_knob.step, sw_knob.stl, sw_slider.step, sw_slider.stl, usb_plug.step, usb_plug.stl]
2026-10-14 Form the lid around the ports with two open port bays
    The centered stack put the Pi and PiSugar ports 11 mm inside the body
    side. The right lid wall now steps in to 0.45 mm from the port faces in
    two open bays. The front bay has the charge port, the button and the
    Pi power and data USB ports. The rear bay has the mini-HDMI port and
    the switch. The bay floors are 45 deg slopes, so the lid prints
    without supports.
    Plug bodies of 11 x 7.5 mm (micro-USB) and 14 x 8.5 mm (mini-HDMI)
    are clear of the lid and the tray. The bay wall is open over the
    BiBoard Dupont plugs: the data USB plug body passes 0.25 mm above
    them. The right rim snaps move clear of the bays.
    Remove the switch knob, the switch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
    [pod_lid.stl, pod_tray.step, pod_tray.stl, sw_knob.step, sw_knob.stl, sw_slider.step, sw_slider.stl, usb_plug.step]
2026-10-14 Show the full robot in the viewer, with pose sliders and motion checks
    Add the head, the legs, the hip servos, the rear plate, the battery and
    the tail from Petoi's ROS model of Bittle (MIT). bittle_platform/robot.py
    moves the meshes into the robot frame and puts the legs in a standing
    pose. The viewer turns the head, the hips and the knees with sliders,
    and it shows a note when a pose touches the add-on.
    bittle_pi_addon/motion.py checks the motion against the add-on. The head
    turns -45 to 45 deg without contact. The legs touch the add-on only when
    a thigh swings up over the back. The Petoi tail touches the rear of the
    lid. At the drop-on place the speaker hits the head, so the guide now
    pu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
    [Bittle_tail.stl, battery.stl, battery_1.stl, bittle.xacro, c_neck__1.stl, c_thlf_1.stl, c_thlr_1.stl, c_tholf_1.stl]
2026-10-14 Add a top vent insert in a second color
    The vent slots move from the lid into top_insert, a separate part for a
    second filament color. It goes into a window in the lid top from
    outside and sits flush on a 45 deg seat. Four clips catch 0.45 mm under
    a frame below the window. The frame is 3.8 mm above the Pi, so the
    wires still go over the Pi. Both parts print without supports.
    The viewer shows the lid in gray and the insert in orange, with buttons
    to try gray, orange, navy, white and black on each part.
    [pod_lid.stl, pod_tray.step, top_insert.step, top_insert.stl]
2026-10-14 Widen the tray keyholes by 0.25 mm
    The tray was tight on the pegs. The slot is now 4.65 wide (was 4.4) and
    the drop-in hole is 7.85 (was 7.6). The detent bump stays at the same
    place, so the click does not change. Platform v1.2, add-on v0.12.
    [detent_bumps.step, keyhole_cutter.step, pod_tray.step, pod_tray.stl, starter_plate.step, starter_plate.stl, top_insert.step]
2026-10-15 Widen the tray keyholes to 5.2 mm, keep the click
    The v1.2 tray was still too tight on the pegs. The slot is now 5.2 wide
    (0.6 gap each side) and the drop-in hole is 8.4 (0.7 gap each side).
    The bump now follows the slot width, so it still moves the beam 0.3.
    The arm is 7.0, so the beam root stays clear of the larger drop-in hole
    of the keyhole in front. Platform v1.3, add-on v0.13.
    [detent_bumps.step, keyhole_cutter.step, pod_tray.step, pod_tray.stl, starter_plate.step, starter_plate.stl, top_insert.step]
2026-10-15 Platform v2.0: teardrop pegs, centering clicks, keyed lid
    Platform v2.0 (not compatible with v1.x: reprint the cover):
    - The peg heads and the drop-in holes are teardrops that point to the
    front. Turned 180 deg, an add-on does not go down over the pegs.
    - The shaft and the collar point to the rear. The cover prints standing
    on its rear end, so these points are down and need no supports.
    - Pegs at Z +-10 (was +-8), so the longer holes stay clear of the next
    keyhole. Head underside 0.3 over the plate (was 0.2).
    - Two spring beams at each slot. Their bumps push the shaft against a
    round front stop and center it in X. About 4 N to slide on or off,
    strain 1.1 %. build.py has the force m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
    [cover_pegs.stl, cover_pegs_foot.stl, detent_bumps.step, keepout.stl, keyhole_cutter.step, pegs.step, pod_lid.stl, pod_tray.step]
2026-10-15 Platform v3.0: slide forward to lock, remove the closed add-on to the rear
    With the lid on, the add-on could not slide 3 mm toward the head, so
    the only way off was to open the lid first. 7 mm to the rear is clear.
    Platform v3.0 (not compatible with earlier versions):
    - The add-on drops on 7 mm behind its place and slides forward to lock.
    To remove it, slide it rearward and lift it.
    - All teardrop points (head, shaft, collar) are to the rear: the cover
    prints with no peg overhangs. The drop-in holes point to the slot, so
    a plate turned 180 deg does not go down.
    - The slot ends in a V stop. The two bumps push the shaft point into it,
    which centers the add-on. 0.4 lead-in chamfers on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
    [cover_pegs.stl, cover_pegs_foot.stl, detent_bumps.step, keepout.stl, keyhole_cutter.step, pegs.step, pod_lid.stl, pod_tray.step]
2026-10-15 Pi add-on v0.16: one-piece body, snap-in panel, power slider
    The tray and lid are replaced by a rounded body and a top panel. The
    body clicks onto the pegs empty and every part goes in from the top:
    mic at the front wall, the Pi stack on its long edge over the robot
    center, the speaker at the rear, the amp along the left wall. The
    BiBoard plug is inside the right wall, so no wires leave the case.
    The panel has four spring tabs (about 9 N to close), openings shaped
    to the plug bodies, a spring tongue over the PiSugar button, and a
    slot for a new slider part that moves the PiSugar power switch.
    pod.py checks the install paths, the wire paths, finger room over the
    BiBoard plug, the slider trav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
    [amp_ns4168.stl, battery.stl, biboard_header.stl, biboard_plug.stl, camera_cable.stl, cover_pegs_foot.stl, cover_slot.stl, detent_bumps.step]
2026-10-15 Model the Pi add-on electronics and wires in detail
    The block models of the electronics are replaced with detailed parts:
    the Pi 2x20 header with Dupont housings on the 15 pins in use, the
    NS4168 amp laid out from the NULLLAB photo, the SPH0645 board with its
    pin row, the speaker, the pouch cell and the SD card. Each jumper is a
    1.4 mm wire on its route, and check() keeps every wire off the printed
    parts and the other boards.
    The photo shows side-entry PH2.0 connectors on the amp. Its I2S plug
    hit the speaker post at the rear, so the amp moves 6 mm forward with
    the I2S end at the front, and the amp cable crosses under the stack
    in front of the front pegs. The mic pin row is along its 16.7 m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
    [amp_ns4168.stl, amp_ns4168__headers.stl, amp_ns4168__ic.stl, amp_ns4168__pcb.stl, amp_ns4168__plugs.stl, amp_ns4168__rings.stl, amp_ns4168__screws.stl, amp_ns4168__terminal.stl]
2026-10-15 Route the wires from the wiring blueprint, notch the cover
    The wire routes follow reference/g2-wiring-blueprint.html: BiBoard
    TX2, RX2 and GND on Pi pins 10, 8 and 6; amp and mic I2S with
    soldered BCLK and LRCLK splices on pins 12 and 35; mic SEL to pin 39.
    The camera wires to the Pi are removed. Each route has rounded bends
    of at least 2 mm radius, and pod.py checks that no wire passes through
    another wire, a printed part or a board.
    Platform v3.1 has a notch in the front-left edge of the cover for the
    BiBoard Grove plug of the head camera. GROVE_PLUG in interface.py and
    keepout.stl give its space. The add-on body has 45 deg notches at the
    front bottom corners and floor openings over the p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
    [battery.stl, battery__lead0.stl, battery__lead1.stl, biboard_plug.stl, biboard_plug__housings.stl, cover_pegs.stl, cover_pegs_foot.stl, detent_bumps.step]
2026-10-15 Model the 10 cm pack jumpers and add a wiring page per module
    The BiBoard and mic wires are 10 cm female-female pack jumpers. Each
    one goes in its place one at a time, in the plug order of the guide.
    Its excess over the route is an arch or a service loop in free space,
    chosen to stay clear of the parts, the wires already in place and the
    routes still to come. check() counts wire crossings and bends.
    The mic stands with a right-angle header along its right edge, so the
    jumpers plug onto it and run into the right well. The LRCLK splice
    moves to X 21.0 and the BiBoard wires rise at X 27.0.
    The build guide has a wiring page for each module: a pin diagram from
    the module connector to the Pi hea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
    [mic_sph0645.stl, mic_sph0645__header.stl, mic_sph0645__housings.stl, mic_sph0645__mic.stl, mic_sph0645__pads.stl, mic_sph0645__pcb.stl, pod_body.step, pod_body.stl]
2026-10-15 Neat wire slack, centered battery, Pi heatsink, wire build steps
    Each 10 cm jumper keeps its excess as an arch or a service loop near
    its route. The search prefers slack that stays in the right well and
    tries the next shapes until one stays clear after the clean-up. Splice
    legs are cut to length and bend at 2 mm or more.
    The Pi stack moves 4.9 mm right, so the battery is nearer the center
    line (add-on center of mass 0.6 mm left of it, was 2.6 mm). The plugs
    on the Pi and mic headers are 10 mm Dupont housings (user
    measurement). The mic moves 2.7 mm right, clear of the SD card. The
    Pi has a pin-fin heatsink on the SoC (size estimated). The speaker
    ear plate is at the middle of its body depth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
    [battery.stl, battery__cell.stl, battery__flap.stl, battery__lead0.stl, battery__lead1.stl, biboard_plug.stl, biboard_plug__housings.stl, mic_sph0645.stl]
2026-10-15 Hold the battery in a bay, show the wires through the case
    The cell was held only by its tape on the PiSugar 2. Three blocks on
    the floor now carry it (0.2 mm under it, clear of the keyholes and the
    amp cable). Two plates from the panel stand along its outer face and
    pads lie over its top edge (0.3 mm). check() moves the cell 0.5 mm
    left, up and down: each time it touches the panel or the body.
    In the wire steps of the viewer the body and the panel go see-through,
    and the stack too for the amp cable, so the wire being laid shows. The
    wire camera looks down into the right well. The slack names read as
    "arch" or "3-turn loop on a 5 mm stem".
    [pod_body.step, pod_body.stl, pod_panel.step, pod_panel.stl, pod_switch.step]
2026-10-15 Add camera mount, button cap and staged exploded view
    The add-on is now v0.17.
    - The white button cap is a separate part. It slides onto the panel
    tongue on a dovetail and clicks in place.
    - The switch slider rides in rails under the panel and clicks in.
    Both parts stay in the panel, so the panel puts them in place.
    - A camera mount clicks into a window at the front of the panel.
    Two U brackets hold the Petoi AI Vision Module, lens forward.
    - Each Dupont housing is part of its wire in the 3D model.
    - The install checks lower each wire against the parts and wires
    that are already in place. The BiBoard wires go in first.
    - The balance uses the weighed masses of the parts.
    - The explod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
    [biboard_plug__housings.stl, camera.stl, camera__case.stl, mic_sph0645__housings.stl, pi_plugs__housings.stl, pi_plugs__pins.stl, pod_body.step, pod_button.step]
2026-10-15 Wire the camera, snap it into a stronger mount, use 2 mm walls
    The add-on is now v0.18.
    - The body and panel walls are 2.0 mm. With the offsets of the body
    profile, Cura slices 4 full lines of 0.5 mm. At 1.8 mm it saw 3.57
    lines and changed between 3 and 4 lines along the wall.
    - The camera is upside down, so its Grove socket is on the left and
    clear of the HDMI opening. Turn the image in software.
    - A 10 cm Grove cable goes from the camera socket down through a slot
    in the panel, forward under the panel, and down the front left
    corner in an S fold to the BiBoard. It touches no part or wire.
    - The mount has a 2 mm base with a 45 deg chin over the panel edge.
    A ridge on each brac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
    [amp_ns4168.stl, amp_ns4168__headers.stl, amp_ns4168__ic.stl, amp_ns4168__pcb.stl, amp_ns4168__plugs.stl, amp_ns4168__rings.stl, amp_ns4168__screws.stl, amp_ns4168__terminal.stl]
2026-10-15 Keep each Dupont housing on its wire in the model
    A jumper comes with its housings on it, so the model now shows it
    that way.
    - Each wire step in the viewer brings in the wire and its housings
    together. The mic step and the amp step no longer show housings
    without their wires.
    - The exploded view moves each housing with its wire. The Pi stack
    and its wire harness leave as one block, because a rigid housing
    cannot slide off a Pi pin without its wire going through the wall.
    The slider and the button cap stay in the panel.
    - The exploded path now has no contact between any two parts.
    [build_site.py, pod.py]
2026-10-15 Add one Cura profile for every part: Bittle X
    - cura/install_profiles.py writes the "Bittle X" profile into Cura.
    It also writes a copy for each spool that the tolerance app
    measured, with that spool's size compensation, the same way the
    tolerance app installs a profile.
    - cura/Bittle_X.curaprofile is the base profile, for import in Cura
    on another computer.
    - The profile uses 0.20 mm layers (0.25 first layer), no supports
    and a 6-line brim. Every part prints with it.
    - The cover foot plate is 0.70 mm, so it is 3 whole layers. Each
    break-off tooth is exactly one layer at 0.20 mm.
    - Both guides name the one profile.
    [cover_pegs_foot.stl, detent_bumps.step, keyhole_cutter.step, pegs.step, starter_plate.step]
2026-10-15 Let the viewer give every part any color
    - A Colors section is always visible. It has a row for each printed
    part: body, panel, switch slider, button cap, camera mount and
    platform cover. Each row has buttons for the project filaments
    (white, gray, orange, navy, black) and a picker for any color.
    - The color square of each part in the parts list opens a color
    picker, so any part can have any color.
    - The browser keeps the colors. "Reset colors" goes back to the
    defaults. "Copy a link to these colors" gives a link with
    #colors=part:color,... that opens the model with them.
2026-10-16 Tighten the camera mount clip legs, soften the peg click
    The clip legs now fill the panel window to 0.05 at the sides and 0.1
    at the front and back, and the hooks catch 0.05 under the frame.
    The click bumps go 0.28 into the shaft path (was 0.35): about 3.2 N
    to slide the add-on on or off (was 4.2 N).
    [detent_bumps.step, keyhole_cutter.step, pegs.step, pod_body.step, pod_body.stl, pod_button.step, pod_camera_mount.step, pod_camera_mount.stl]
2026-10-16 Slide-on panel, press-fit button cap, stronger camera hold
    The panel goes down 5 mm behind its place and slides forward. 45 deg
    hooks go under lugs in the front and side walls, and a latch tongue
    in the top clicks over a rib on the rear wall. Every spring now bends
    along the print layers (the old tabs cracked across them). The
    switch slider has 5 mm more travel to the front, so it stays on the
    lever while the panel slides.
    The button cap presses into a round hole with a ribbed cross post.
    The camera mount clip hooks are 0.8 mm. The bracket ridges are
    0.8 mm with a steep lower face at the bottom edge of the case
    pockets, so the camera lifts only 0.3 mm before they catch.
    [pod_body.step, pod_body.stl, pod_button.step, pod_button.stl, pod_camera_mount.step, pod_camera_mount.stl, pod_panel.step, pod_panel.stl]
2026-10-16 Barb the camera clip hooks, open the button cap hole
    The clip hooks and the frame walls under them have a 10 deg barb.
    A pull on the mount pushes the hooks out under the walls, not in.
    The legs are 0.9 mm thick (was 0.8).
    The button cap hole is 3.8 mm and the post ribs are 0.05 mm over
    it. Small holes print about 0.2 mm under size.
    [pod_body.step, pod_button.step, pod_button.stl, pod_camera_mount.step, pod_camera_mount.stl, pod_panel.step, pod_panel.stl, pod_switch.step]
2026-10-16 Loosen the switch slider in the panel
    The tab slot is 0.3 mm clear of the tab (was 0.1). The rail walls
    are 0.25 mm outside the slider body (was 0.15). The lips reach the
    same 45 deg line under the body.
    [pod_body.step, pod_button.step, pod_camera_mount.step, pod_panel.step, pod_panel.stl, pod_switch.step]
2026-10-16 Turn the layout to match the robot, vertical camera, head-off mount
    The cover model was turned 180 deg from the robot: the BiBoard
    header is at the front left. Platform v3.2 turns the cover model;
    the pegs and keyholes do not change. Reprint the cover.
    Add-on v0.22:
    - The Pi stack is turned end for end, header toward the BiBoard.
    The amp moves to the right wall, the Pi wires to the left well.
    The add-on is designed in a mirror frame; outputs are robot frame.
    - The camera stands vertical, USB port up, 9 mm right of center,
    held by side brackets with hooks over the top corners. The Grove
    cable goes down a notch at the rear of the camera window.
    - Optional head-off mount: a base and a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
    [amp_ns4168.stl, amp_ns4168__headers.stl, amp_ns4168__ic.stl, amp_ns4168__pcb.stl, amp_ns4168__plugs.stl, amp_ns4168__rings.stl, amp_ns4168__screws.stl, amp_ns4168__terminal.stl]
2026-10-16 Use a USB camera cable, open the switch, model speaker wings
    The camera connects to the Pi with a USB-C to micro-USB cable. The
    Grove cable, the notches for it in the panel and the camera mount, and
    the floor opening and chamfer at the front left are removed. The cable
    goes in a half circle from the top of the camera to the Pi data port.
    The switch slider part is removed. A window in the panel is over the
    PiSugar switch lever. The speaker has tapered wings and the caliper
    sizes from the user. The board grooves use the measured 3.96 mm stack.
    The explode slider in the viewer no longer moves the camera.
    [pod_body.step, pod_body.stl, pod_button.step, pod_camera_base_low.step, pod_camera_cradle_low.step, pod_camera_mount.step, pod_camera_mount.stl, pod_panel.step]
2026-10-16 Move the mic to the front right corner on a screw boss
    The mic board is the measured 12.45 x 16.12. It stands flat on two
    bosses on the front wall in the front right corner, with its straight
    header next to the side wall, so the plugs point rearward. An M2 screw
    through the upper hole goes into a heat-set insert, and a pin on the
    lower boss goes into the lower hole.
    The mic wires make a U turn inward, cross behind the front wall in
    front of the stack, and then run rearward in the left well as before.
    The GND and 3V routes are 121 and 133 mm, so those two jumpers are
    15 cm. The open renders no longer show the USB cable.
    [mic_sph0645.stl, mic_sph0645__header.stl, mic_sph0645__mic.stl, mic_sph0645__pcb.stl, mic_sph0645__screw.stl, pod_body.step, pod_body.stl, pod_button.step]
2026-10-16 Widen the body to the cover shell above a floor chamfer
    The body is 71.2 mm wide above Y 36, the width of the robot cover
    shell, for more room for the wires. At the floor it stays 59.2 mm wide,
    with a 45 deg chamfer between Y 30 and Y 36. Full width to the floor put
    the bottom rear corners in the way of the rear legs from a -60 deg hip
    swing. With the chamfer, the rear legs touch only from -105 deg.
    The amp, its slot bar, the BiBoard floor notch and the mic stay at the
    floor width. The amp nubs are now posts that rise behind the amp.
    [mic_sph0645.stl, pod_body.step, pod_body.stl, pod_button.step, pod_camera_base_low.step, pod_camera_base_low.stl, pod_camera_cradle_low.step, pod_camera_mount.step]
2026-10-16 Move the mic up and out to the corner for screw access
    The mic board is 1.3 mm higher and 5.5 mm nearer the right wall, so
    the screw is 6.7 mm from the battery and a screwdriver reaches it with
    the stack in place. Its housings are now outside the amp cable, so the
    mic wires rise over the cable before they turn inward.
    The DOUT route is now 98 mm, so DOUT is a 15 cm jumper too, with GND
    and 3V.
    [mic_sph0645.stl, mic_sph0645__header.stl, mic_sph0645__mic.stl, mic_sph0645__pcb.stl, mic_sph0645__screw.stl, pod_body.step, pod_body.stl, pod_button.step]
2026-10-16 Mount the mic on the right wall with straight wires
    The mic board stands flat on two bosses on the right wall near the
    front, port to the wall, with the sound holes in the side face. Its
    header is on the front edge, so the plugs point inward and the wires
    go straight across behind the front wall to the left well, with no U
    turn and no rise over the amp cable.
    The routes are shorter: only GND (102 mm) and 3V (115 mm) need 15 cm
    jumpers. The plugs go down behind the front wall lugs.
    [mic_sph0645.stl, mic_sph0645__header.stl, mic_sph0645__mic.stl, mic_sph0645__pcb.stl, mic_sph0645__screw.stl, pod_body.step, pod_body.stl, pod_button.step]
2026-10-16 Add assembly labels, a logo inlay, and a drop-in mic holder
    Labels are cut into the inside of the body where each part goes (MIC,
    AMP, SPEAKER, BIBOARD, PIN 1 and PIN 40), with grooves in the floor for
    the amp cable lanes and the mic wire run. The font is Liberation Sans
    Bold (OFL), bundled for the build.
    The LineChef logo is two 0.8 mm inlays, white and red, that glue into
    a pocket in the panel top. A raised logo cannot print: the panel prints
    top down.
    The mic drops in without tools. Its rear edge goes down a slot in a
    post, its bottom edge into a slotted ledge, and a fork under the panel
    holds its top edge. The heat-set insert and the screw are gone.
    [mic_sph0645.stl, mic_sph0645__header.stl, mic_sph0645__mic.stl, mic_sph0645__pcb.stl, mic_sph0645__screw.stl, pod_body.step, pod_body.stl, pod_button.step]
2026-10-17 Match the wire colors to the user's photos
    Mic: 3V red, GND black, BCLK blue, DOUT orange, LRCL green, SEL brown.
    Amp cable: G black, V red, BCLK blue, LRC green, DIN yellow. BiBoard:
    TX2 gray, RX2 white, GND black. The splice sleeves are white heat
    shrink, and the Pi legs of the splices take the color of their signal.
    [pod_body.step, pod_button.step, pod_camera_base_low.step, pod_camera_cradle_low.step, pod_camera_mount.step, pod_panel.step]
2026-10-17 Stand the amp upright and reverse the mic pin order
    The user's photos show the amp with G and the screw terminal at the
    top. Rev 0.22 had it upside down. The amp wires now fan out 1.6 mm
    apart after the plug, so each one goes down at its own place and none
    crosses another.
    The mic pins are 3V at the bottom and SEL at the top. Each mic wire
    now goes in at its own height, then down into its Pi pin, and the
    jumpers go in from the lowest: 3V first.
    [amp_ns4168.stl, amp_ns4168__headers.stl, amp_ns4168__ic.stl, amp_ns4168__pcb.stl, amp_ns4168__plugs.stl, amp_ns4168__rings.stl, amp_ns4168__screws.stl, amp_ns4168__terminal.stl]
2026-10-17 Route the amp cable as one flat ribbon
    The amp cable is a flat cable of bonded wires (user). It leaves the
    plug on edge, rolls to lie flat as it goes down, and lies flat across
    the floor under the stack, G at the rear and DIN at the front. The
    wires part only in the left well. The model uses a 1.5 mm pitch, and
    the twist eases in and out, so no wire bends tighter than the limit.
    [pod_body.step, pod_body.stl, pod_button.step, pod_camera_base_low.step, pod_camera_cradle_low.step, pod_camera_mount.step, pod_panel.step, wires_amp.stl]
2026-10-17 Lay the amp cable on edge across the front, no twist
    The flat amp cable stays on edge the way it leaves the plug (G on
    top): it steps down 8 mm, runs forward to the front wall, across under
    the mic plugs, and rearward along the left well. Each wire turns in at
    its own height into its pin or splice. It goes in after the BiBoard
    jumpers, because its V wire runs over their Pi ends.
    The BiBoard ends of the uart jumpers are male: the model has their
    pins in the BiBoard sockets.
    [biboard_plug.stl, pod_body.step, pod_body.stl, pod_button.step, pod_camera_base_low.step, pod_camera_cradle_low.step, pod_camera_mount.step, pod_panel.step]
2026-10-17 Add the illustrated build guide and restore the front notch
    guide.py makes the PDF guide from HTML with model renders and
    cable diagrams. Each cable card shows the connector at each end.
    docs.py now calls guide.py for the PDF.
    The body gets back the front-left notch beside the cover notch.
    The amp ribbon jogs behind the notch. The BiBoard jumper ends
    now show their male pins.
    [pod_body.stl, wire_paths.stl, wires_amp.stl, wires_amp__bclk.stl, wires_amp__din.stl, wires_amp__g.stl, wires_amp__lrc.stl, wires_amp__v.stl]
2026-10-17 Lock the camera mount into a twist socket in the panel
    The camera mount turns into a round socket at the old logo place,
    18 mm right of center. Two lugs go down through keyways and turn
    40 deg under the panel top to a stop. A spring tab in the panel top
    clicks a bump into a notch in each lug and keeps 0.2 mm of preload.
    The mount locks the same way turned 180 deg, lens to the rear. The
    old window and its frame are gone.
    The logo moves to the front right corner. The panel also exports as
    pod_panel.3mf with a Cura support blocker over the logo pocket. The
    head-off base uses the same socket and prints on its side. One amp
    fork is left, at z 0: the socket is over the rest of the amp.
    [camera.stl, camera__case.stl, pod_body.step, pod_button.step, pod_camera_base_low.step, pod_camera_base_low.stl, pod_camera_cradle_low.step, pod_camera_cradle_low.stl]
2026-10-17 Make the camera mount a round puck and clean up the panel openings
    The camera mount prints standing up. Its pedestal rises into a 45 deg
    cone under a round puck, and the cone sits in a 45 deg countersink in
    the socket hole. The lugs are ring sectors on the bed, so the hole is
    round with two small keyways. The bracket walls follow the puck
    circle. The hooks have 45 deg undersides with a 1.5 mm flat catch and
    a 0.6 mm face at the tip.
    The panel openings are merged into two groups: HDMI with the switch
    window, and the Pi USB, power and charge ports with the tongue end.
    No web between them is under 2 mm. The socket moved 0.4 mm toward the
    center and is smaller, so its slits clear the edge chamf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
    [camera.stl, camera__case.stl, pod_body.step, pod_button.step, pod_camera_base_low.step, pod_camera_base_low.stl, pod_camera_cradle_low.step, pod_camera_mount.step]
2026-10-17 Give the logo inlay a wider and deeper pocket
    [pod_body.step, pod_button.step, pod_camera_base_low.step, pod_camera_cradle_low.step, pod_camera_mount.step, pod_logo_red.stl, pod_logo_white.stl, pod_panel.3mf]
2026-10-18 Fit the PiSugar S in place of the PiSugar 2
    The robot uses a PiSugar S 1200 mAh. PiSugar has no 3D model of it, so
    pod.py draws a fit model from the PCB drawing in the PiSugar docs. The
    outline, the holes, the switch and the button are at the PiSugar 2
    places within 1 mm. The charge port is USB-C, and the cell sits 0.4 mm
    farther out on two metal discs (estimate).
    The panel changes: the charge opening fits a USB-C plug, the button arm
    is over the new plunger, and the cell clamp moves with the cell. The
    body is unchanged. The PiSugar 2 model is removed.
    [battery.stl, battery__cell.stl, battery__disc.stl, battery__flap.stl, battery__lead0.stl, battery__lead1.stl, pisugar2.stl, pisugar2Board.STL]
2026-10-21 Add hip spacer prototype for a wider stance
    hip_spacer_part.scad is a splined spacer: a female 25T socket for the
    servo shaft, a male stub for the leg gear, and an M2 hole through both.
    hip_spacers.scad shows four of them on the robot, with each leg moved
    out by the spacer thickness.
    The 25T spline, the 5.0 mm shaft and the M2 screw come from the servo
    specs. The other sizes are estimates.
    [hip_spacer_part.scad, hip_spacers.scad]
2026-10-21 Add foot concepts for the Bittle
    wide_foot_part.scad has the foot designs as styles. M is the mech paw
    modeled on the robot wolf: a rounded boot with four toe grooves, a
    window the foot drops into, one pin through both cheeks and the hole in
    the foot, and a backstop lip at the heel as wide as the ankle. Styles
    E to L are pads, Q to S have four teeth, and N and W are paws.
    wide_feet.scad puts a style on each foot of the robot. foot_clearance.py
    poses the legs with robot.py and checks the pads against the body and
    against the opposite leg on the same side.
    The foot sizes, the pin position and the hole size are estimates. The
    swing ranges in foot_clearance.py are assumptions. These are concep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
    [wide_feet.scad, wide_foot_part.scad]
2026-10-21 Add separate spacer plates for the hip servos
    servo_spacer_plates.scad puts two flat plates under each hip servo, one
    under each of the servo's own tabs, so the servo and the leg sit 4 mm
    farther out. Each plate has the footprint of the tab and an M2 hole.
    The middle is open for the servo body. The screws are 4 mm longer.
    The tab outline (32.5 x 12.2 mm, turned 30 degrees) comes from the
    servo mesh. The tab thickness, the seat face and the screw depth are
    estimates. frame_full.scad, frame_view.scad and servo_view.scad show
    the frame and one servo alone.
    [frame_full.scad, frame_view.scad, servo_spacer_plates.scad, servo_view.scad]
2026-10-21 Add spacers shaped like the frame pads
    servo_spacers_frame_shape.scad gives each hip servo screw a spacer
    with the outline of the frame's own pad around the hole, 4 mm thick,
    with the hole continuing through. The servo and leg sit 4 mm farther
    out. The spacers can be printed separately or fused to the frame.
    The hole positions and the seat face (35.9 mm from the centerline) are
    measured on the side shoulder mesh. The spacer thickness, the tab
    thickness and the screw depth are estimates.
    [servo_spacers_frame_shape.scad]
2026-10-21 Add side shoulders made 0.2 in wider
    shoulders_wider.scad cuts each side shoulder along the middle of its
    width, moves the inner half in and the outer half out by 0.1 in each,
    and fills the gap with the shoulder's own cross-section at the cut. The
    shoulder is 0.2 in wider and unchanged in length and height. The servo
    seats move out 0.1 in. shoulders_original.scad shows the two shoulders
    unchanged.
    The inner half moves toward the center, which narrows the space between
    the shoulders. That space is not checked against the battery, the lid
    or the plates. The exported mesh is not watertight, and the cause is
    not found.
    [shoulders_original.scad, shoulders_wider.scad]
2026-10-21 Add side shoulders with a 10 mm collar under the servo seats
    The inner part of each Petoi side shoulder stays in place. The part
    with the servo seats and screw holes moves 10 mm out, and a slice of
    the shoulder's cross-section fills the gap.
    [wide_shoulder.scad]
2026-10-21 Add shoulder experiments with fused pads and a lengthened center
    [frame_lengthened.scad, frame_pads_one_piece.scad]
2026-10-22 Remove the first foot concepts
    The mech paw continues in prototypes/mech_paw, which git ignores.
    [wide_feet.scad, wide_foot_part.scad]
