LineChef/G2bittlex/(notices)

Notices in the files:
build_site.py:
github.com/PiSugar/PiSugar">PiSugar (GPL-3.0).
